dfmcwhir/Multi_Architecture_DIY_Computer/Add-On_Cards/ISA_ESP32_VGA/Firmware/esp32s3-vga-adapter/docs/demo-frame.png

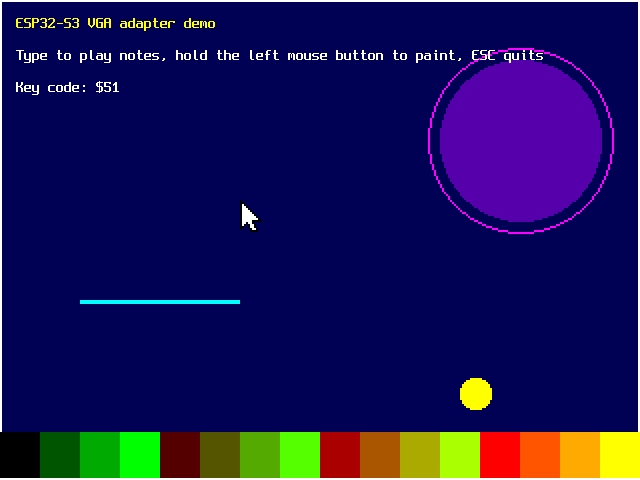
Add-On_Cards/ISA_ESP32_VGA/Firmware/esp32s3-vga-adapter/docs/demo-frame.png
