dfmcwhir/Multi_Architecture_DIY_Computer/ISA_6502/6502_Software/breaker/screenshots/three_balls.png

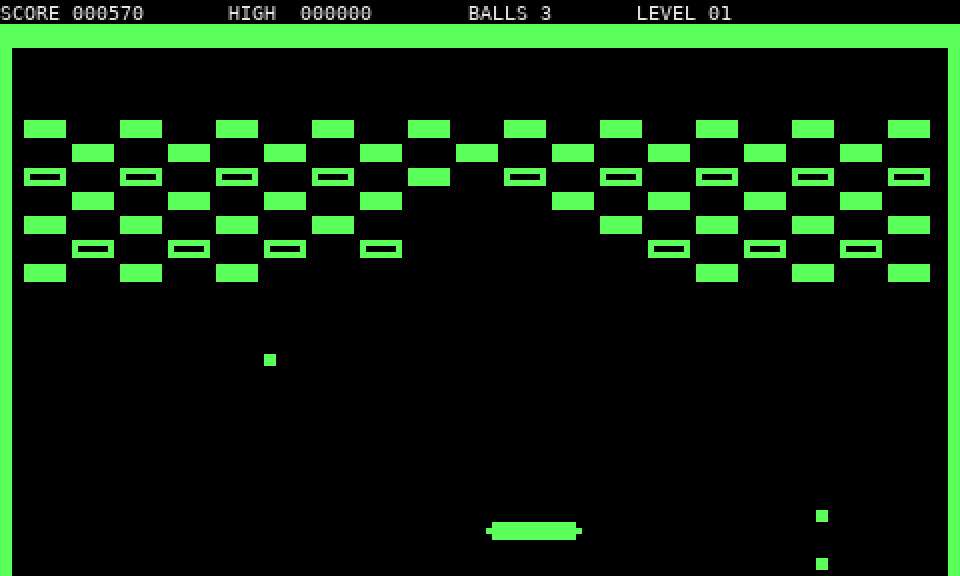
ISA_6502/6502_Software/breaker/screenshots/three_balls.png
