dfmcwhir/Multi_Architecture_DIY_Computer/ISA_6502/6502_Software/doom/screenshots/brute.png

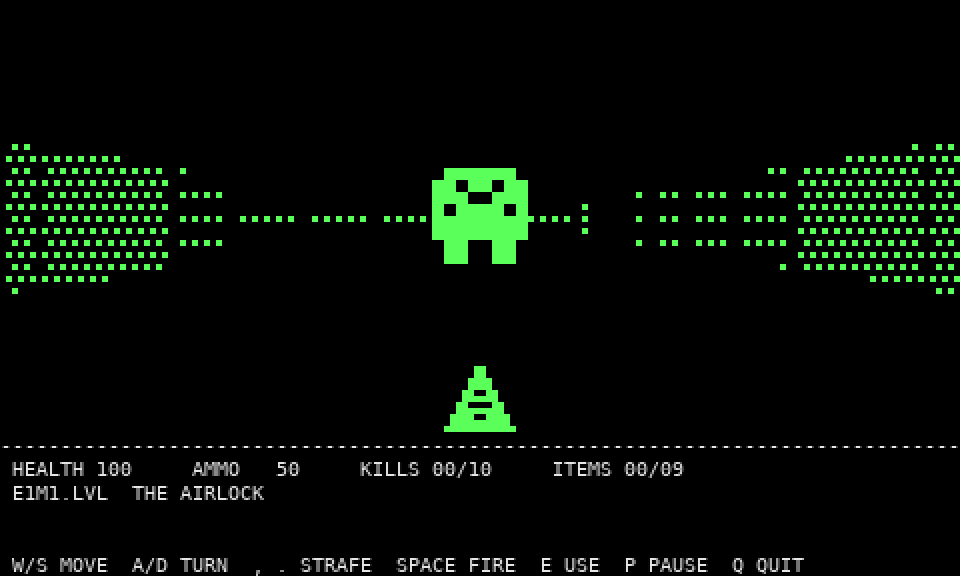
ISA_6502/6502_Software/doom/screenshots/brute.png
