dfmcwhir/Multi_Architecture_DIY_Computer/ISA_6502/6502_Software/doom/screenshots/e1m2.png

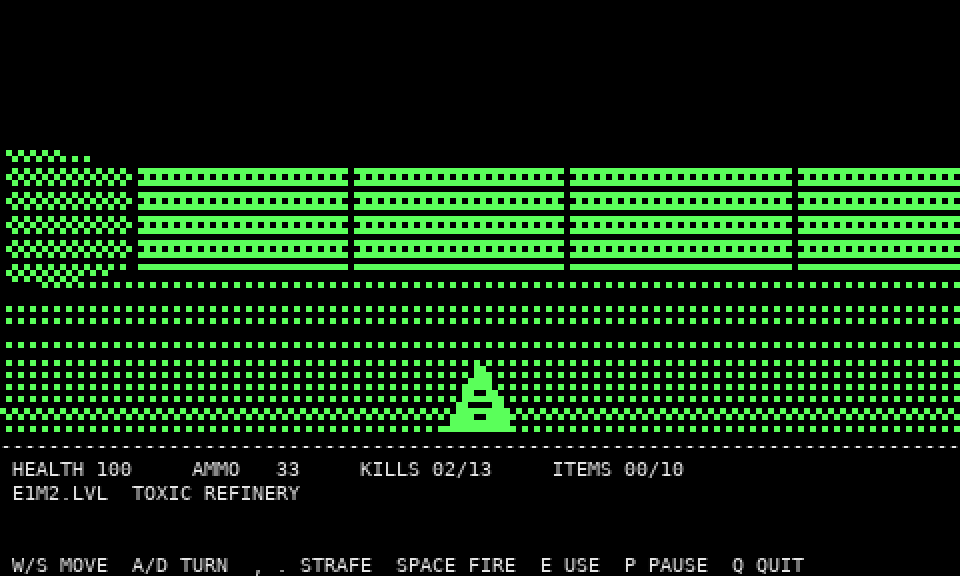
ISA_6502/6502_Software/doom/screenshots/e1m2.png
