dfmcwhir/Multi_Architecture_DIY_Computer/ISA_6502/6502_Software/doom/screenshots/no_sbc_load.png

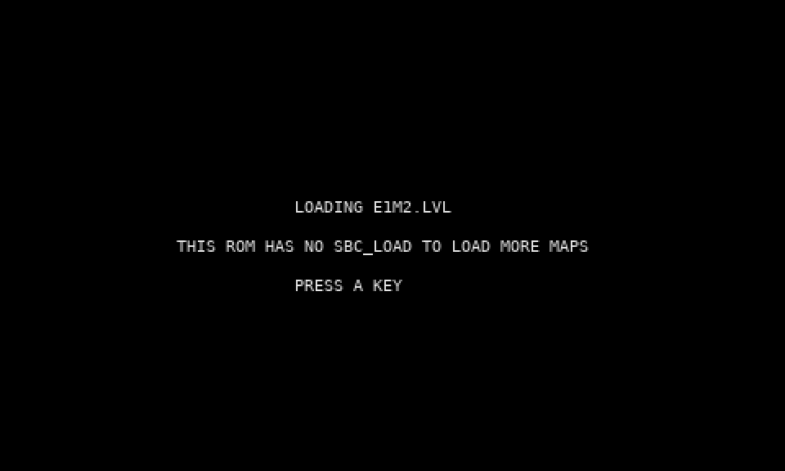
ISA_6502/6502_Software/doom/screenshots/no_sbc_load.png
