dfmcwhir/Multi_Architecture_DIY_Computer/ISA_6502/6502_Software/grabber/screenshots/title.png

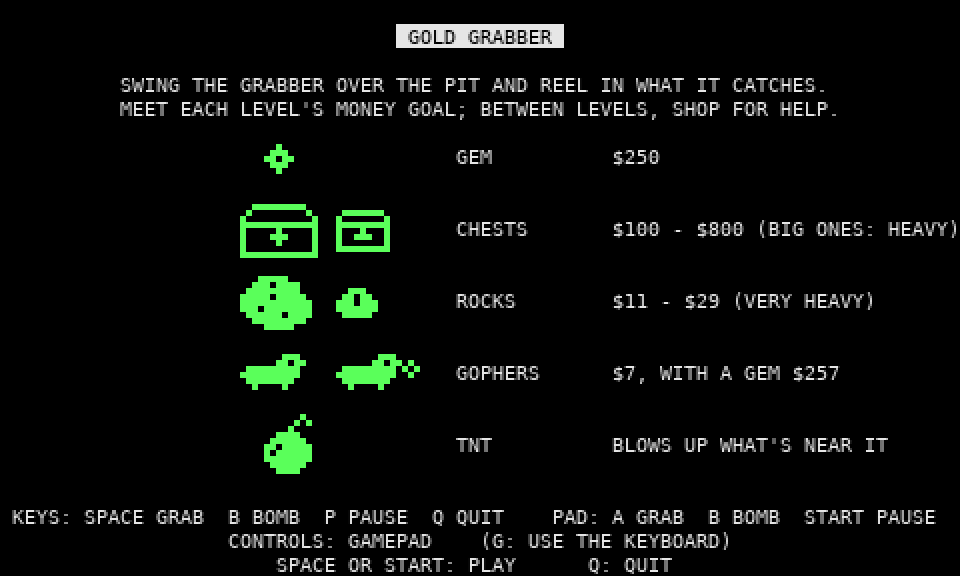
ISA_6502/6502_Software/grabber/screenshots/title.png
