dfmcwhir/Multi_Architecture_DIY_Computer/ISA_6502/6502_Software/invaders/screenshots/later_wave.png

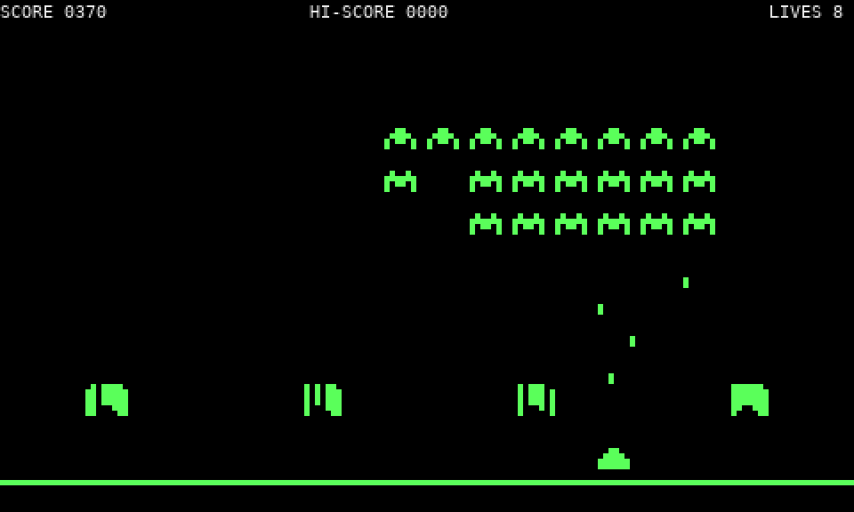
ISA_6502/6502_Software/invaders/screenshots/later_wave.png
