dfmcwhir/Multi_Architecture_DIY_Computer/ISA_6502/6502_Software/miner/screenshots/boot_sector.png

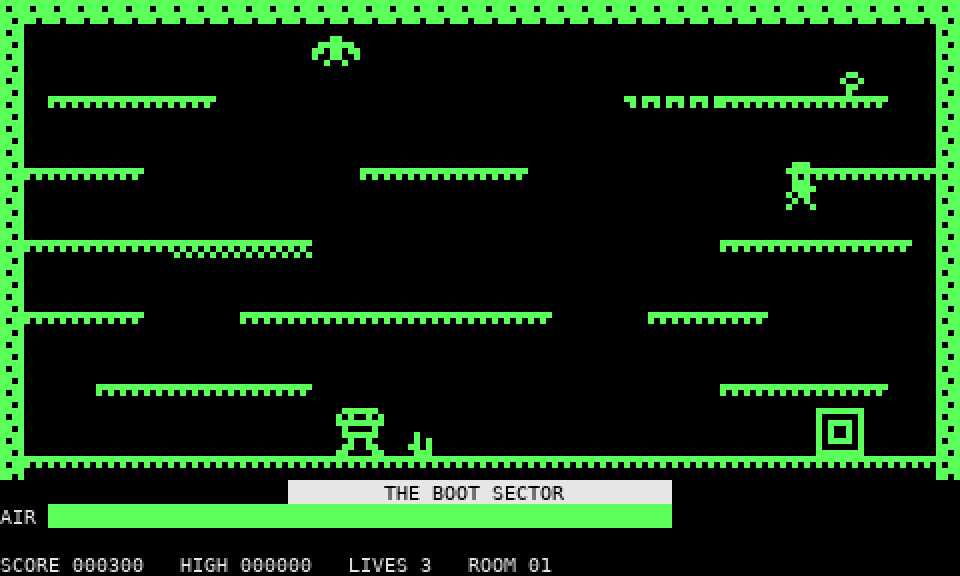
ISA_6502/6502_Software/miner/screenshots/boot_sector.png
