dfmcwhir/Multi_Architecture_DIY_Computer/ISA_6502/6502_Software/miner/screenshots/reset_vector.png

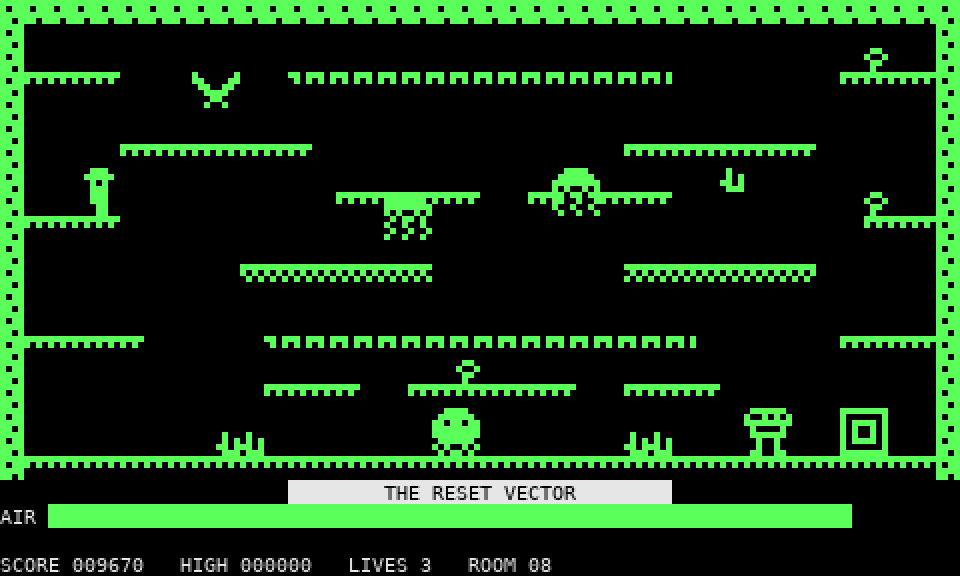
ISA_6502/6502_Software/miner/screenshots/reset_vector.png
