dfmcwhir/Multi_Architecture_DIY_Computer/ISA_6502/6502_Software/miner/screenshots/zero_page.png

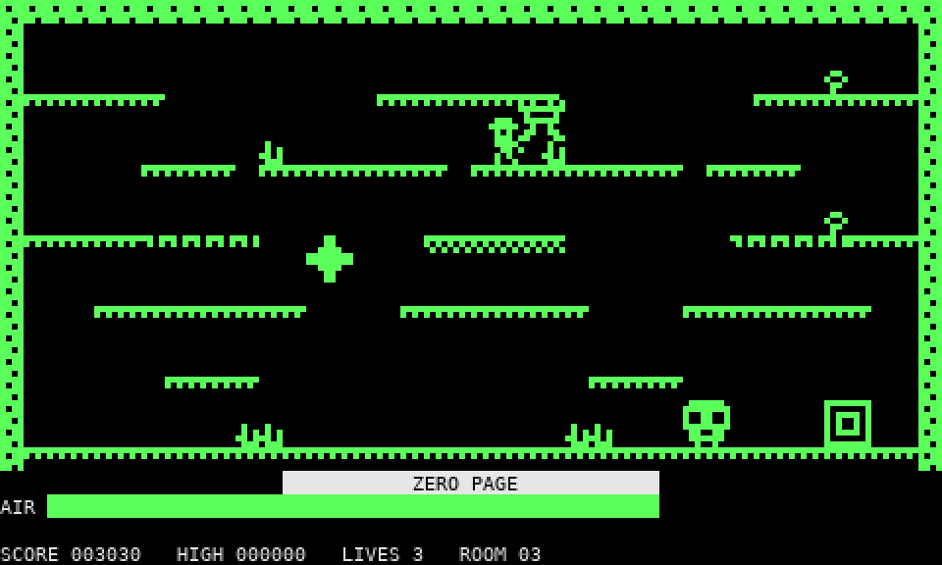
ISA_6502/6502_Software/miner/screenshots/zero_page.png
