dfmcwhir/Multi_Architecture_DIY_Computer/ISA_6502/6502_Software/muncher/screenshots/playing_gamepad.png

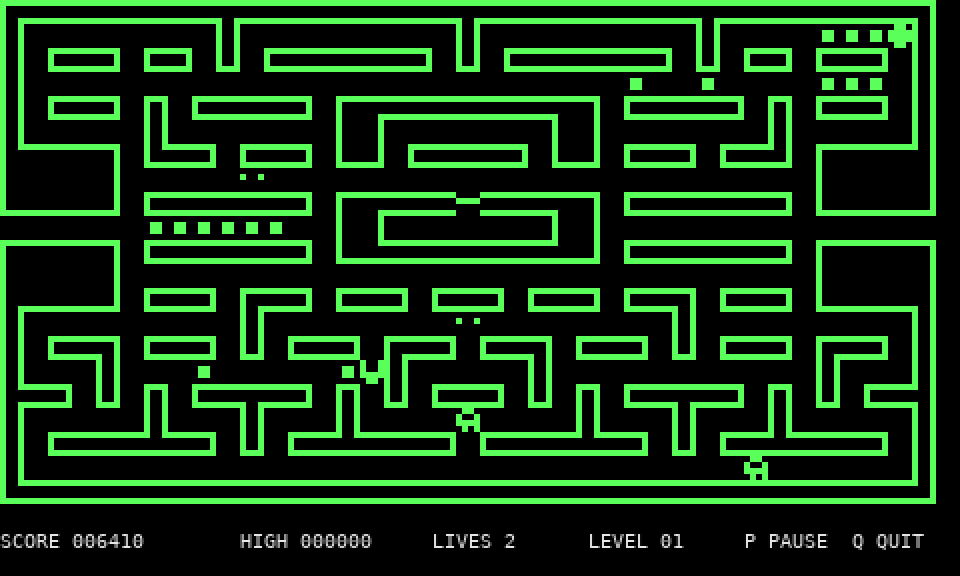
ISA_6502/6502_Software/muncher/screenshots/playing_gamepad.png
