dfmcwhir/Multi_Architecture_DIY_Computer/ISA_6502/6502_Software/rocks/screenshots/saucer.png

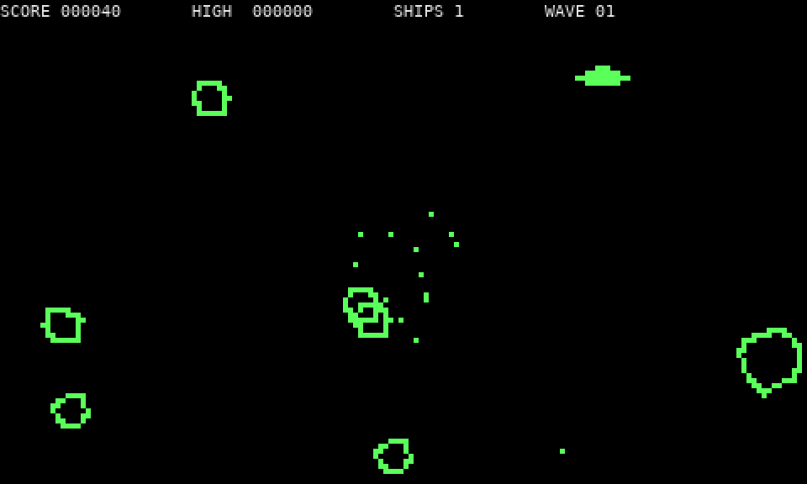
ISA_6502/6502_Software/rocks/screenshots/saucer.png
