dfmcwhir/Multi_Architecture_DIY_Computer/ISA_6502/6502_Software/smb/screenshots/bonus_exit_1-2.png

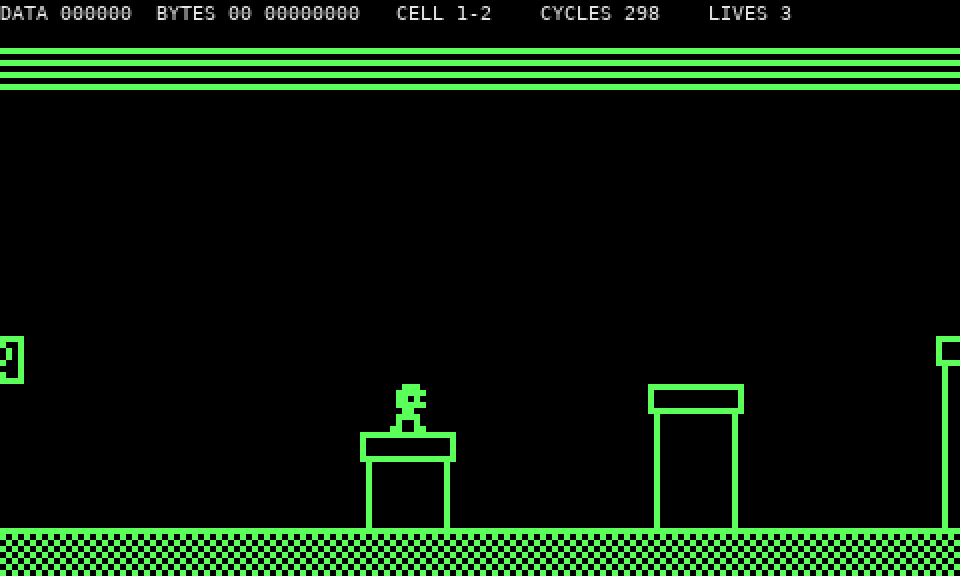
ISA_6502/6502_Software/smb/screenshots/bonus_exit_1-2.png
