dfmcwhir/Multi_Architecture_DIY_Computer/ISA_6502/6502_Software/smb/screenshots/bonus_room.png

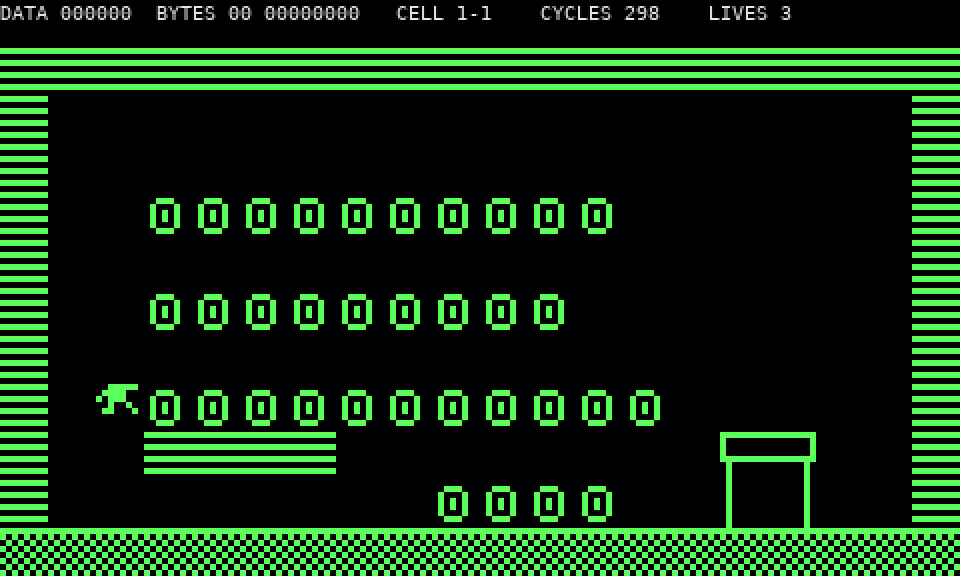
ISA_6502/6502_Software/smb/screenshots/bonus_room.png
