dfmcwhir/Multi_Architecture_DIY_Computer/ISA_6502/6502_Software/smb/screenshots/fire_flower.png

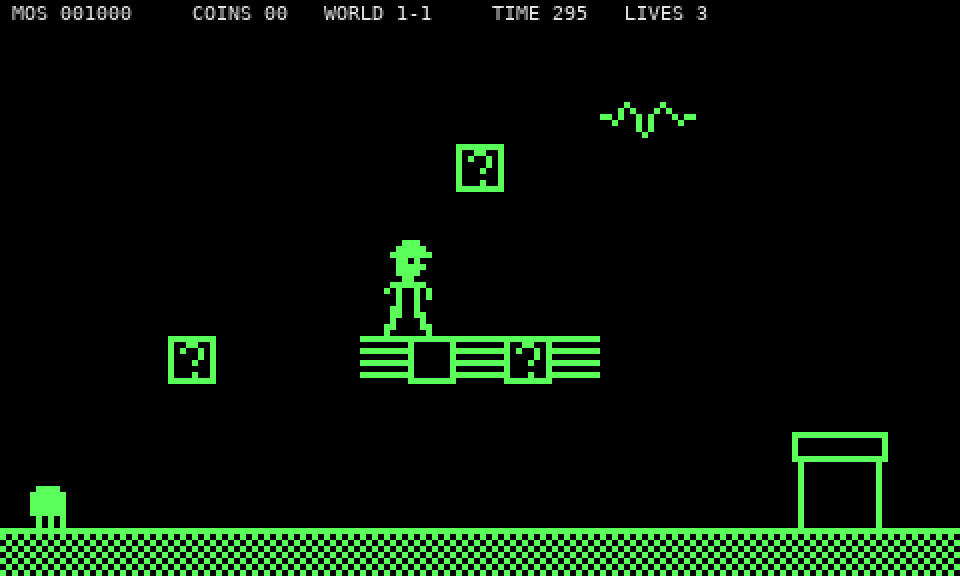
ISA_6502/6502_Software/smb/screenshots/fire_flower.png
