dfmcwhir/Multi_Architecture_DIY_Computer/ISA_6502/6502_Software/smb/screenshots/oc_device.png

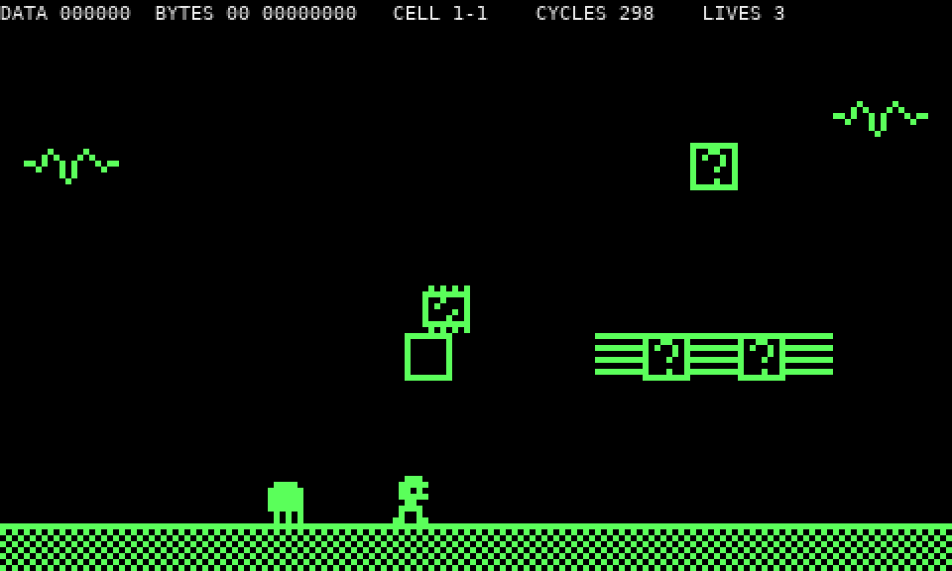
ISA_6502/6502_Software/smb/screenshots/oc_device.png
