dfmcwhir/Multi_Architecture_DIY_Computer/ISA_6502/6502_Software/smb/screenshots/terminal_sprites.png

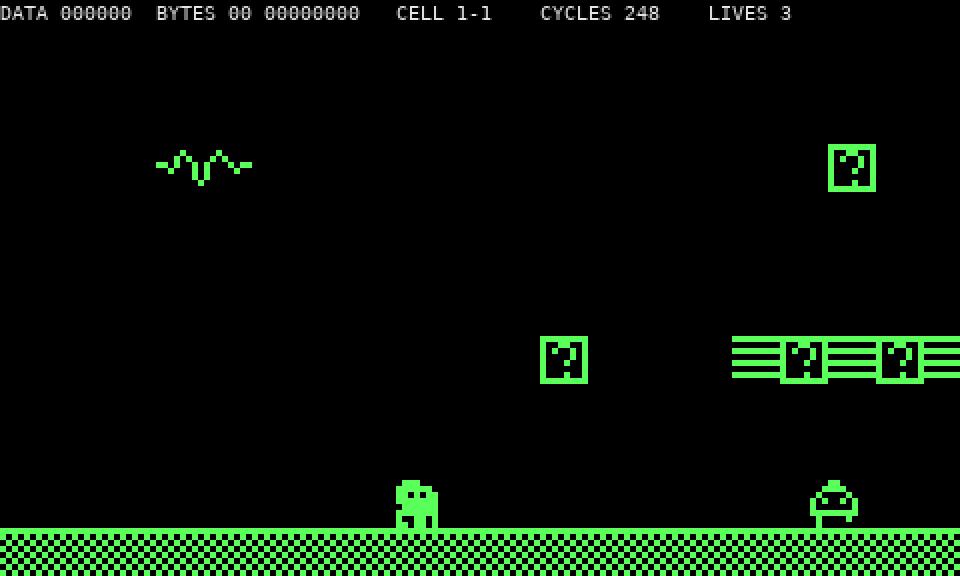
ISA_6502/6502_Software/smb/screenshots/terminal_sprites.png
