dfmcwhir/Multi_Architecture_DIY_Computer/ISA_6502/6502_Software/stacker/screenshots/playing.png

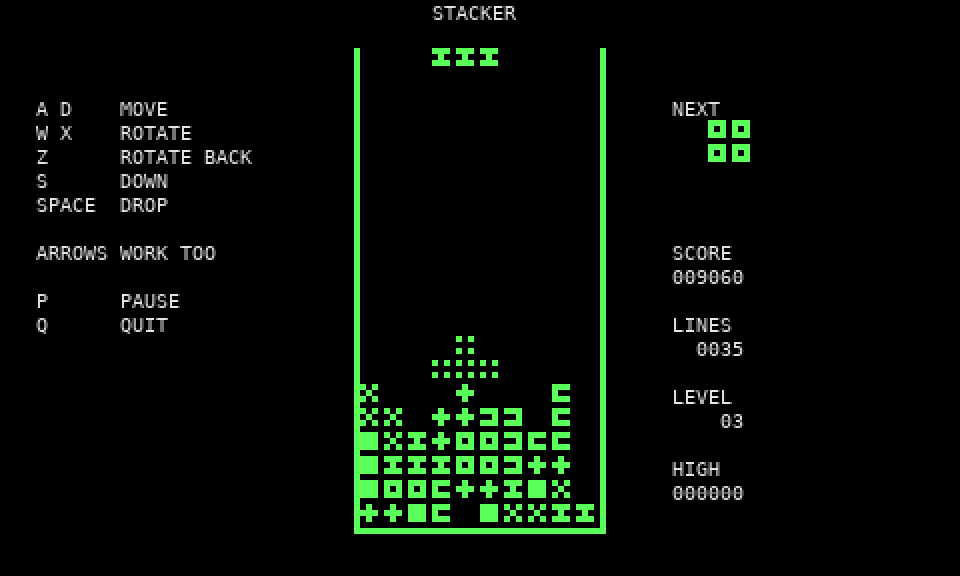
ISA_6502/6502_Software/stacker/screenshots/playing.png
