dfmcwhir/Multi_Architecture_DIY_Computer/ISA_6502/6502_Software/critters/screenshots/level4_building.png

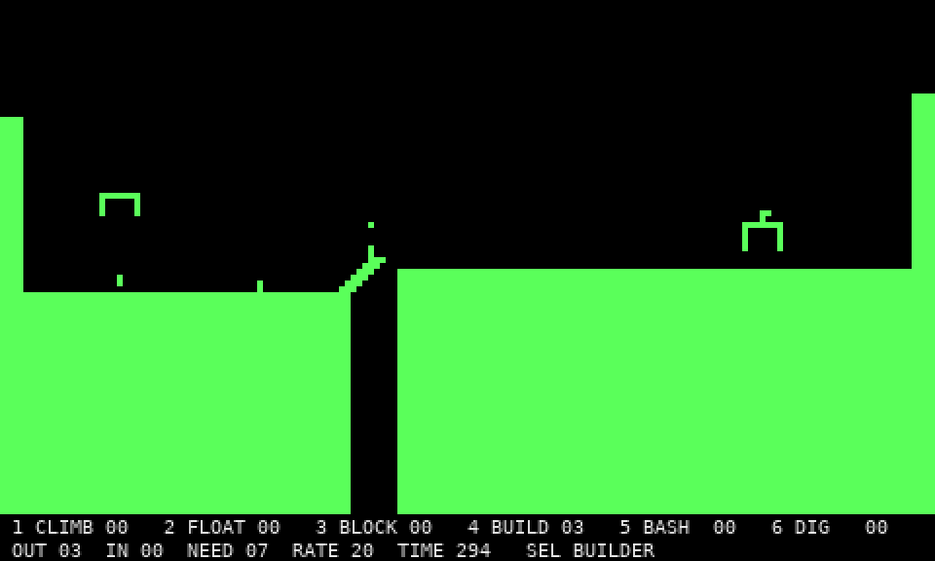
ISA_6502/6502_Software/critters/screenshots/level4_building.png
