dfmcwhir/Multi_Architecture_DIY_Computer/ISA_Z80/ISA_Z80_Schematics.pdf

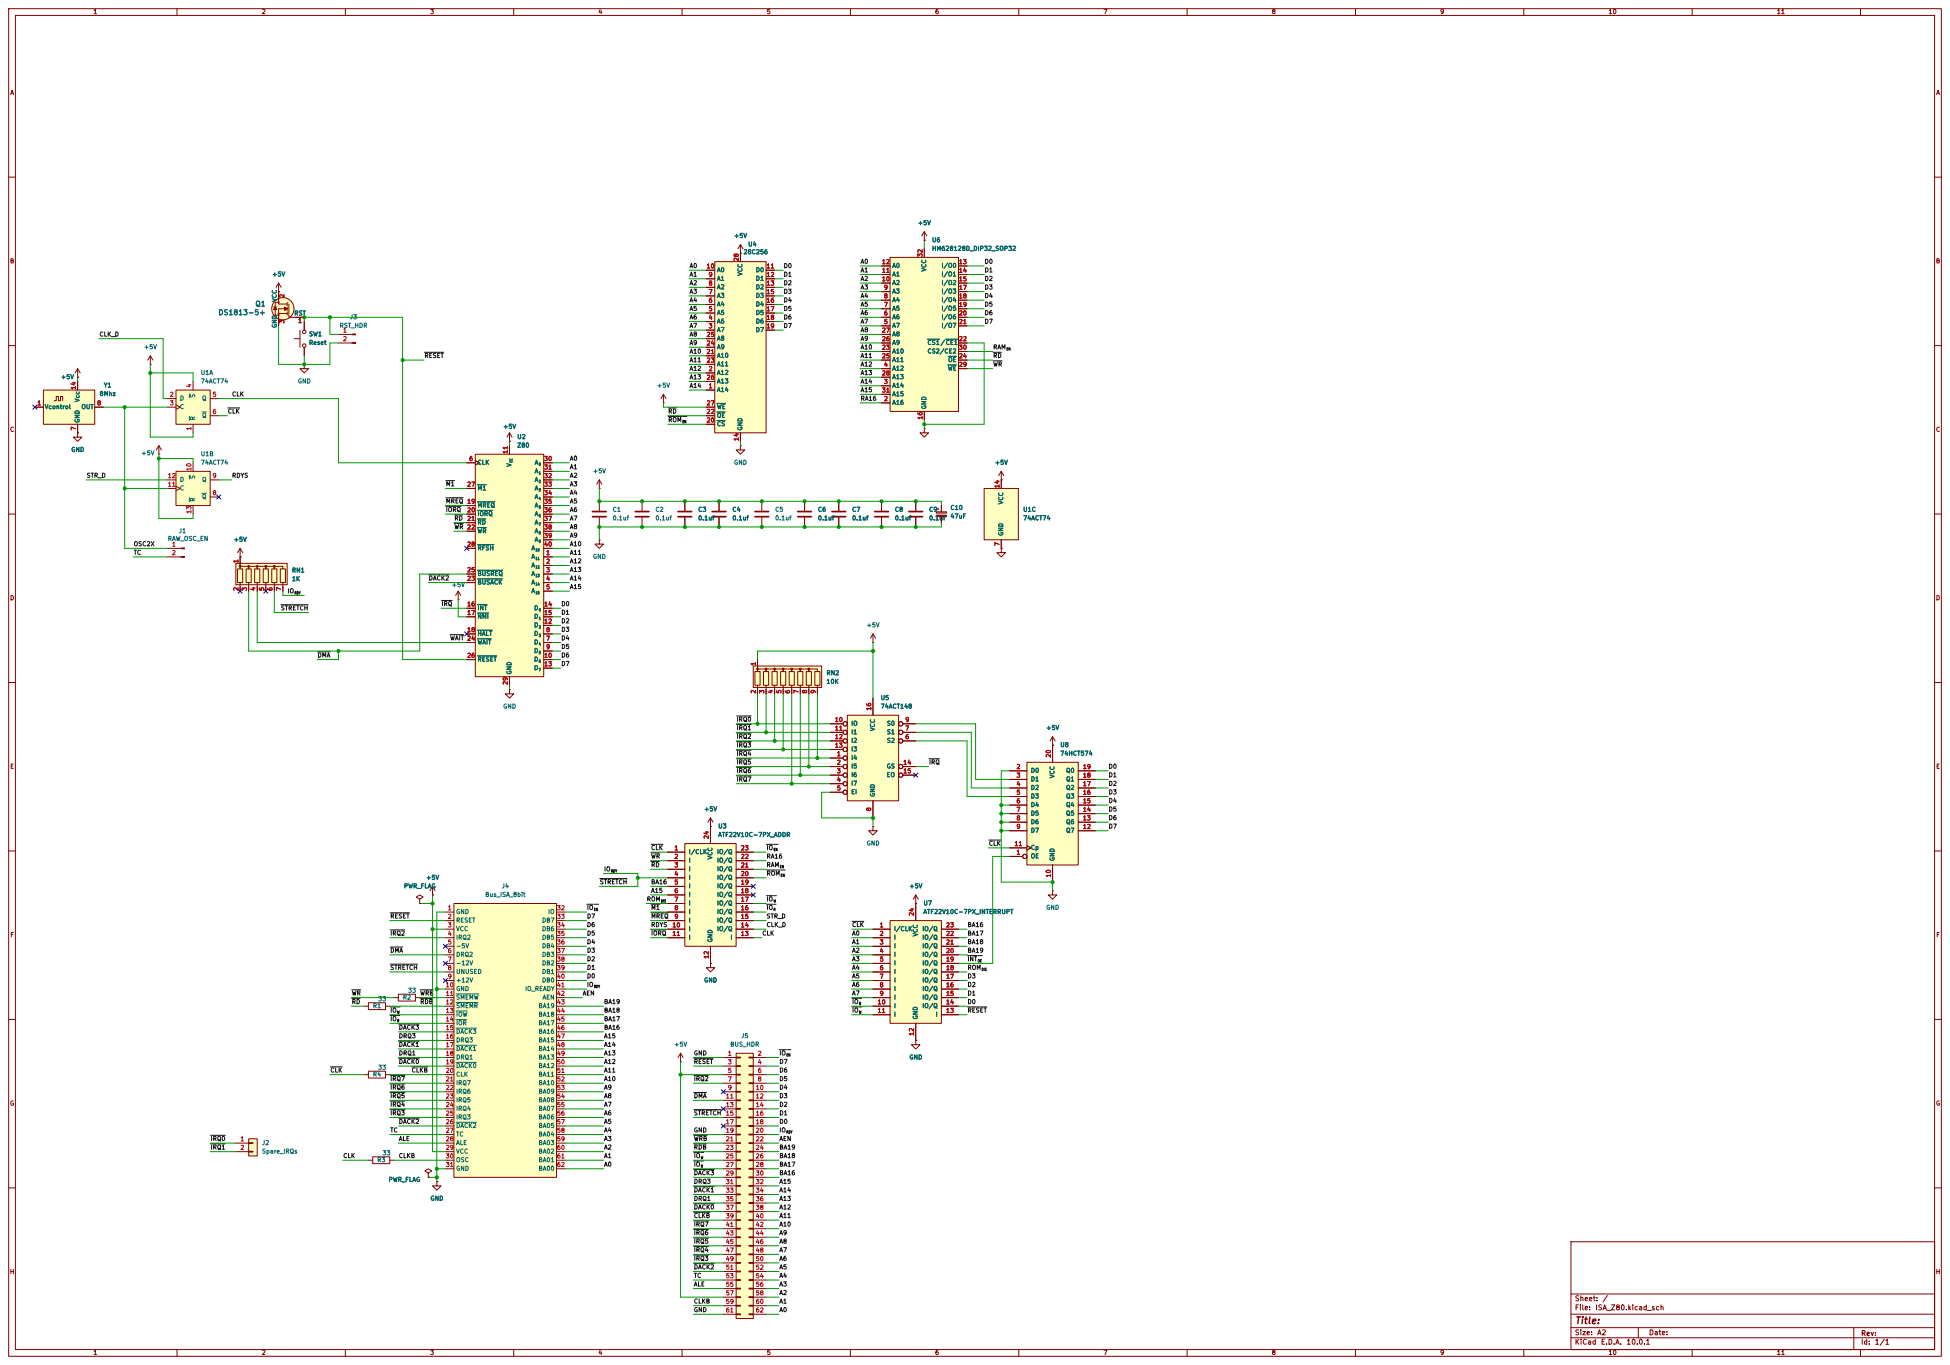
[picture p75: page 1]

Size: A2 | Rev:
KiCad E.D.A. 10.0.1 | Id: 1/1
