dfmcwhir/Multi_Architecture_DIY_Computer/Add-On_Cards/ISA_PICO9918_VGA/ISA_PICO9918_VGA_Schematics.pdf

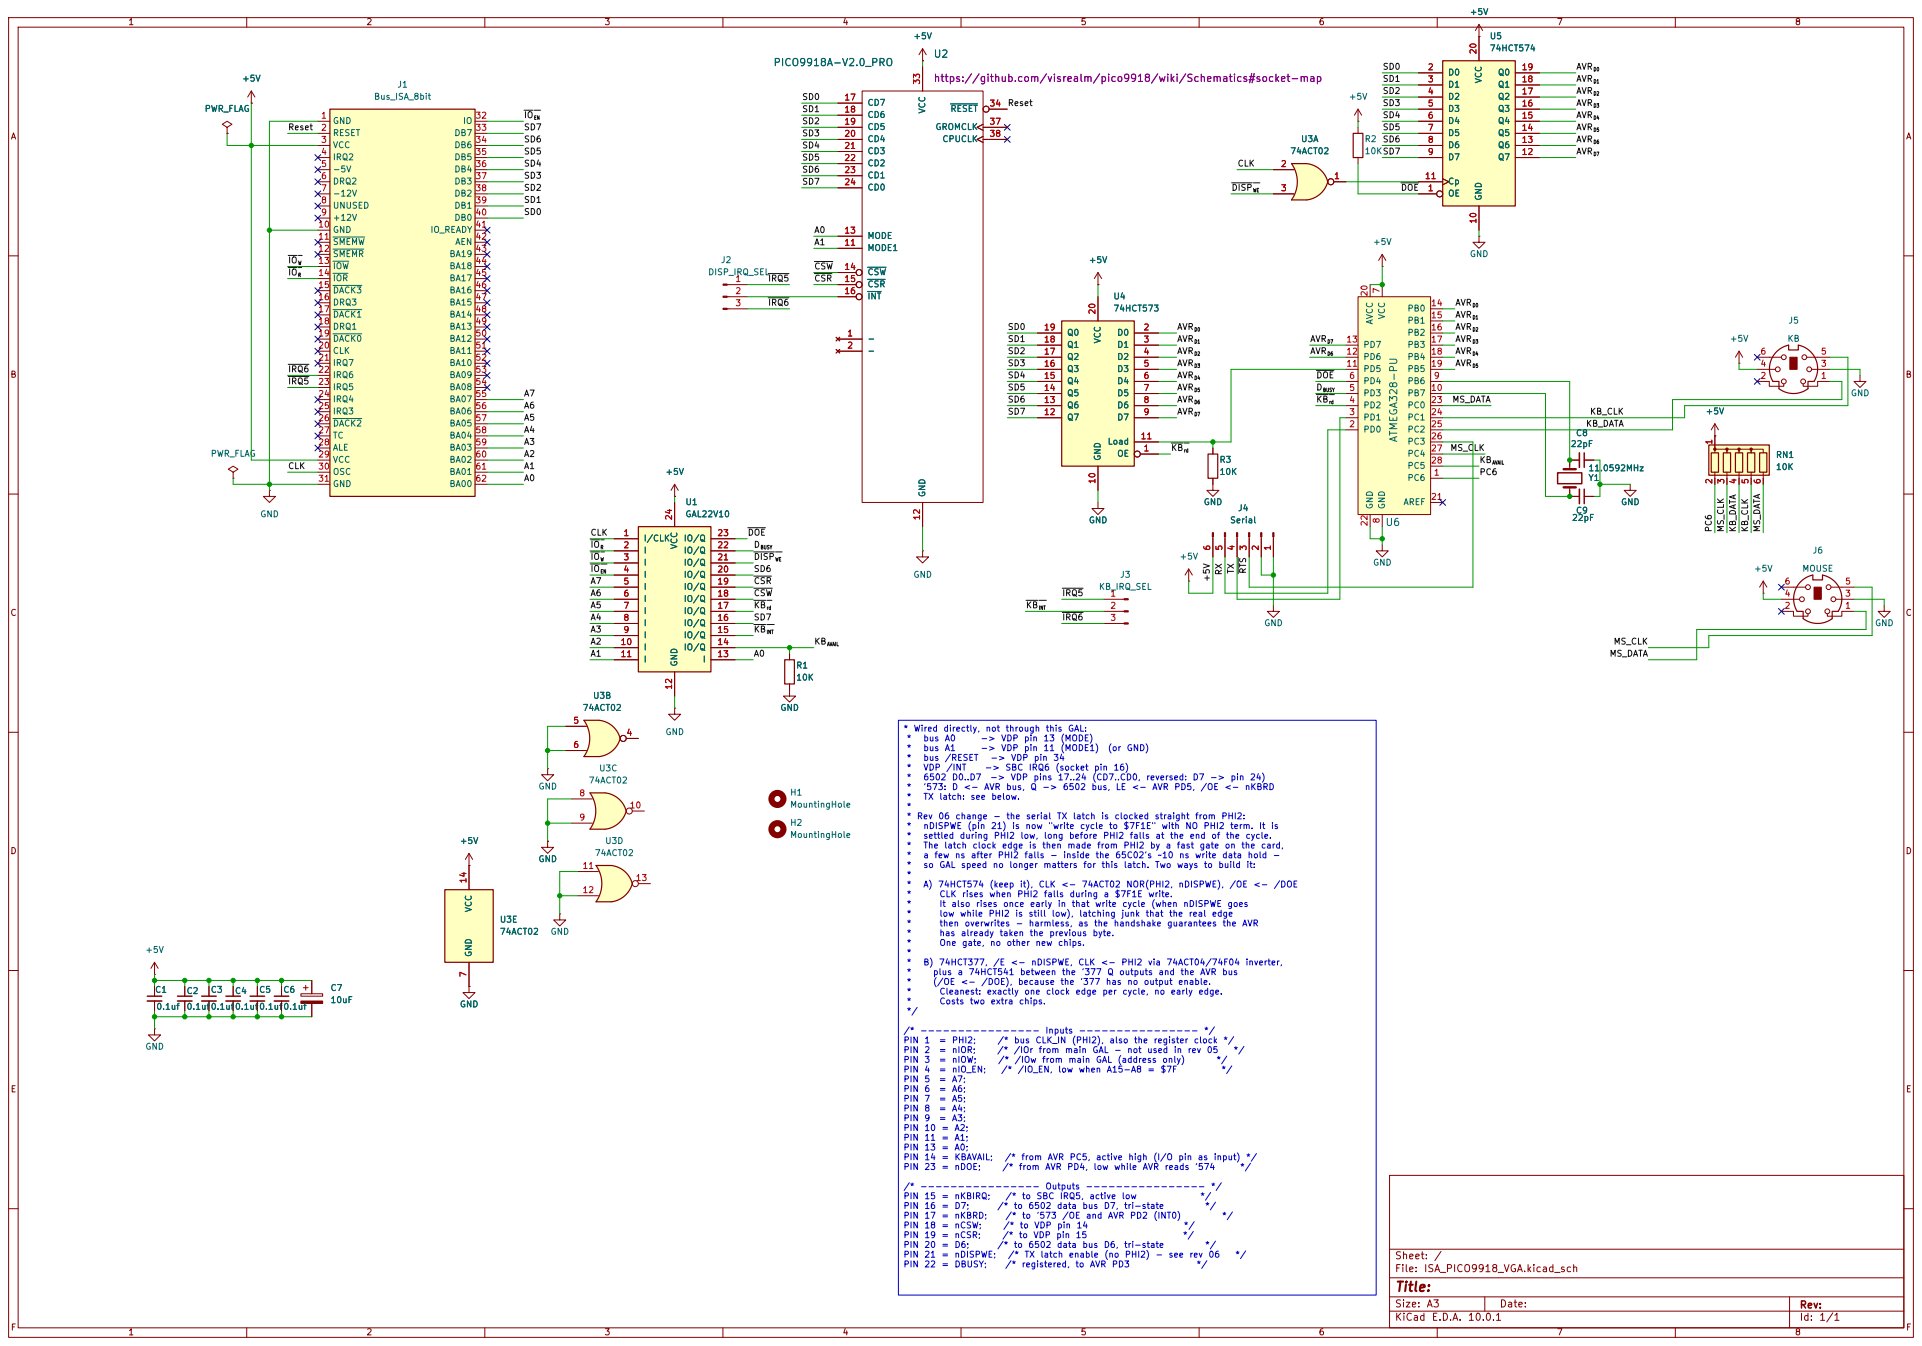
[picture p76: page 1]

https://github.com/visrealm/pico9918/wiki/Schematics#socket-map -

https://github.com/visrealm/pico9918/wiki/Schematics#socket-map
Reset SD5

Size: A3 | Rev: | F Date:
KiCad E.D.A. 10.0.1 | Id: 1/1
