dfmcwhir/Multi_Architecture_DIY_Computer/Add-On_Cards/ISA_AY-3-8910_Sound/ISA_AY-3-8910_Sound_schematics.pdf

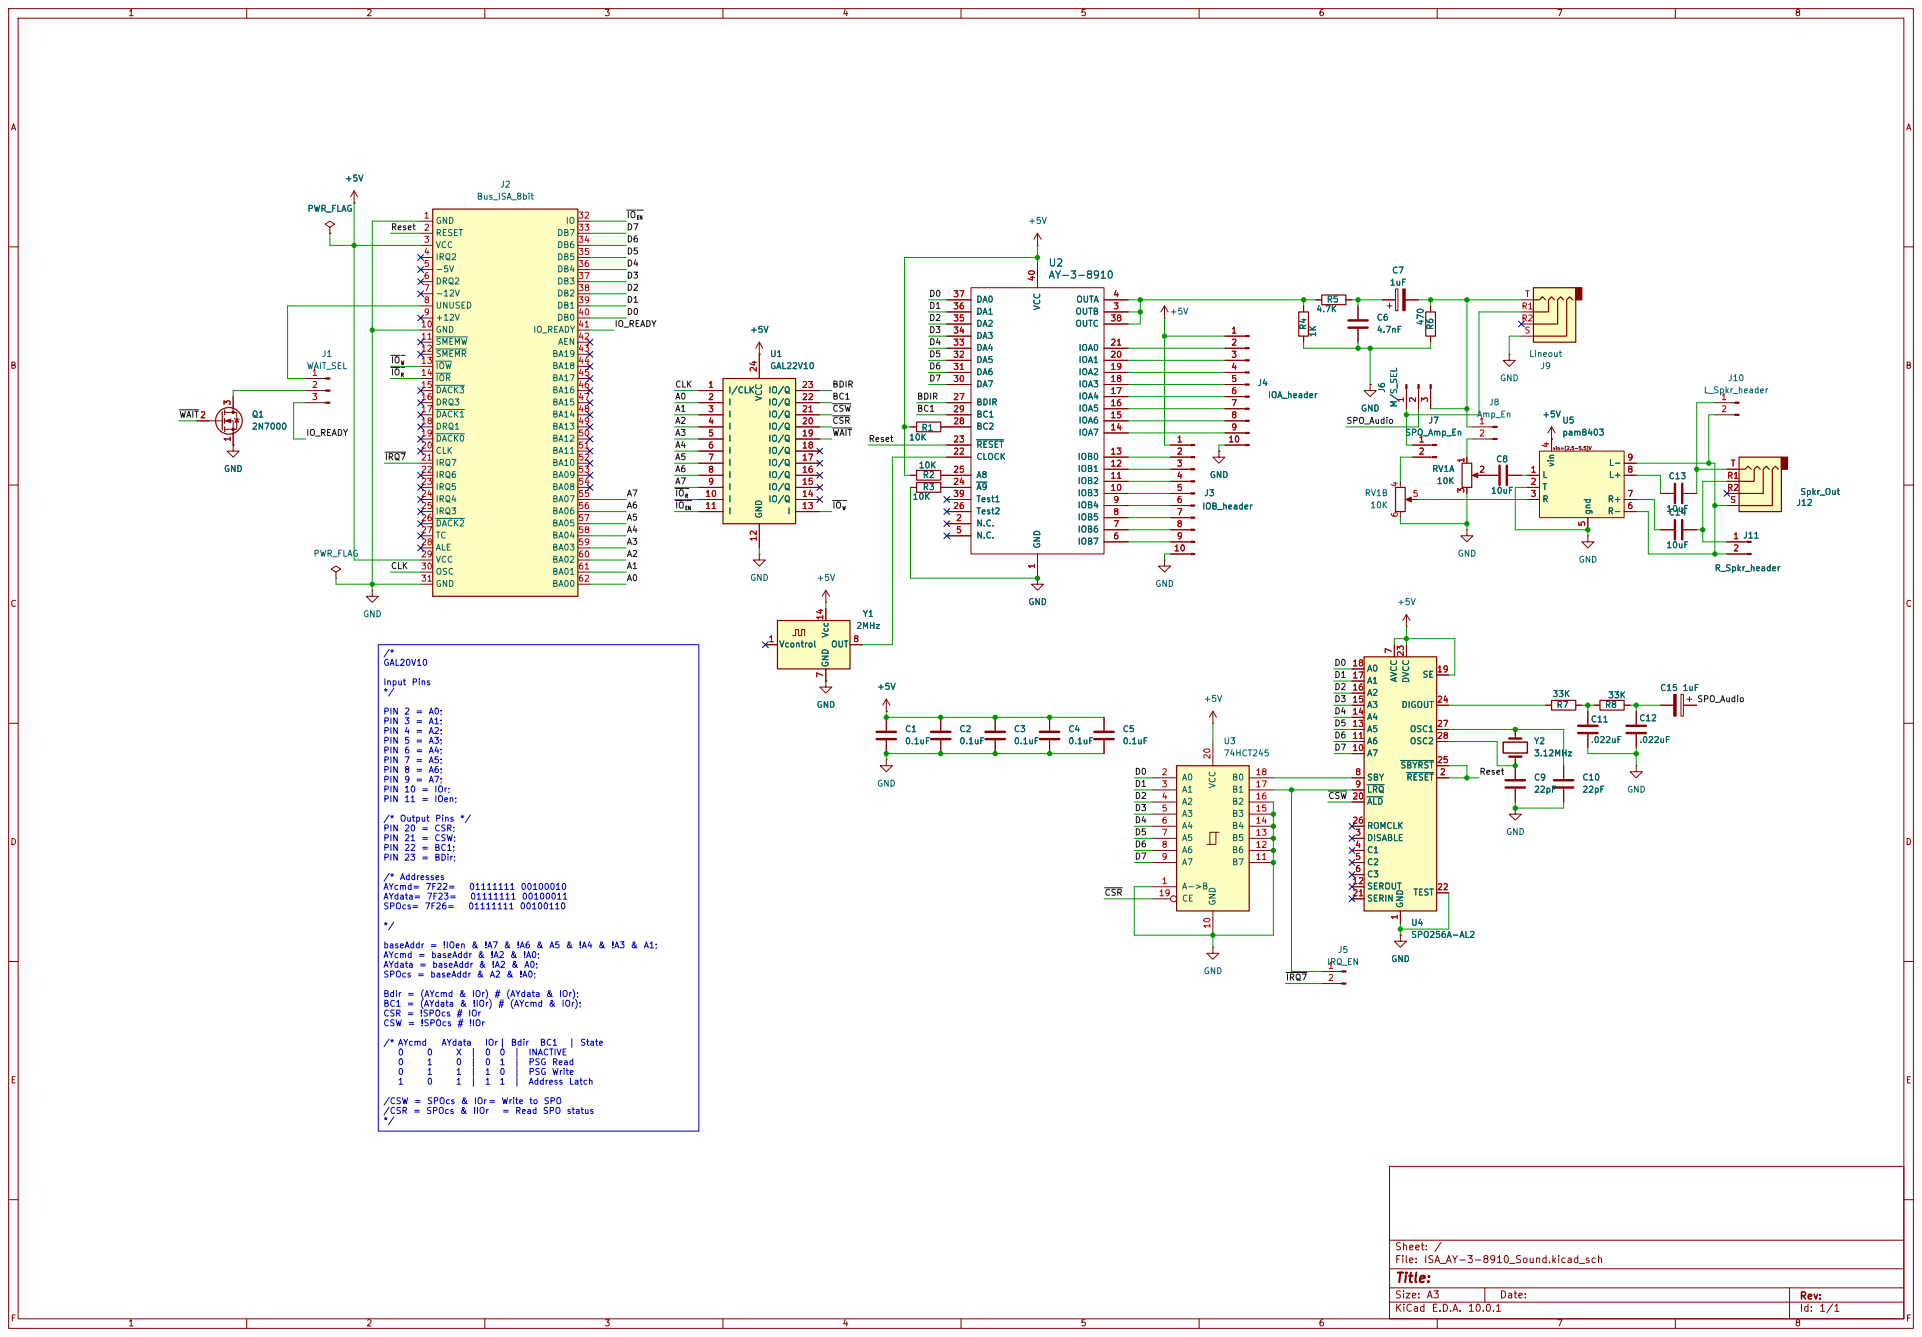
[picture p77: page 1]

PIN 2 = A0; PIN 3 = A1; PIN 4 = A2; PIN 5 = A3; PIN 6 = A4; PIN 7 = A5; PIN 8 = A6; PIN 9 = A7; PIN 10 = IOr; PIN 11 = IOen;

/* Output Pins */
PIN 20 = CSR; PIN 21 = CSW; PIN 22 = BC1; PIN 23 = BDir;

Size: A3 | Rev: | F Date:
KiCad E.D.A. 10.0.1 | Id: 1/1
