dfmcwhir/Multi_Architecture_DIY_Computer/Add-On_Cards/ISA_ESP32_VGA/ISA_ESP32_VGA_Schematics.pdf

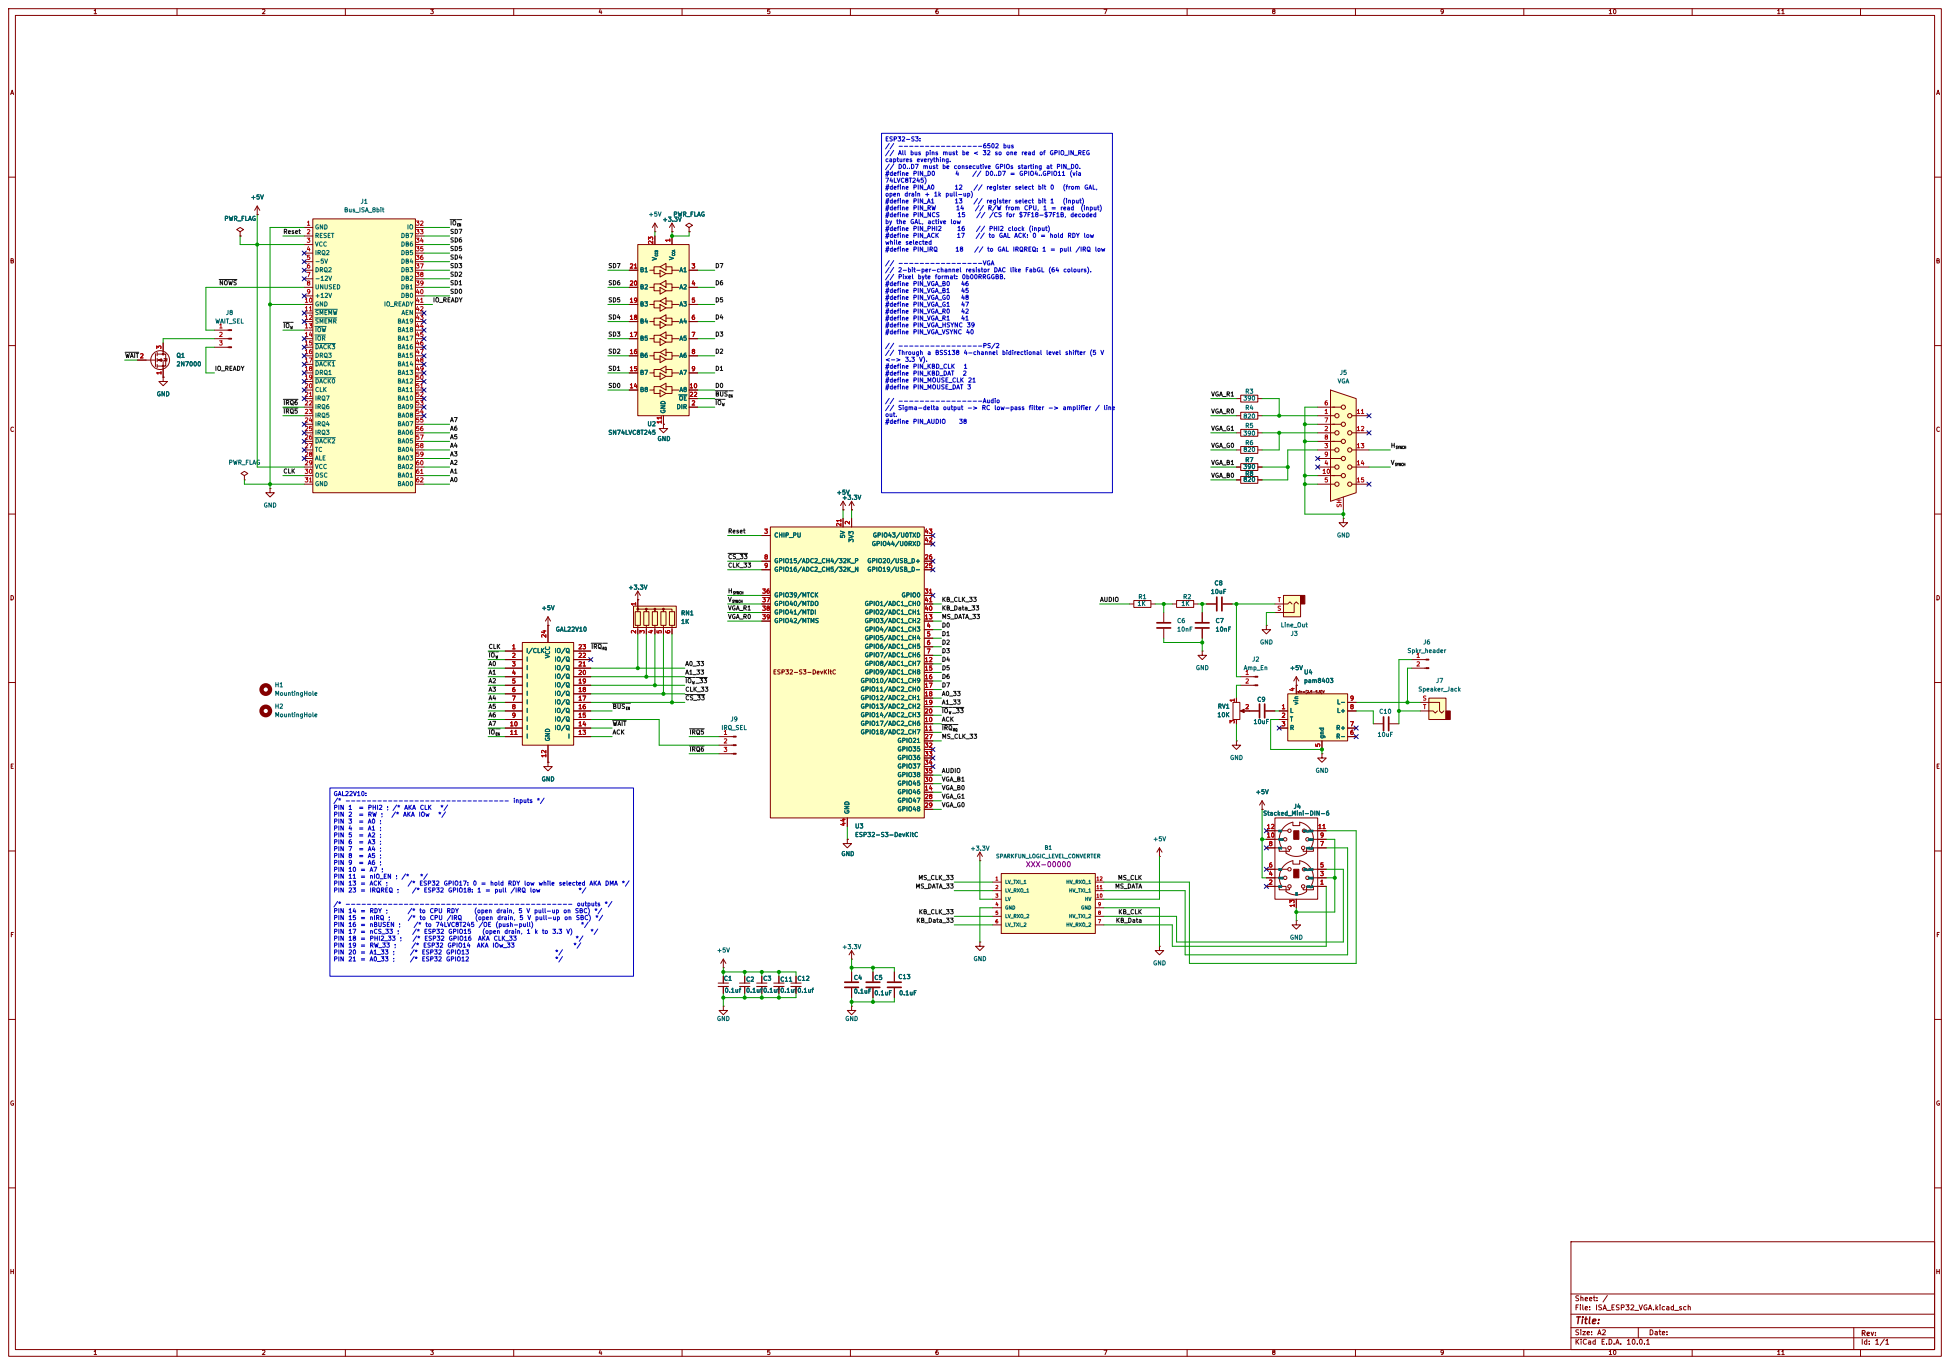
[picture p78: page 1]

ESP32-S3: // ----------------6502 bus // All bus pins must be < 32 so one read of GPIO_IN_REG

by the GAL, active low

// ----------------VGA // 2-bit-per-channel resistor DAC like FabGL (64 colours).

// Through a BSS138 4-channel bidirectional level shifter (5 V <-> 3.3 V).

Size: A2 | Rev:
KiCad E.D.A. 10.0.1 | Id: 1/1
