dfmcwhir/Multi_Architecture_DIY_Computer/Add-On_Cards/ISA_6502_Memory/ISA_6502_Memory_Schematics.pdf

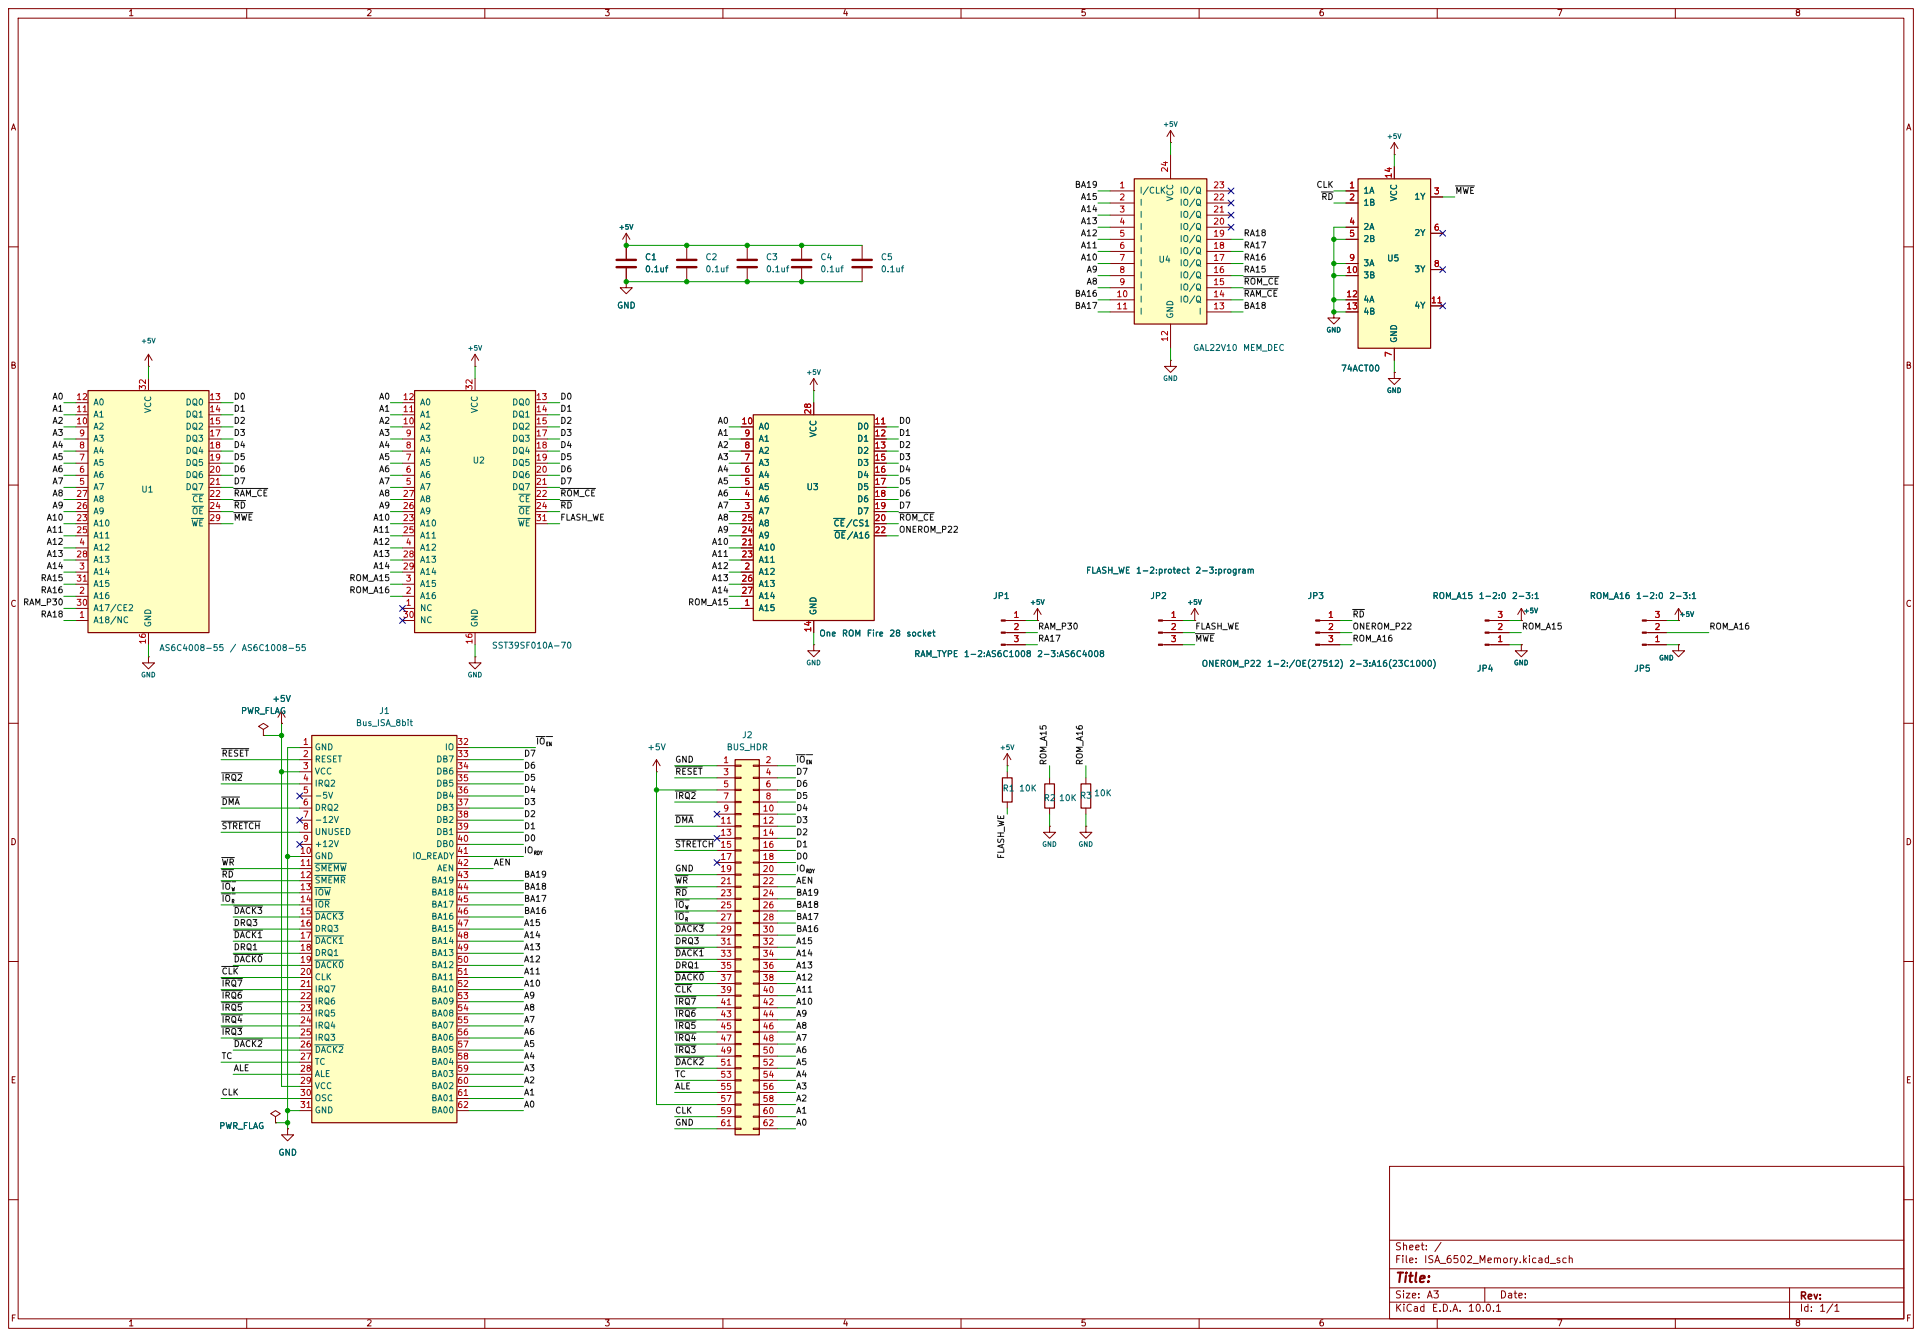
[picture p80: page 1]

Size: A3 | Rev: | F Date:
KiCad E.D.A. 10.0.1 | Id: 1/1
