dfmcwhir/Multi_Architecture_DIY_Computer/ISA_6502/ISA_6502_CPU_REV2/ISA_6502_CPU_REV2_Schematics.pdf

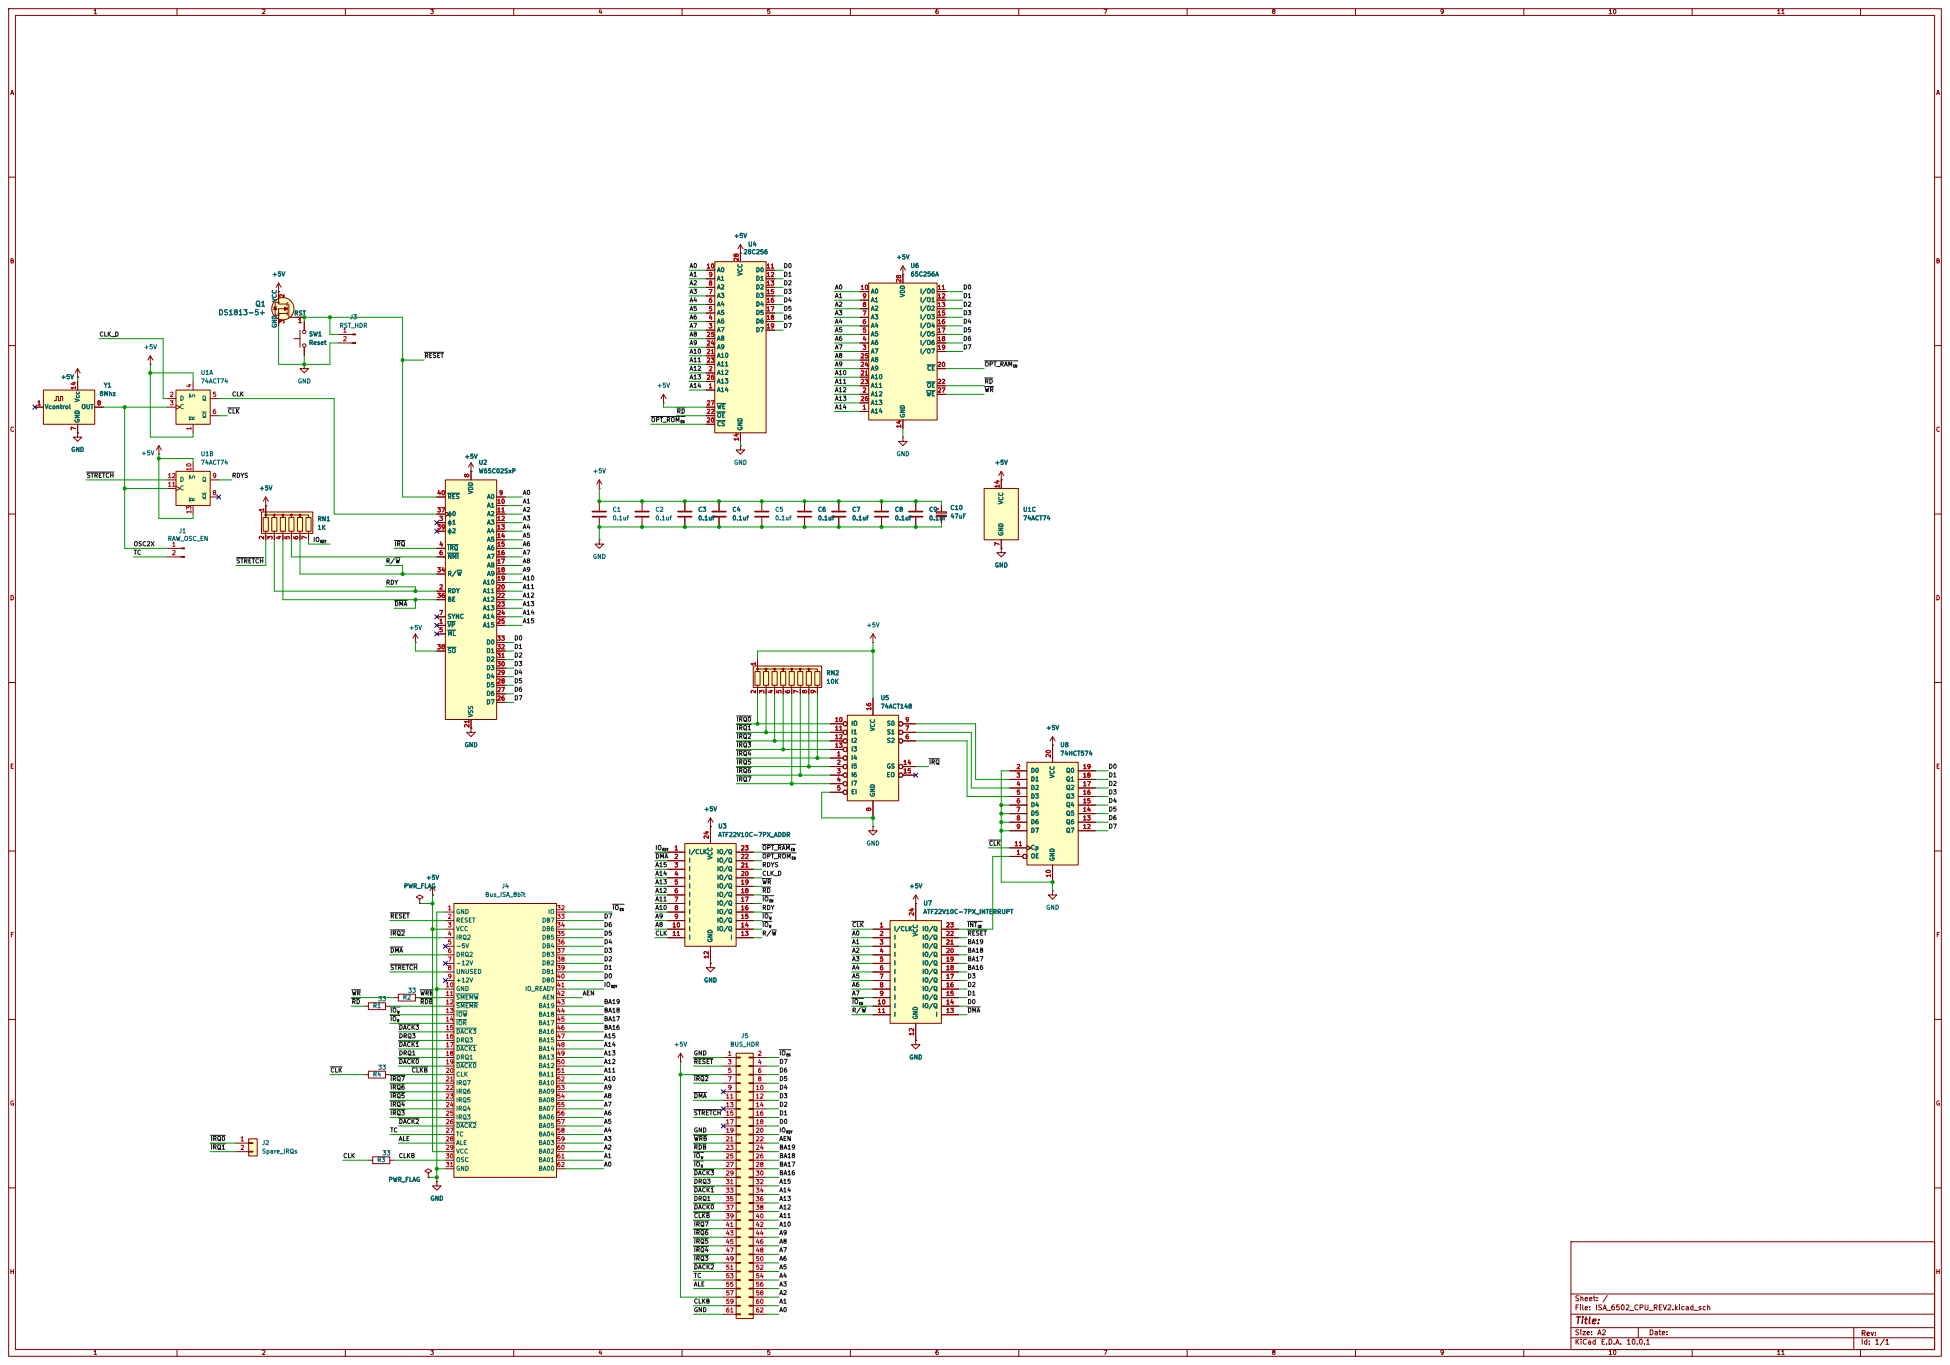
[picture p81: page 1]

Size: A2 | Rev:
KiCad E.D.A. 10.0.1 | Id: 1/1
