dfmcwhir/Multi_Architecture_DIY_Computer/Add-On_Cards/ISA_6502_Serial_Rev3/ISA_6502_Serial_Rev3.pdf

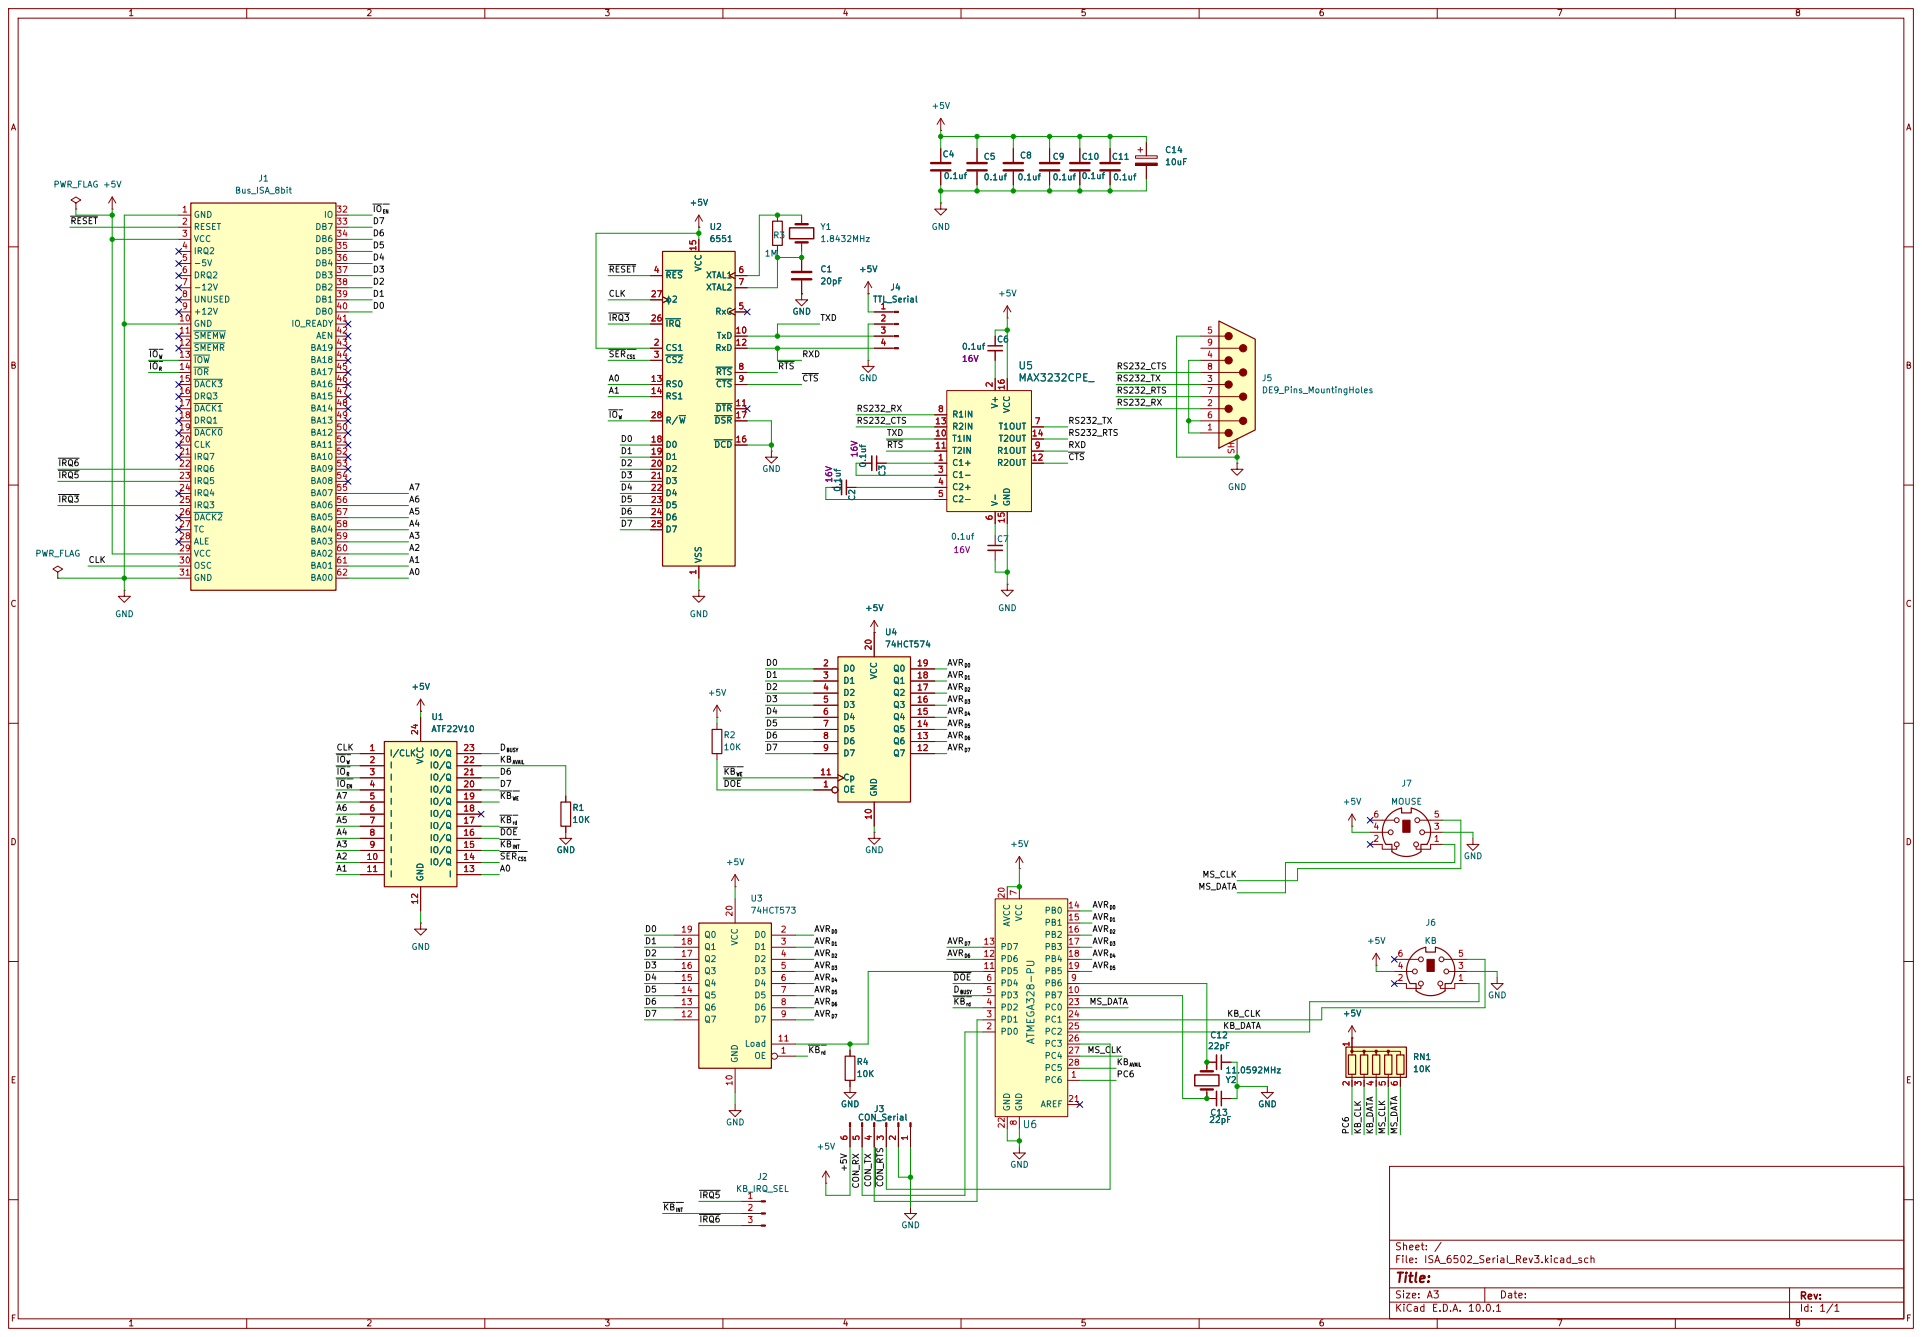
[picture p82: page 1]

Size: A3 | Rev:
KiCad E.D.A. 10.0.1 | Id: 1/1
