dfmcwhir/Multi_Architecture_DIY_Computer/Add-On_Cards/CH376_USB_CARD/CH375_USB_ISA_Card_W_DOC.pdf

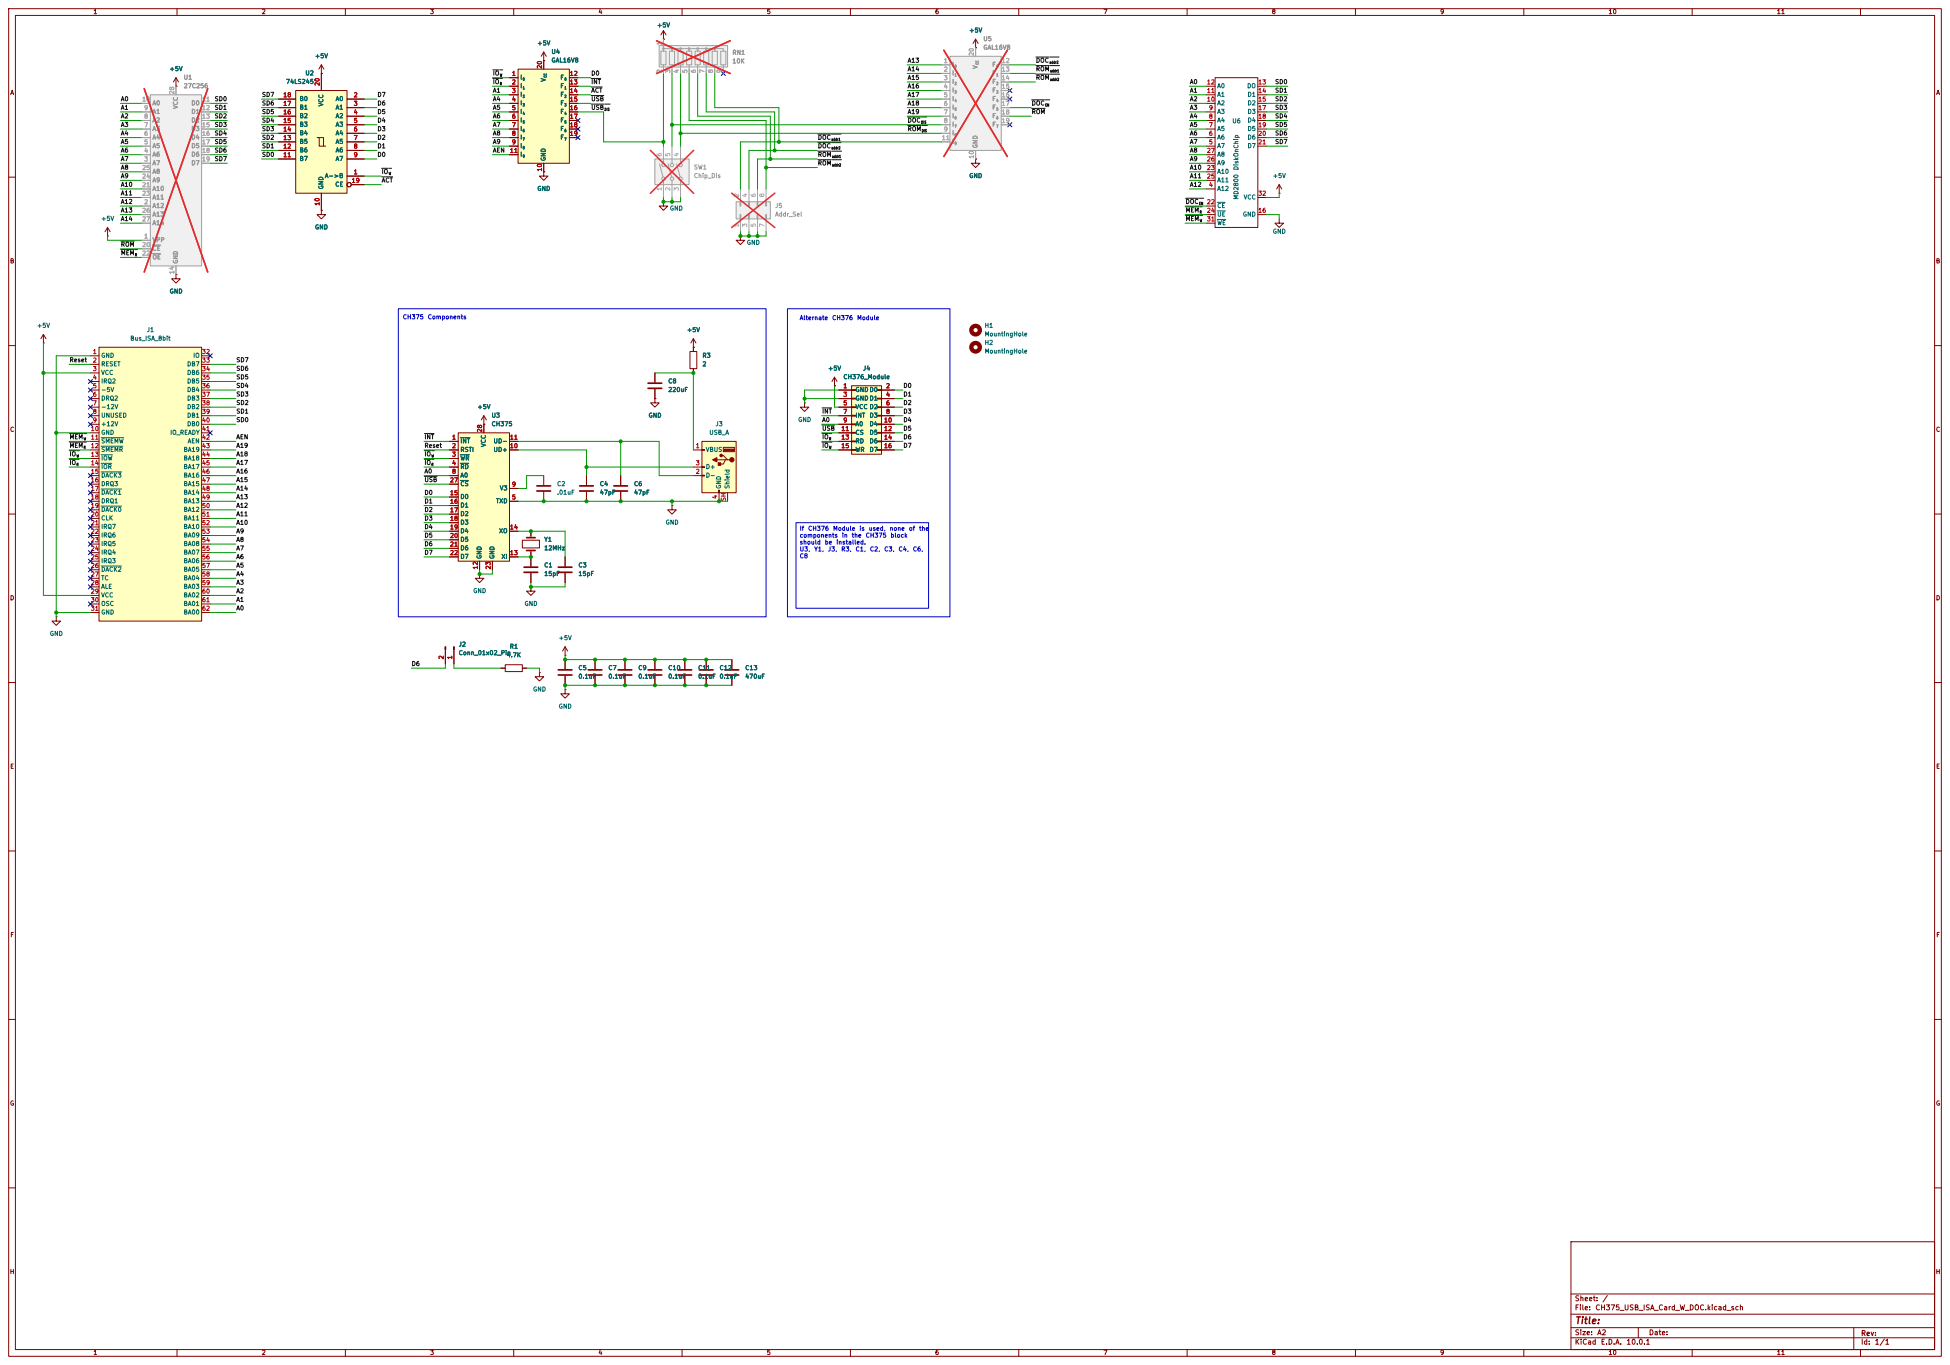
[picture p83: page 1]

IRQ2 4 -5V 5 DRQ2 6 -12V 7 UNUSED 8 +12V 9 GND 10

If CH376 Module is used, none of the
components in the CH375 block

Size: A2 | Rev:
KiCad E.D.A. 10.0.1 | Id: 1/1
