dfmcwhir/Multi_Architecture_DIY_Computer/Add-On_Cards/ISA_6502_Serial/ISA_6502_SERIAL_Schematics.pdf

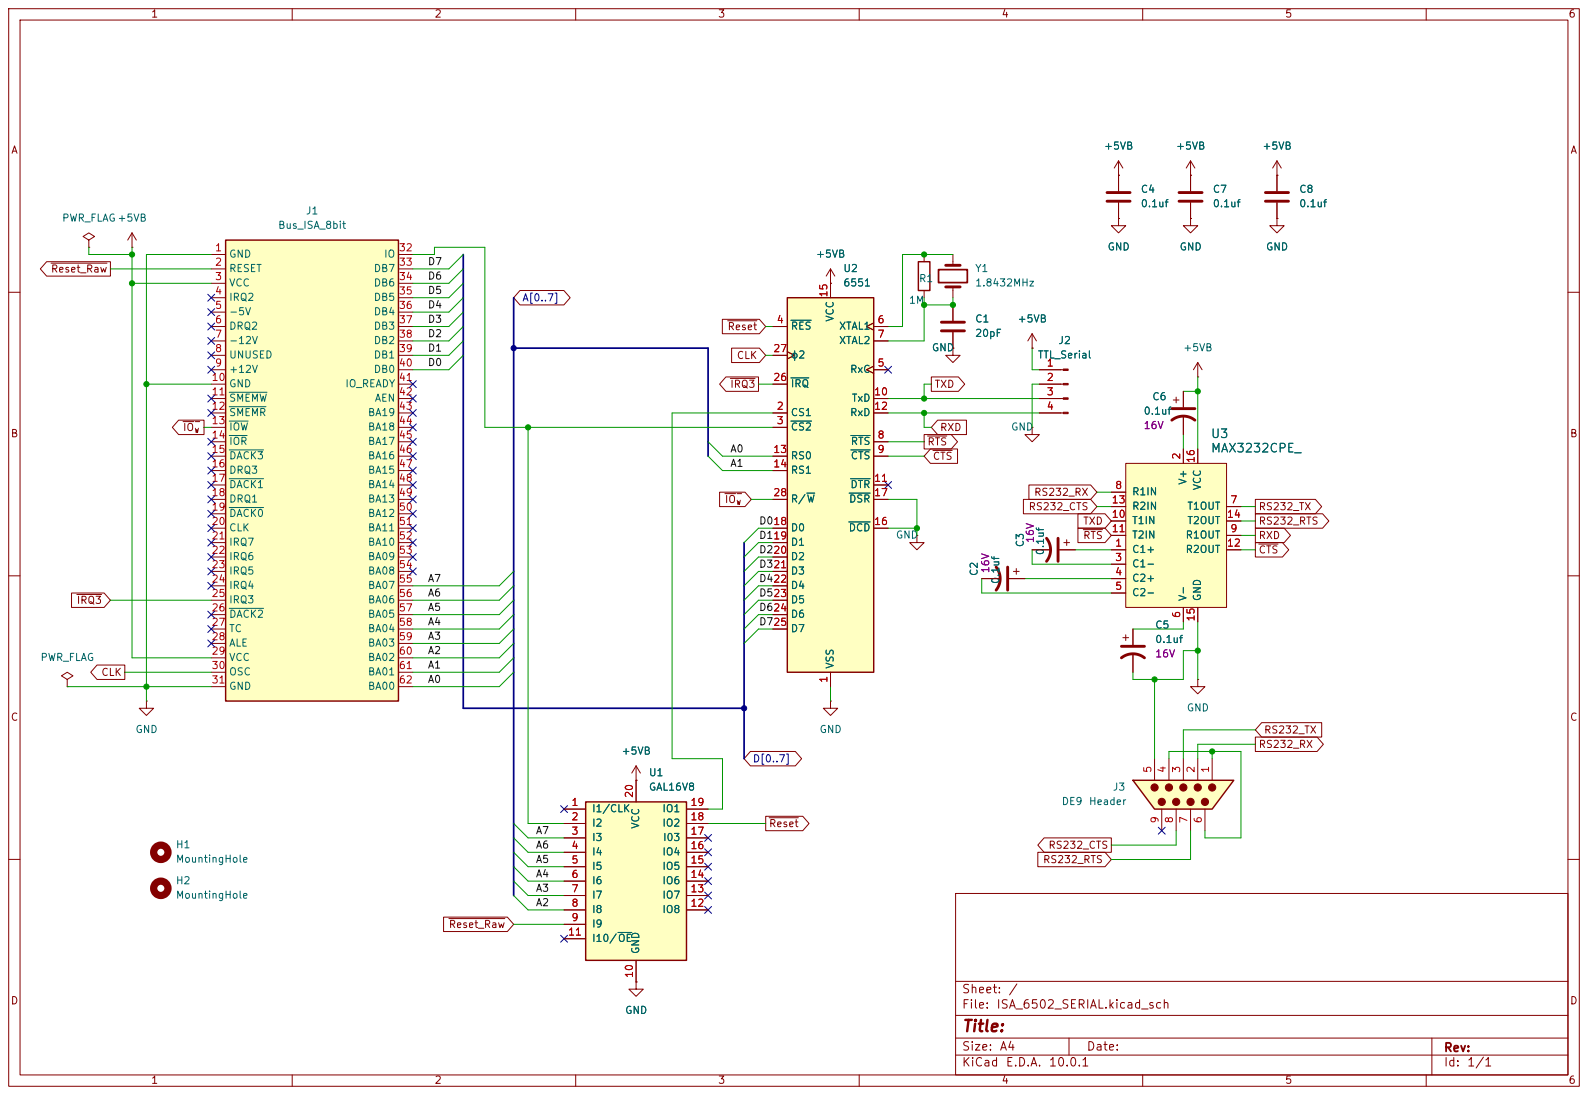
[picture p84: page 1]

Size: A4 | Rev:
KiCad E.D.A. 10.0.1 | Id: 1/1
