dfmcwhir/Multi_Architecture_DIY_Computer/ISA_6502/ISA_6502_CPU/ISA_6502_CPU_Schematics.pdf

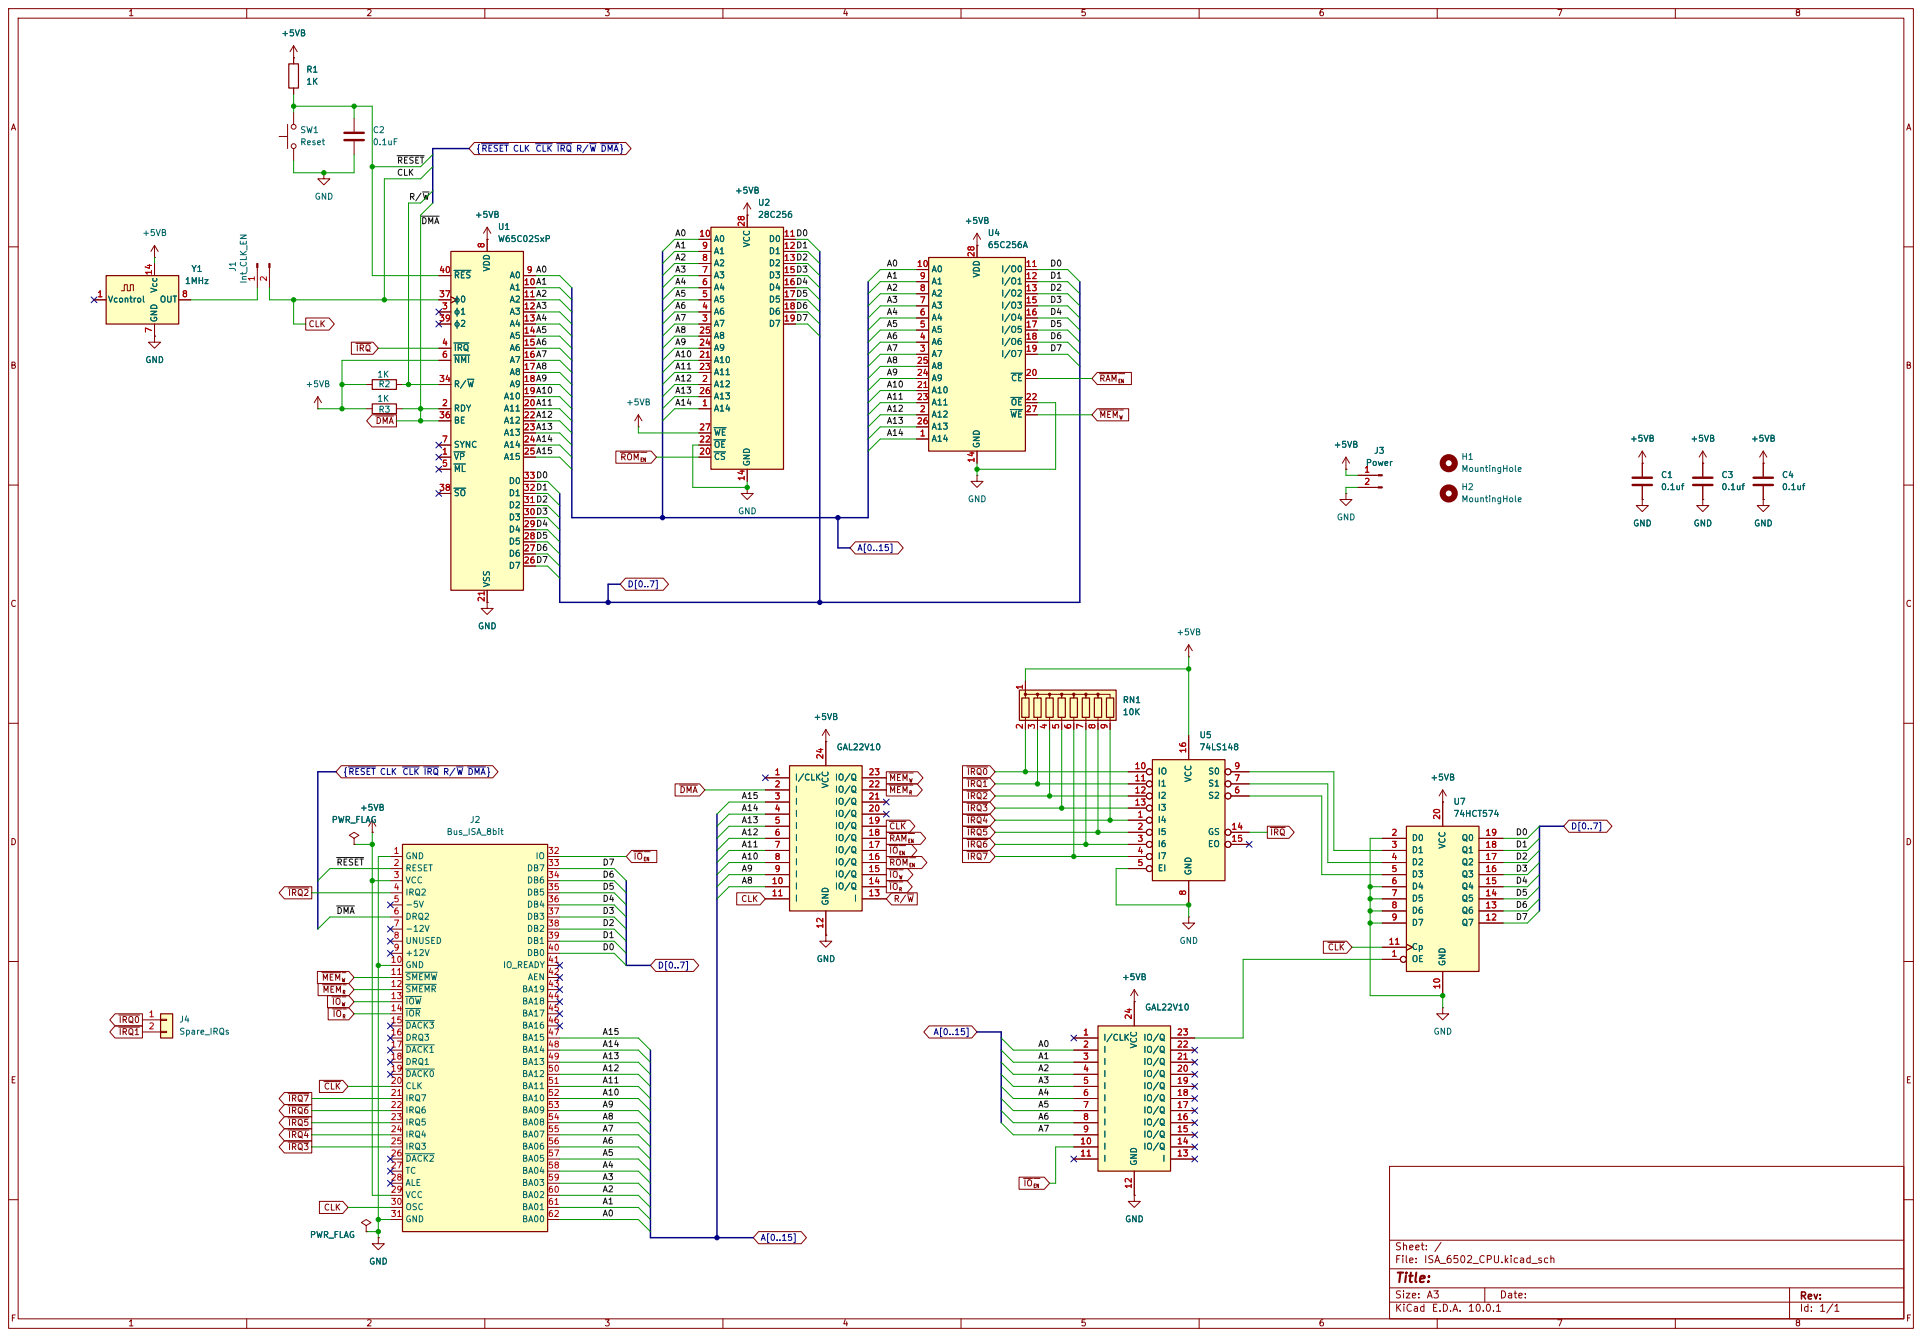
[picture p85: page 1]

VP 1 RDY 2 ϕ1 3 VP 1 RDY 2 ϕ1 3 A7 16 A7 16

1K | | IRQ 4 ML 5 NMI 6 IRQ 4 ML 5 NMI 6 A8 17 A8 17 | A8

{RESET CLK CLK IRQ R/W DMA }

Size: A3 | Rev: | F Date:
KiCad E.D.A. 10.0.1 | Id: 1/1
