dfmcwhir/Multi_Architecture_DIY_Computer/ISA_Z80/ISA_Z80.kicad_pcb

## KiCad design ISA_Z80/ISA_Z80.kicad_pcb (2026-11-05)

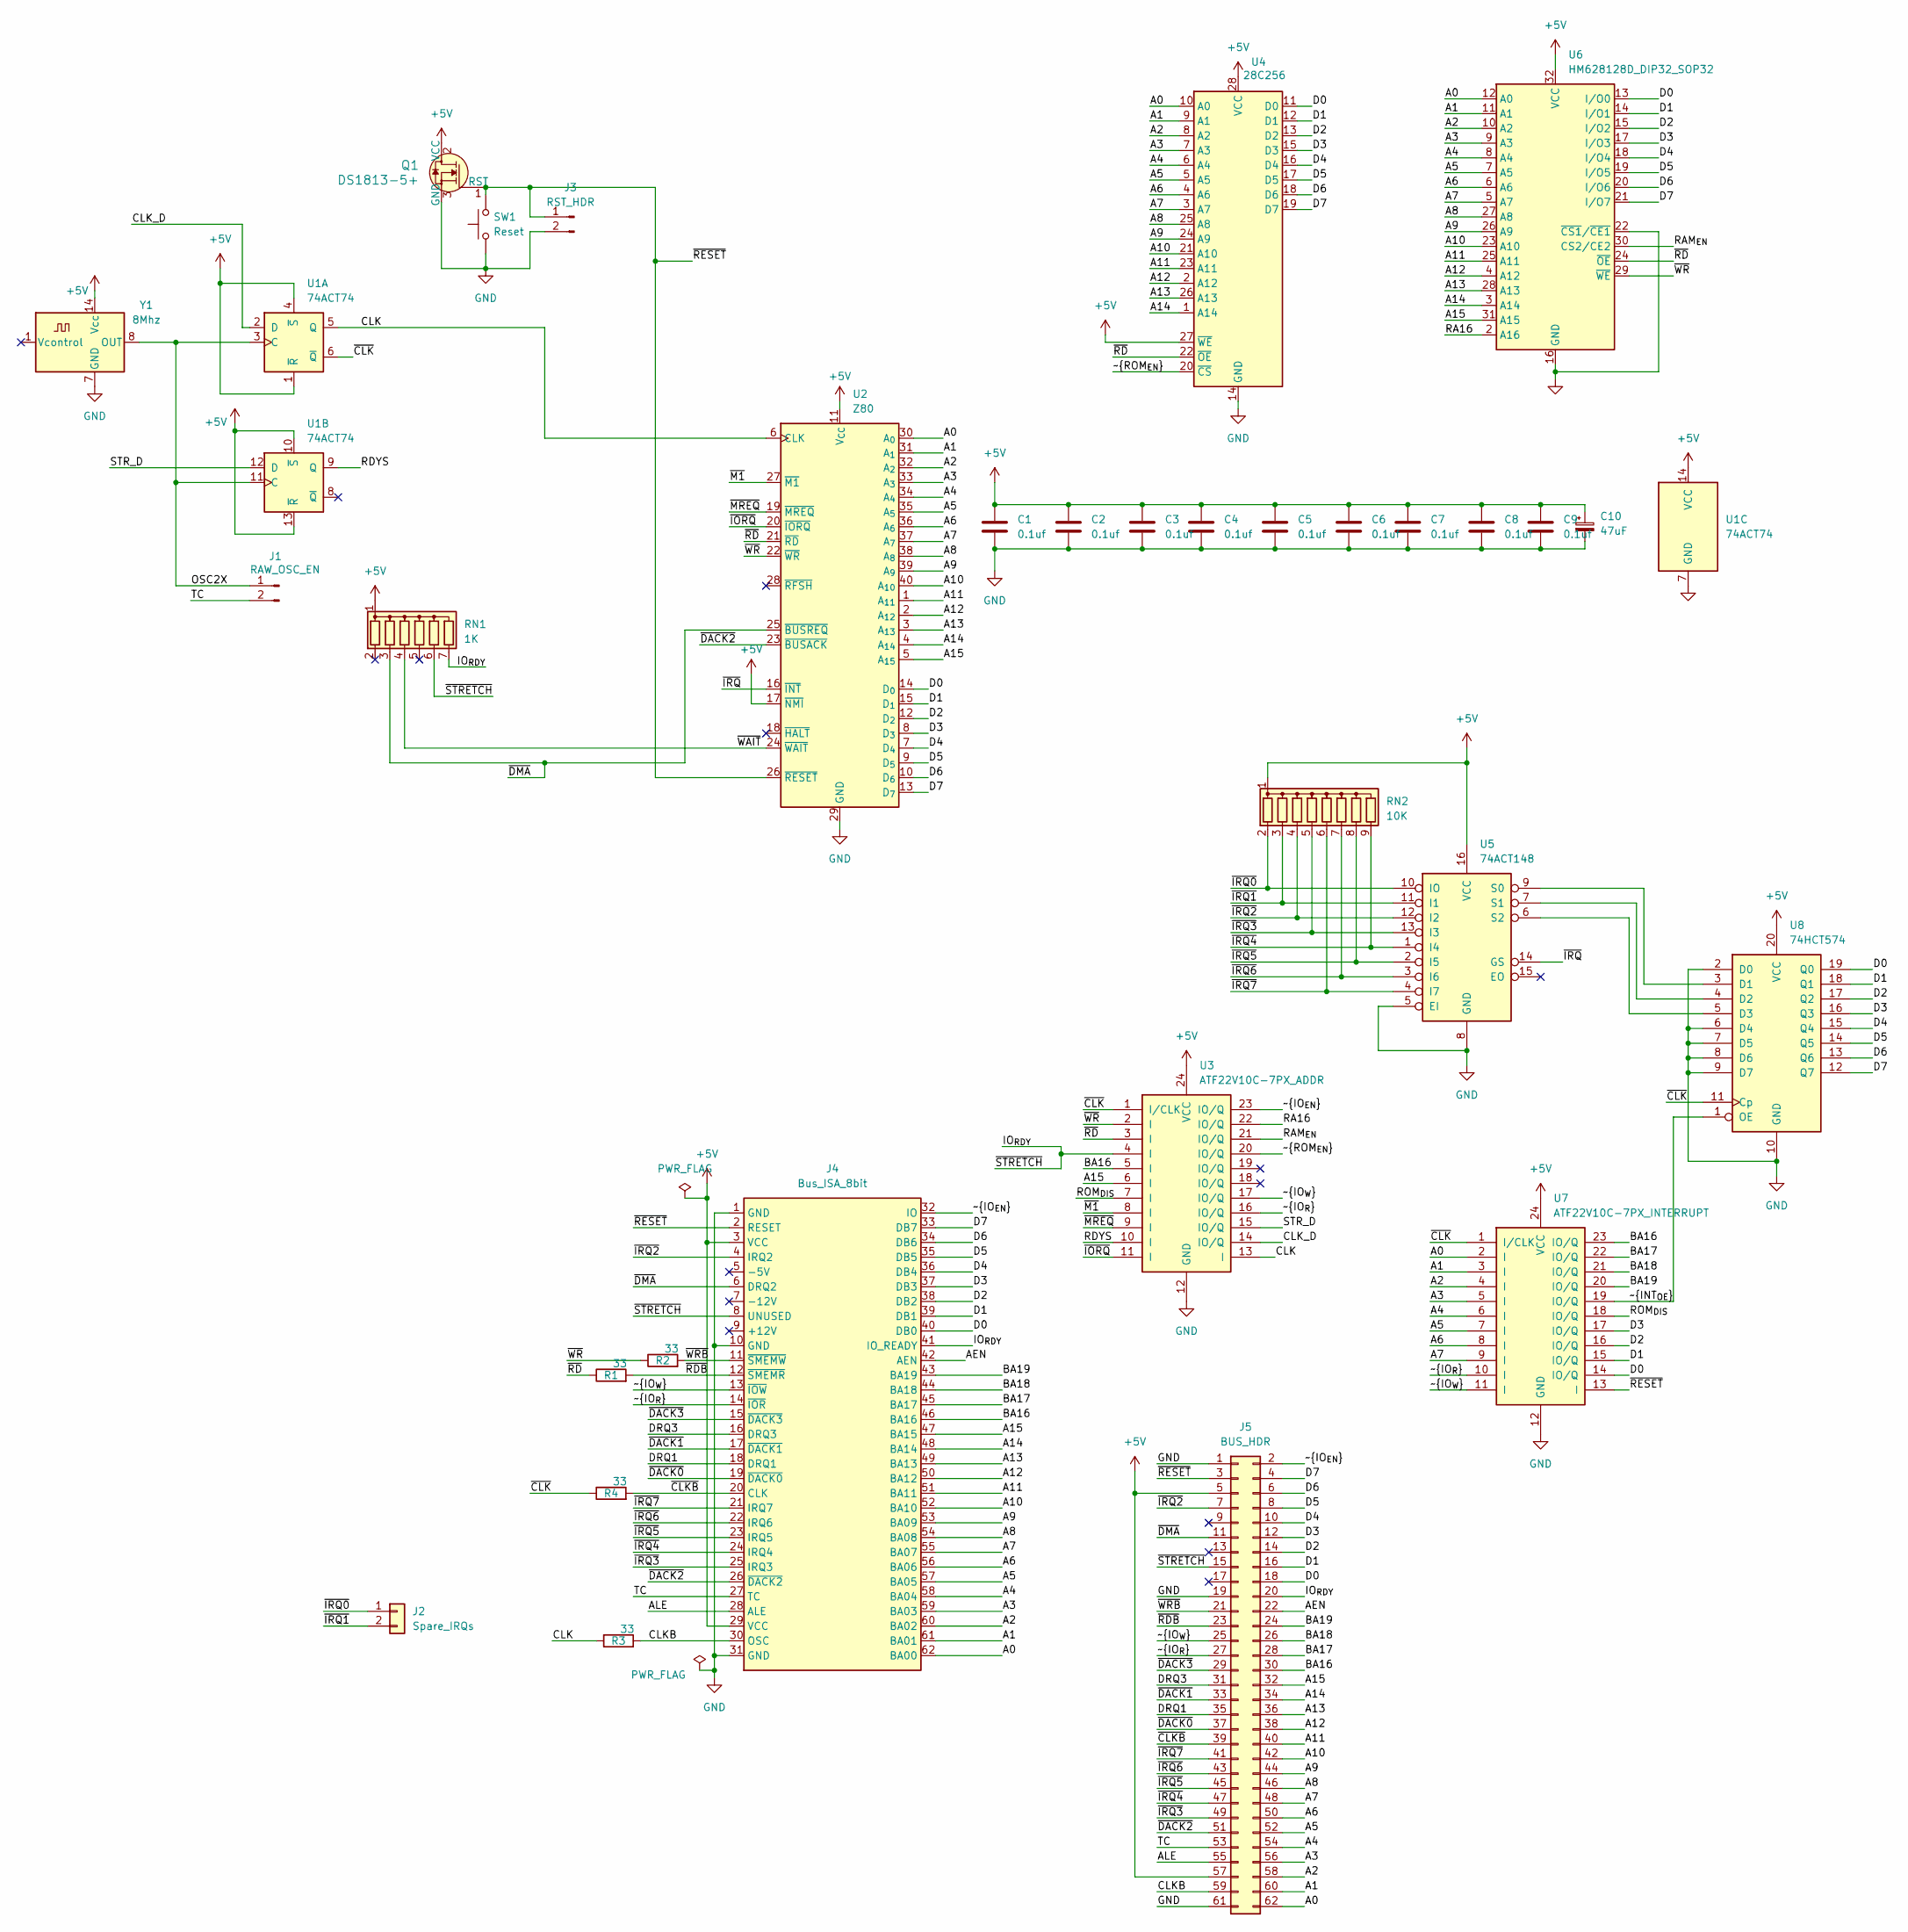
[picture p86: schematic ISA_Z80.kicad_sch]

Parts:
C1, C2, C3, C4, C5, C6, C7, C8, C9: 0.1uf; C_Disc_D4.7mm_W2.5mm_P5.00mm
C10: 47uF; CP_Radial_D5.0mm_P2.00mm
J1: RAW_OSC_EN; PinHeader_1x02_P2.54mm_Vertical
J2: Spare_IRQs; PinHeader_1x02_P2.54mm_Vertical
J3: RST_HDR; PinHeader_1x02_P2.54mm_Vertical
J4: Bus_ISA_8bit; BUS_8-bit_ISA
J5: BUS_HDR; PinHeader_2x31_P2.54mm_Vertical
Q1: DS1813-5+; TO-92L_Wide; MPN DS1813-5+-ND; Digi-Key_PN DS1813-5+-ND
R1, R2, R3, R4: 33; R_Axial_DIN0207_L6.3mm_D2.5mm_P10.16mm_Horizontal
RN1: 1K; R_Array_SIP7
RN2: 10K; R_Array_SIP9
SW1: Reset; SW_PUSH_6mm
U1: 74ACT74; DIP-14_W7.62mm
U2: Z80; DIP-40_W15.24mm
U3: ATF22V10C-7PX_ADDR; DIP-24_W7.62mm
U4: 28C256; DIP-28_W15.24mm
U5: 74ACT148; DIP-16_W7.62mm
U6: HM628128D_DIP32_SOP32; DIP-32_W15.24mm
U7: ATF22V10C-7PX_INTERRUPT; DIP-24_W7.62mm
U8: 74HCT574; DIP-20_W7.62mm
Y1: 8Mhz; Oscillator_DIP-14

Connections:
+5V: C1.1, C2.1, C3.1, C4.1, C5.1, C6.1, C7.1, C8.1, C9.1, C10.1, J4.3 (VCC), J4.29 (VCC), J5.5, J5.57, Q1.2 (VCC), RN1.1 (common), RN2.1 (common), U1.1 (~R), U1.4 (~S), U1.10 (~S), U1.13 (~R), U1.14 (VCC), U2.11 (V_{CC}), U2.17 (~NMI), U3.24 (VCC), U4.27 (~WE), U4.28 (VCC), U5.16 (VCC), U6.32 (VCC), U7.24 (VCC), U8.20 (VCC), Y1.14 (Vcc)
/A0: J4.62 (BA00), J5.62, U2.30 (A_{0}), U4.10 (A0), U6.12 (A0), U7.2 (I)
/A1: J4.61 (BA01), J5.60, U2.31 (A_{1}), U4.9 (A1), U6.11 (A1), U7.3 (I)
/A2: J4.60 (BA02), J5.58, U2.32 (A_{2}), U4.8 (A2), U6.10 (A2), U7.4 (I)
/A3: J4.59 (BA03), J5.56, U2.33 (A_{3}), U4.7 (A3), U6.9 (A3), U7.5 (I)
/A4: J4.58 (BA04), J5.54, U2.34 (A_{4}), U4.6 (A4), U6.8 (A4), U7.6 (I)
/A5: J4.57 (BA05), J5.52, U2.35 (A_{5}), U4.5 (A5), U6.7 (A5), U7.7 (I)
/A6: J4.56 (BA06), J5.50, U2.36 (A_{6}), U4.4 (A6), U6.6 (A6), U7.8 (I)
/A7: J4.55 (BA07), J5.48, U2.37 (A_{7}), U4.3 (A7), U6.5 (A7), U7.9 (I)
/A8: J4.54 (BA08), J5.46, U2.38 (A_{8}), U4.25 (A8), U6.27 (A8)
/A9: J4.53 (BA09), J5.44, U2.39 (A_{9}), U4.24 (A9), U6.26 (A9)
/A10: J4.52 (BA10), J5.42, U2.40 (A_{10}), U4.21 (A10), U6.23 (A10)
/A11: J4.51 (BA11), J5.40, U2.1 (A_{11}), U4.23 (A11), U6.25 (A11)
/A12: J4.50 (BA12), J5.38, U2.2 (A_{12}), U4.2 (A12), U6.4 (A12)
/A13: J4.49 (BA13), J5.36, U2.3 (A_{13}), U4.26 (A13), U6.28 (A13)
/A14: J4.48 (BA14), J5.34, U2.4 (A_{14}), U4.1 (A14), U6.3 (A14)
/A15: J4.47 (BA15), J5.32, U2.5 (A_{15}), U3.6 (I), U6.31 (A15)
/AEN: J4.42 (AEN), J5.22
/ALE: J4.28 (ALE), J5.55
/BA16: J4.46 (BA16), J5.30, U3.5 (I), U7.23 (IO/Q)
/BA17: J4.45 (BA17), J5.28, U7.22 (IO/Q)
/BA18: J4.44 (BA18), J5.26, U7.21 (IO/Q)
/BA19: J4.43 (BA19), J5.24, U7.20 (IO/Q)
/CLK: R3.1, U1.5 (Q), U2.6 (CLK), U3.13 (I)
/CLKB: J4.30 (OSC), J5.59, R3.2
/CLK_D: U1.2 (D), U3.14 (IO/Q)
/D0: J4.40 (DB0), J5.18, U2.14 (D_{0}), U4.11 (D0), U6.13 (I/O0), U7.14 (IO/Q), U8.19 (Q0)
/D1: J4.39 (DB1), J5.16, U2.15 (D_{1}), U4.12 (D1), U6.14 (I/O1), U7.15 (IO/Q), U8.18 (Q1)
/D2: J4.38 (DB2), J5.14, U2.12 (D_{2}), U4.13 (D2), U6.15 (I/O2), U7.16 (IO/Q), U8.17 (Q2)
/D3: J4.37 (DB3), J5.12, U2.8 (D_{3}), U4.15 (D3), U6.17 (I/O3), U7.17 (IO/Q), U8.16 (Q3)
/D4: J4.36 (DB4), J5.10, U2.7 (D_{4}), U4.16 (D4), U6.18 (I/O4), U8.15 (Q4)
/D5: J4.35 (DB5), J5.8, U2.9 (D_{5}), U4.17 (D5), U6.19 (I/O5), U8.14 (Q5)
/D6: J4.34 (DB6), J5.6, U2.10 (D_{6}), U4.18 (D6), U6.20 (I/O6), U8.13 (Q6)
/D7: J4.33 (DB7), J5.4, U2.13 (D_{7}), U4.19 (D7), U6.21 (I/O7), U8.12 (Q7)
/DRQ1: J4.18 (DRQ1), J5.35
/DRQ3: J4.16 (DRQ3), J5.31
/IO_{RDY}: J4.8 (UNUSED), J4.41 (IO_READY), J5.15, J5.20, RN1.6 (R5), RN1.7 (R6), U3.4 (I)
/OSC2X: J1.1, U1.3 (C), U1.11 (C), Y1.8 (OUT)
/RA16: U3.22 (IO/Q), U6.2 (A16)
/RAM_{EN}: U3.21 (IO/Q), U6.30 (CS2/CE2)
/RDYS: U1.9 (Q), U3.10 (I)
/ROM_{DIS}: U3.7 (I), U7.18 (IO/Q)
/STR_D: U1.12 (D), U3.15 (IO/Q)
/TC: J1.2, J4.27 (TC), J5.53
/~CLKB: J4.20 (CLK), J5.39, R4.2
/~CLK: R4.1, U1.6 (~Q), U3.1 (I/CLK), U7.1 (I/CLK), U8.11 (Cp)
/~DACK0: J4.19 (~DACK0), J5.37
/~DACK1: J4.17 (~DACK1), J5.33
/~DACK2: J4.26 (~DACK2), J5.51, U2.23 (~BUSACK)
/~DACK3: J4.15 (~DACK3), J5.29
/~DMA: J4.6 (DRQ2), J5.11, RN1.3 (R2), U2.25 (~BUSREQ)
/~INT_{OE}: U7.19 (IO/Q), U8.1 (OE)
/~IORQ: U2.20 (~IORQ), U3.11 (I)
/~IO_{EN}: J4.32 (IO), J5.2, U3.23 (IO/Q)
/~IO_{R}: J4.14 (~IOR), J5.27, U3.16 (IO/Q), U7.10 (I)
/~IO_{W}: J4.13 (~IOW), J5.25, U3.17 (IO/Q), U7.11 (I)
/~IRQ0: J2.1, RN2.2 (R1), U5.10 (IO)
/~IRQ1: J2.2, RN2.3 (R2), U5.11 (I1)
/~IRQ2: J4.4 (IRQ2), J5.7, RN2.4 (R3), U5.12 (I2)
/~IRQ3: J4.25 (IRQ3), J5.49, RN2.5 (R4), U5.13 (I3)
/~IRQ4: J4.24 (IRQ4), J5.47, RN2.9 (R8), U5.1 (I4)
/~IRQ5: J4.23 (IRQ5), J5.45, RN2.8 (R7), U5.2 (I5)
/~IRQ6: J4.22 (IRQ6), J5.43, RN2.7 (R6), U5.3 (I6)
/~IRQ7: J4.21 (IRQ7), J5.41, RN2.6 (R5), U5.4 (I7)
/~IRQ: U2.16 (~INT), U5.14 (GS)
/~M1: U2.27 (~M1), U3.8 (I)
/~MREQ: U2.19 (~MREQ), U3.9 (I)
/~RDB: J4.12 (~SMEMR), J5.23, R1.2
/~RD: R1.1, U2.21 (~RD), U3.3 (I), U4.22 (~OE), U6.24 (~OE)
/~RESET: J3.1, J4.2 (RESET), J5.3, Q1.1 (RST), SW1.2, U2.26 (~RESET), U7.13 (I)
/~ROM_{EN}: U3.20 (IO/Q), U4.20 (~CS)
/~WAIT: RN1.4 (R3), U2.24 (~WAIT)
/~WRB: J4.11 (~SMEMW), J5.21, R2.2
/~WR: R2.1, U2.22 (~WR), U3.2 (I), U6.29 (~WE)
GND: C1.2, C2.2, C3.2, C4.2, C5.2, C6.2, C7.2, C8.2, C9.2, C10.2, J3.2, J4.1 (GND), J4.10 (GND), J4.31 (GND), J5.1, J5.19, J5.61, Q1.3 (GND), SW1.1, U1.7 (GND), U2.29 (GND), U3.12 (GND), U4.14 (GND), U5.5 (EI), U5.8 (GND), U6.16 (GND), U6.22 (~CS1/~CE1), U7.12 (GND), U8.2 (D0), U8.6 (D4), U8.7 (D5), U8.8 (D6), U8.9 (D7), U8.10 (GND), Y1.7 (GND)
unnamed: U5.9 (S0), U8.3 (D1)
unnamed: U5.7 (S1), U8.4 (D2)
unnamed: U5.6 (S2), U8.5 (D3)

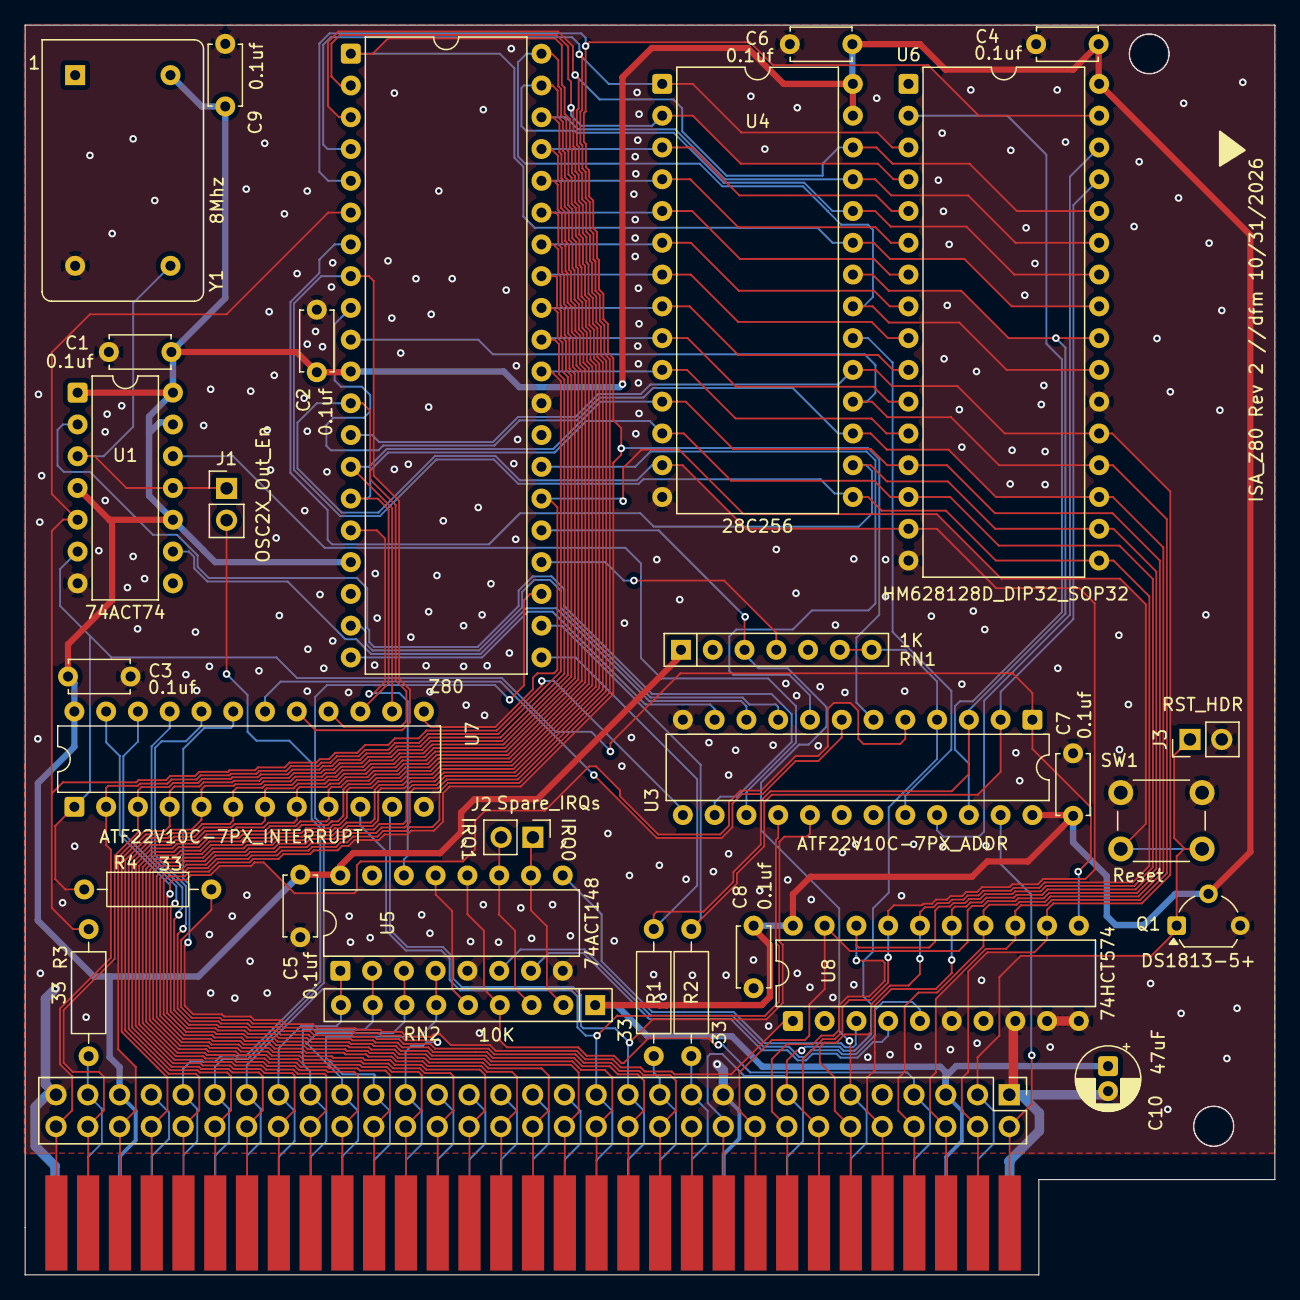
[picture p87: board ISA_Z80.kicad_pcb from above]

Board: 2 copper layers, 99.9 x 99.9 mm, 32 parts (0 on the bottom side), 78 nets.
