dfmcwhir/Multi_Architecture_DIY_Computer/Add-On_Cards/ISA_PICO9918_VGA/ISA_PICO9918_VGA.kicad_pcb

## KiCad design Add-On_Cards/ISA_PICO9918_VGA/ISA_PICO9918_VGA.kicad_pcb (2026-11-05)

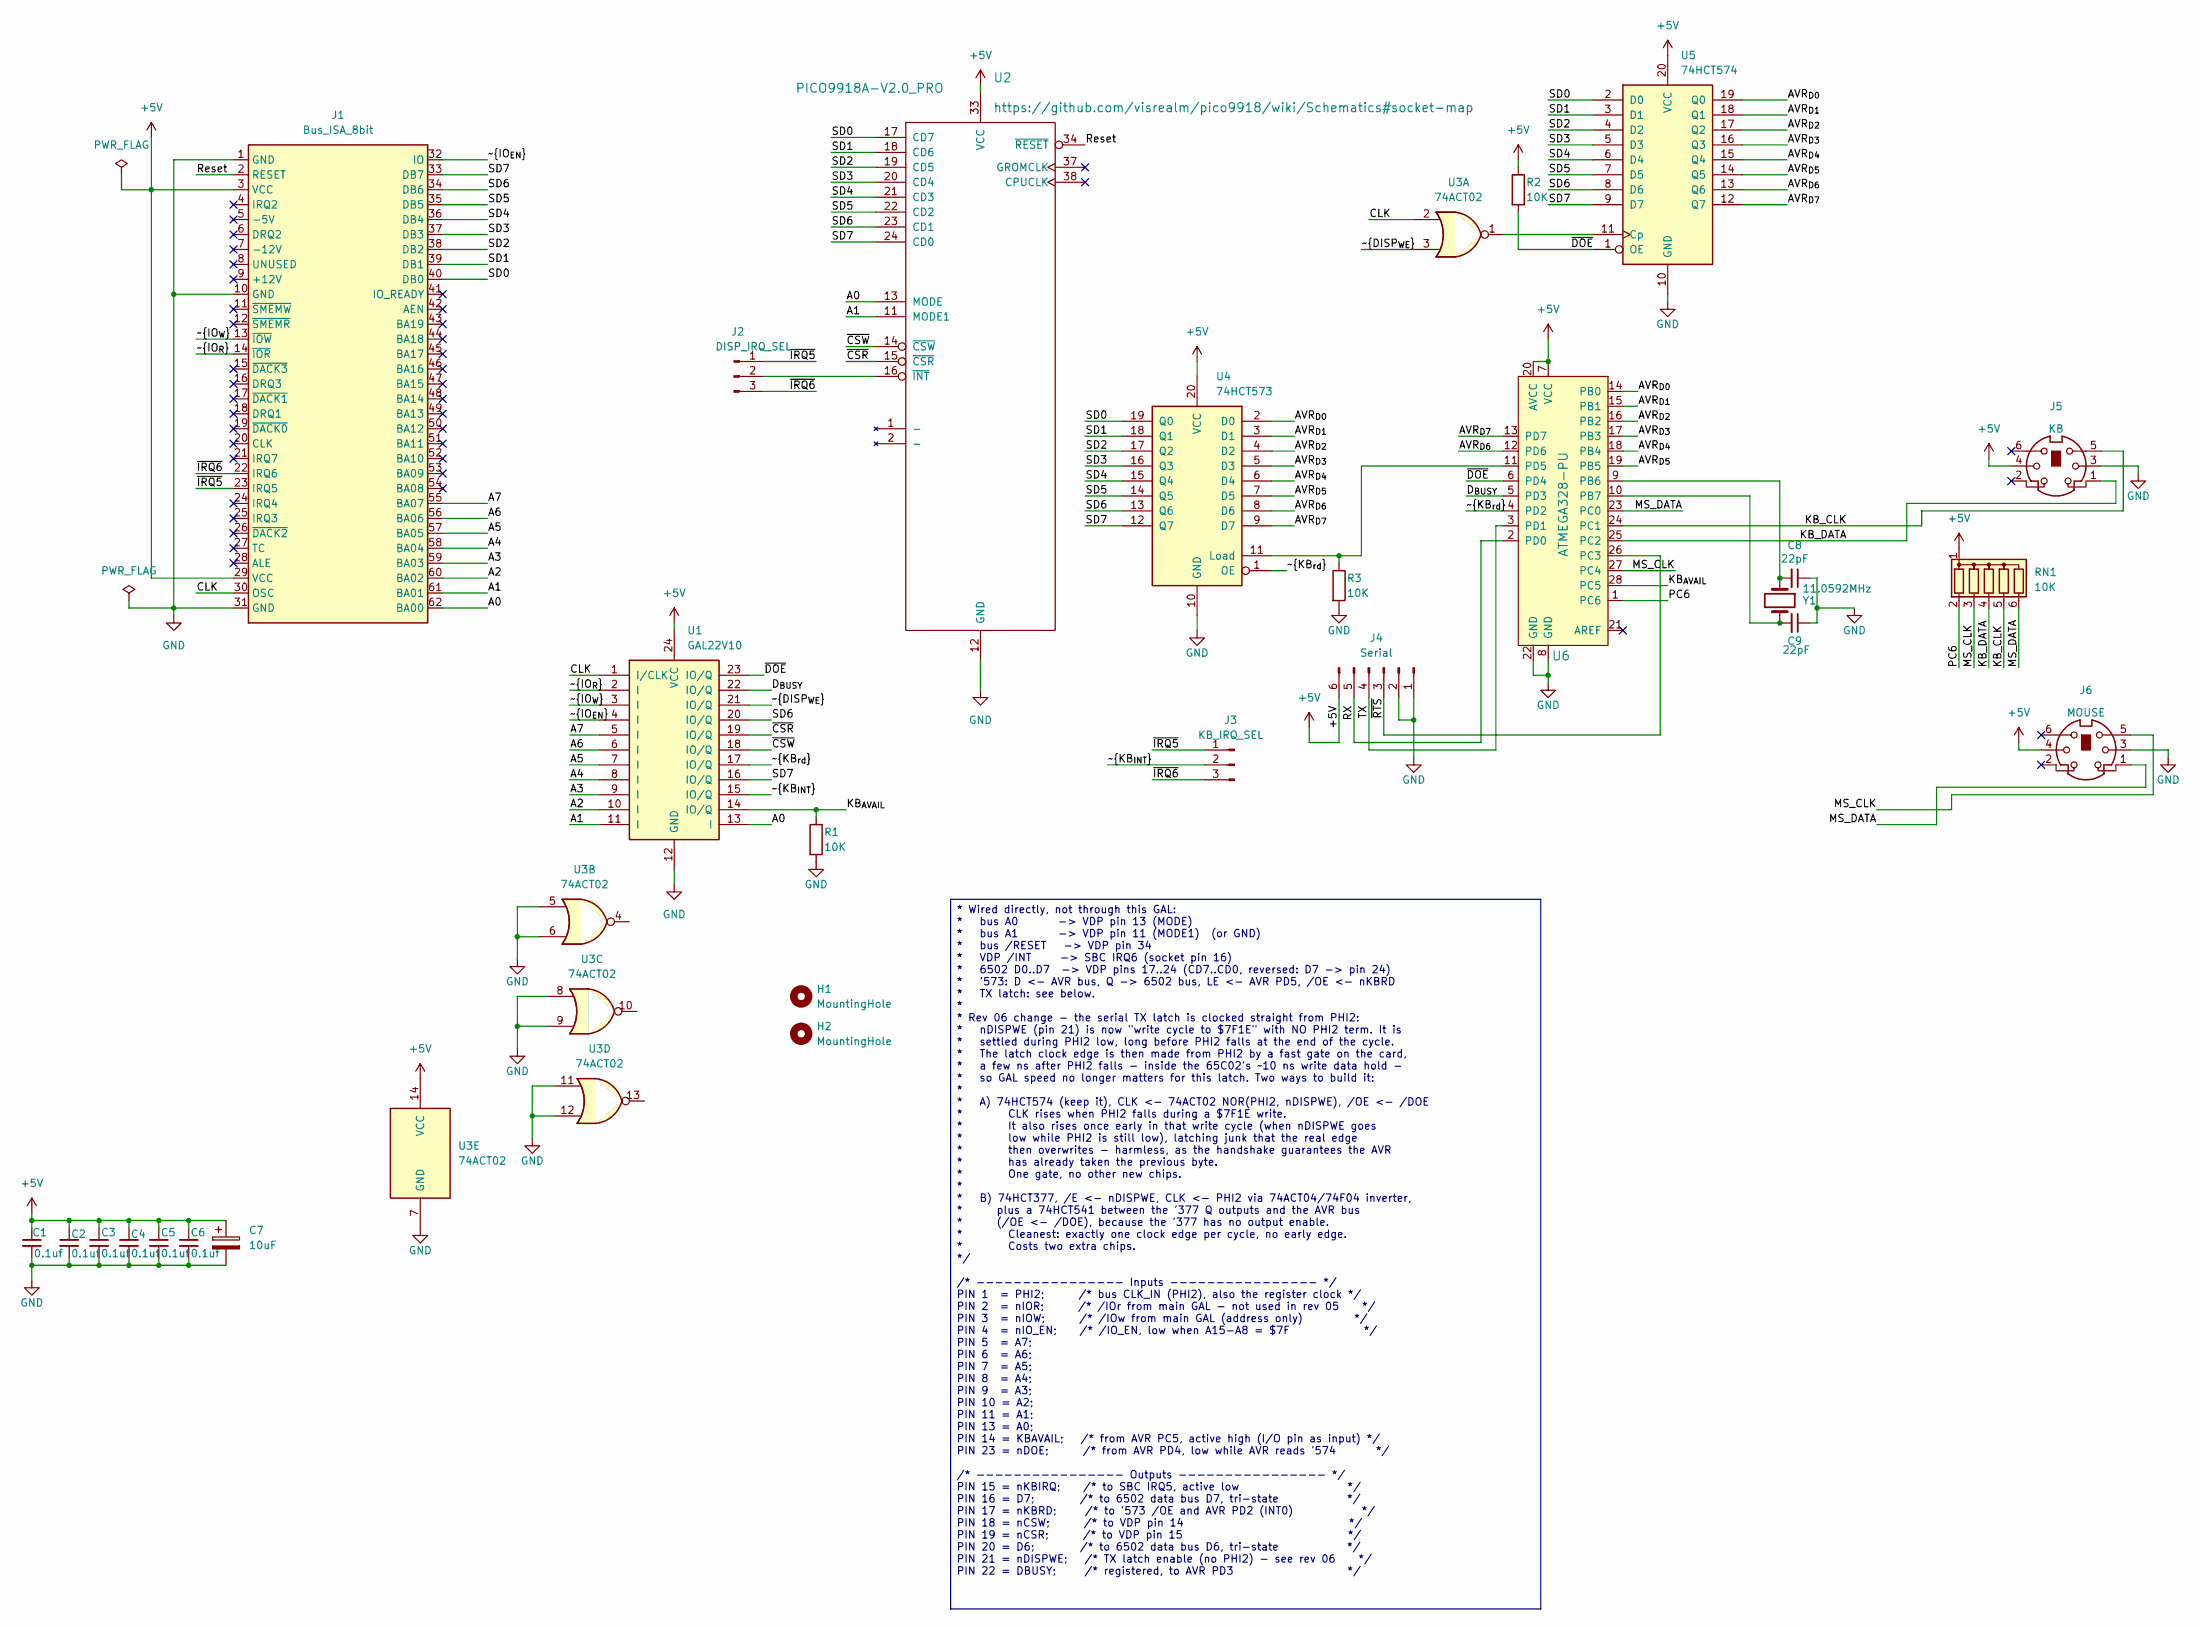
[picture p88: schematic ISA_PICO9918_VGA.kicad_sch]

Parts:
C1, C2, C3, C4, C5, C6: 0.1uf; C_Disc_D4.7mm_W2.5mm_P5.00mm; Voltage 50V; Tolerance 5%
C7: 10uF; CP_Radial_D5.0mm_P2.00mm
C8, C9: 22pF; C_Disc_D4.7mm_W2.5mm_P5.00mm; Voltage 50V; Tolerance 5%
H1, H2: MountingHole; MountingHole_3.2mm_M3
J1: Bus_ISA_8bit; BUS_8-bit_ISA_CARD
J2: DISP_IRQ_SEL; PinHeader_1x03_P2.54mm_Vertical
J3: KB_IRQ_SEL; PinHeader_1x03_P2.54mm_Vertical
J4: Serial; PinHeader_1x06_P2.54mm_Vertical
J5: KB; Connector_Mini-DIN_Female_6Pin_2rows
J6: MOUSE; Connector_Mini-DIN_Female_6Pin_2rows
R1, R2, R3: 10K; R_Axial_DIN0207_L6.3mm_D2.5mm_P10.16mm_Horizontal
RN1: 10K; R_Array_SIP6
U1: GAL22V10; DIP-24_W7.62mm
U2: PICO9918A-V2.0_PRO; DIP-40_W15.24mm
U3: 74ACT02; DIP-14_W7.62mm
U4: 74HCT573; DIP-20_W7.62mm
U5: 74HCT574; DIP-20_W7.62mm
U6: ATMEGA328-PU; DIP-28_W7.62mm_Socket; MPN ATMEGA328-PU; Digi-Key_PN ATMEGA328-PU-ND
Y1: 11.0592MHz; Crystal_HC18-U_Vertical

Connections:
+5V: C1.1, C2.1, C3.1, C4.1, C5.1, C6.1, C7.1, J1.3 (VCC), J1.29 (VCC), J4.6, J5.4, J6.4, R2.1, RN1.1 (common), U1.24 (VCC), U2.33 (VCC), U3.14 (VCC), U4.20 (VCC), U5.20 (VCC), U6.7 (VCC), U6.20 (AVCC)
/A0: J1.62 (BA00), U1.13 (I), U2.13 (MODE)
/A1: J1.61 (BA01), U1.11 (I), U2.11 (MODE1)
/A2: J1.60 (BA02), U1.10 (I)
/A3: J1.59 (BA03), U1.9 (I)
/A4: J1.58 (BA04), U1.8 (I)
/A5: J1.57 (BA05), U1.7 (I)
/A6: J1.56 (BA06), U1.6 (I)
/A7: J1.55 (BA07), U1.5 (I)
/AVR_{D0}: U4.2 (D0), U5.19 (Q0), U6.14 (PB0)
/AVR_{D1}: U4.3 (D1), U5.18 (Q1), U6.15 (PB1)
/AVR_{D2}: U4.4 (D2), U5.17 (Q2), U6.16 (PB2)
/AVR_{D3}: U4.5 (D3), U5.16 (Q3), U6.17 (PB3)
/AVR_{D4}: U4.6 (D4), U5.15 (Q4), U6.18 (PB4)
/AVR_{D5}: U4.7 (D5), U5.14 (Q5), U6.19 (PB5)
/AVR_{D6}: U4.8 (D6), U5.13 (Q6), U6.12 (PD6)
/AVR_{D7}: U4.9 (D7), U5.12 (Q7), U6.13 (PD7)
/CLK: J1.30 (OSC), U1.1 (I/CLK), U3.2
/D_{BUSY}: U1.22 (IO/Q), U6.5 (PD3)
/KB_CLK: J5.5, RN1.5 (R4), U6.24 (PC1)
/KB_DATA: J5.1, RN1.4 (R3), U6.25 (PC2)
/KB_{AVAIL}: R1.1, U1.14 (IO/Q), U6.28 (PC5)
/MS_CLK: J6.5, RN1.3 (R2), U6.27 (PC4)
/MS_DATA: J6.1, RN1.6 (R5), U6.23 (PC0)
/PC6: RN1.2 (R1), U6.1 (PC6)
/RX: J4.5, U6.2 (PD0)
/Reset: J1.2 (RESET), U2.34 (~RESET)
/SD0: J1.40 (DB0), U2.17 (CD7), U4.19 (Q0), U5.2 (D0)
/SD1: J1.39 (DB1), U2.18 (CD6), U4.18 (Q1), U5.3 (D1)
/SD2: J1.38 (DB2), U2.19 (CD5), U4.17 (Q2), U5.4 (D2)
/SD3: J1.37 (DB3), U2.20 (CD4), U4.16 (Q3), U5.5 (D3)
/SD4: J1.36 (DB4), U2.21 (CD3), U4.15 (Q4), U5.6 (D4)
/SD5: J1.35 (DB5), U2.22 (CD2), U4.14 (Q5), U5.7 (D5)
/SD6: J1.34 (DB6), U1.20 (IO/Q), U2.23 (CD1), U4.13 (Q6), U5.8 (D6)
/SD7: J1.33 (DB7), U1.16 (IO/Q), U2.24 (CD0), U4.12 (Q7), U5.9 (D7)
/TX: J4.4, U6.3 (PD1)
/~CSR: U1.19 (IO/Q), U2.15 (~CSR)
/~CSW: U1.18 (IO/Q), U2.14 (~CSW)
/~DISP_{WE}: U1.21 (IO/Q), U3.3
/~DOE: R2.2, U1.23 (IO/Q), U5.1 (OE), U6.6 (PD4)
/~IO_{EN}: J1.32 (IO), U1.4 (I)
/~IO_{R}: J1.14 (~IOR), U1.2 (I)
/~IO_{W}: J1.13 (~IOW), U1.3 (I)
/~IRQ5: J1.23 (IRQ5), J2.1, J3.1
/~IRQ6: J1.22 (IRQ6), J2.3, J3.3
/~KB_{INT}: J3.2, U1.15 (IO/Q)
/~KB_{rd}: U1.17 (IO/Q), U4.1 (OE), U6.4 (PD2)
/~RTS: J4.3, U6.26 (PC3)
GND: C1.2, C2.2, C3.2, C4.2, C5.2, C6.2, C7.2, C8.1, C9.1, J1.1 (GND), J1.10 (GND), J1.31 (GND), J4.1, J4.2, J5.3, J6.3, R1.2, R3.2, U1.12 (GND), U2.12 (GND), U3.5, U3.6, U3.7 (GND), U3.8, U3.9, U3.11, U3.12, U4.10 (GND), U5.10 (GND), U6.8 (GND), U6.22 (GND)
unnamed: J2.2, U2.16 (~INT)
unnamed: R3.1, U4.11 (Load), U6.11 (PD5)
unnamed: U3.1, U5.11 (Cp)
unnamed: C8.2, U6.9 (PB6), Y1.1
unnamed: C9.2, U6.10 (PB7), Y1.2

Notes on the sheet:
* Wired directly, not through this GAL: * bus A0 -> VDP pin 13 (MODE) * bus A1 -> VDP pin 11 (MODE1) (or GND) * bus /RESET -> VDP pin 34 * VDP /INT -> SBC IRQ6 (socket pin 16) * 6502 D0..D7 -> VDP pins 17..24 (CD7..CD0, reversed: D7 -> pin 24) * '573: D <- AVR bus, Q -> 6502 bus, LE <- AVR PD5, /OE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

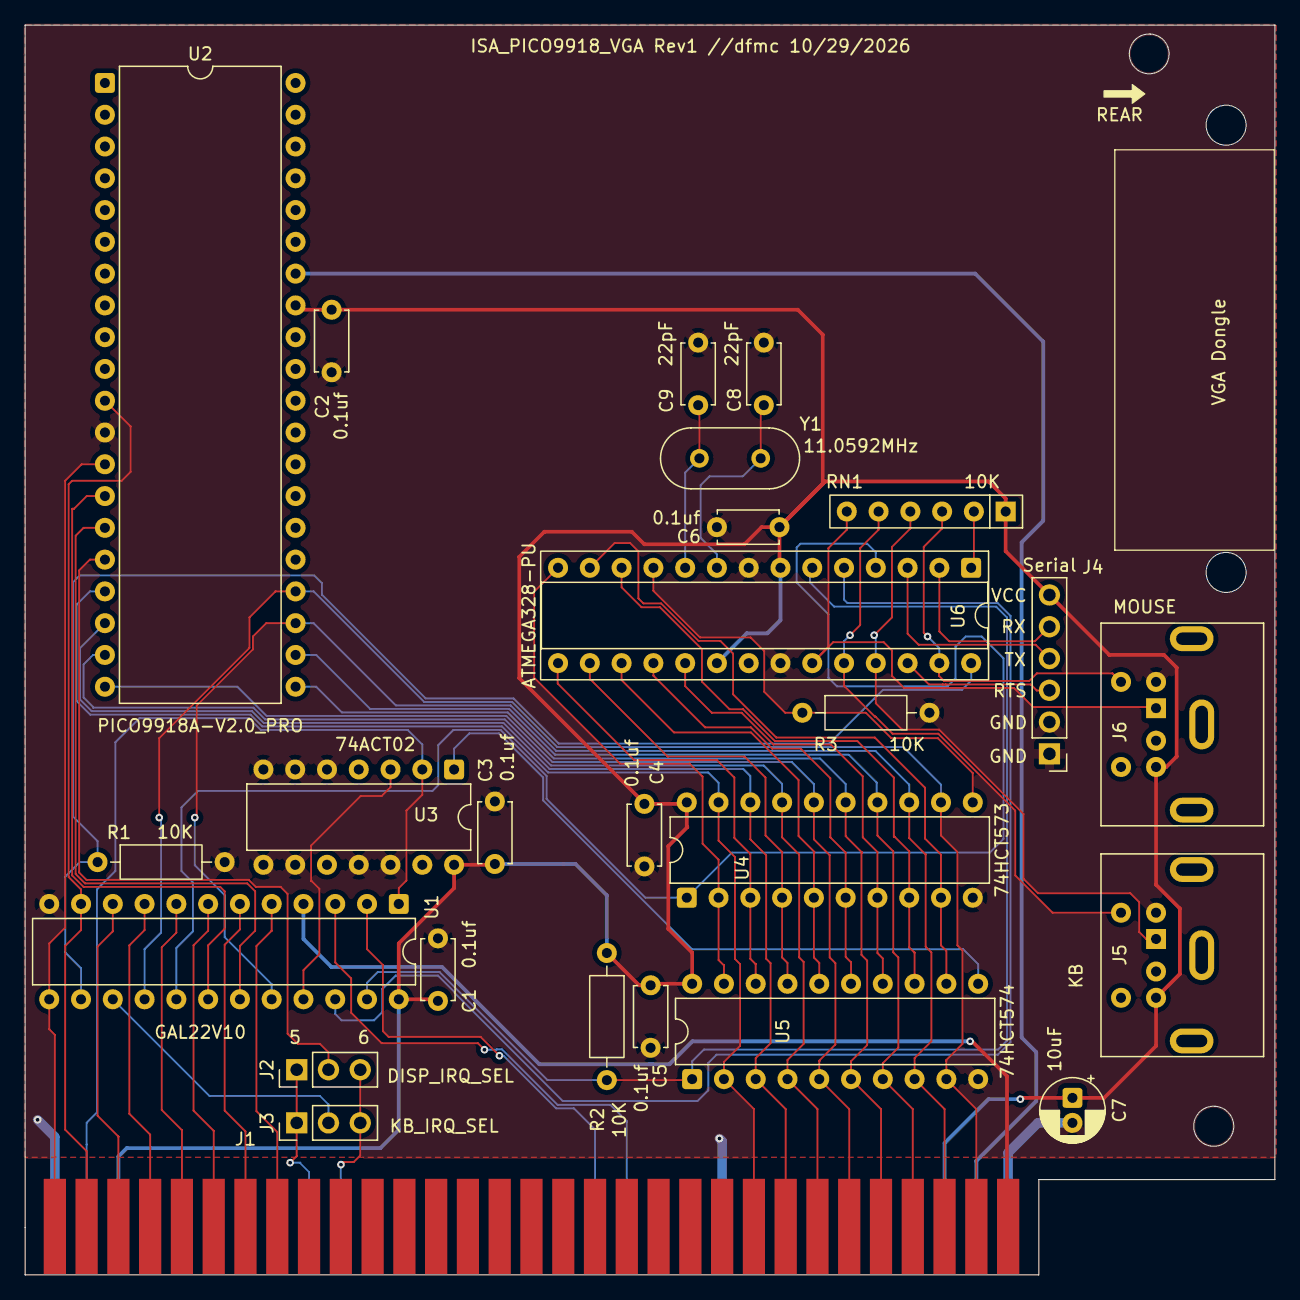
[picture p89: board ISA_PICO9918_VGA.kicad_pcb from above]

Board: 2 copper layers, 99.9 x 99.9 mm, 28 parts (0 on the bottom side), 54 nets.
