dfmcwhir/Multi_Architecture_DIY_Computer/Add-On_Cards/ISA_KB_MONITOR_TERM/ISA_MON_KEYBOARD_TERM.kicad_pcb

## KiCad design Add-On_Cards/ISA_KB_MONITOR_TERM/ISA_MON_KEYBOARD_TERM.kicad_pcb (2026-11-05)

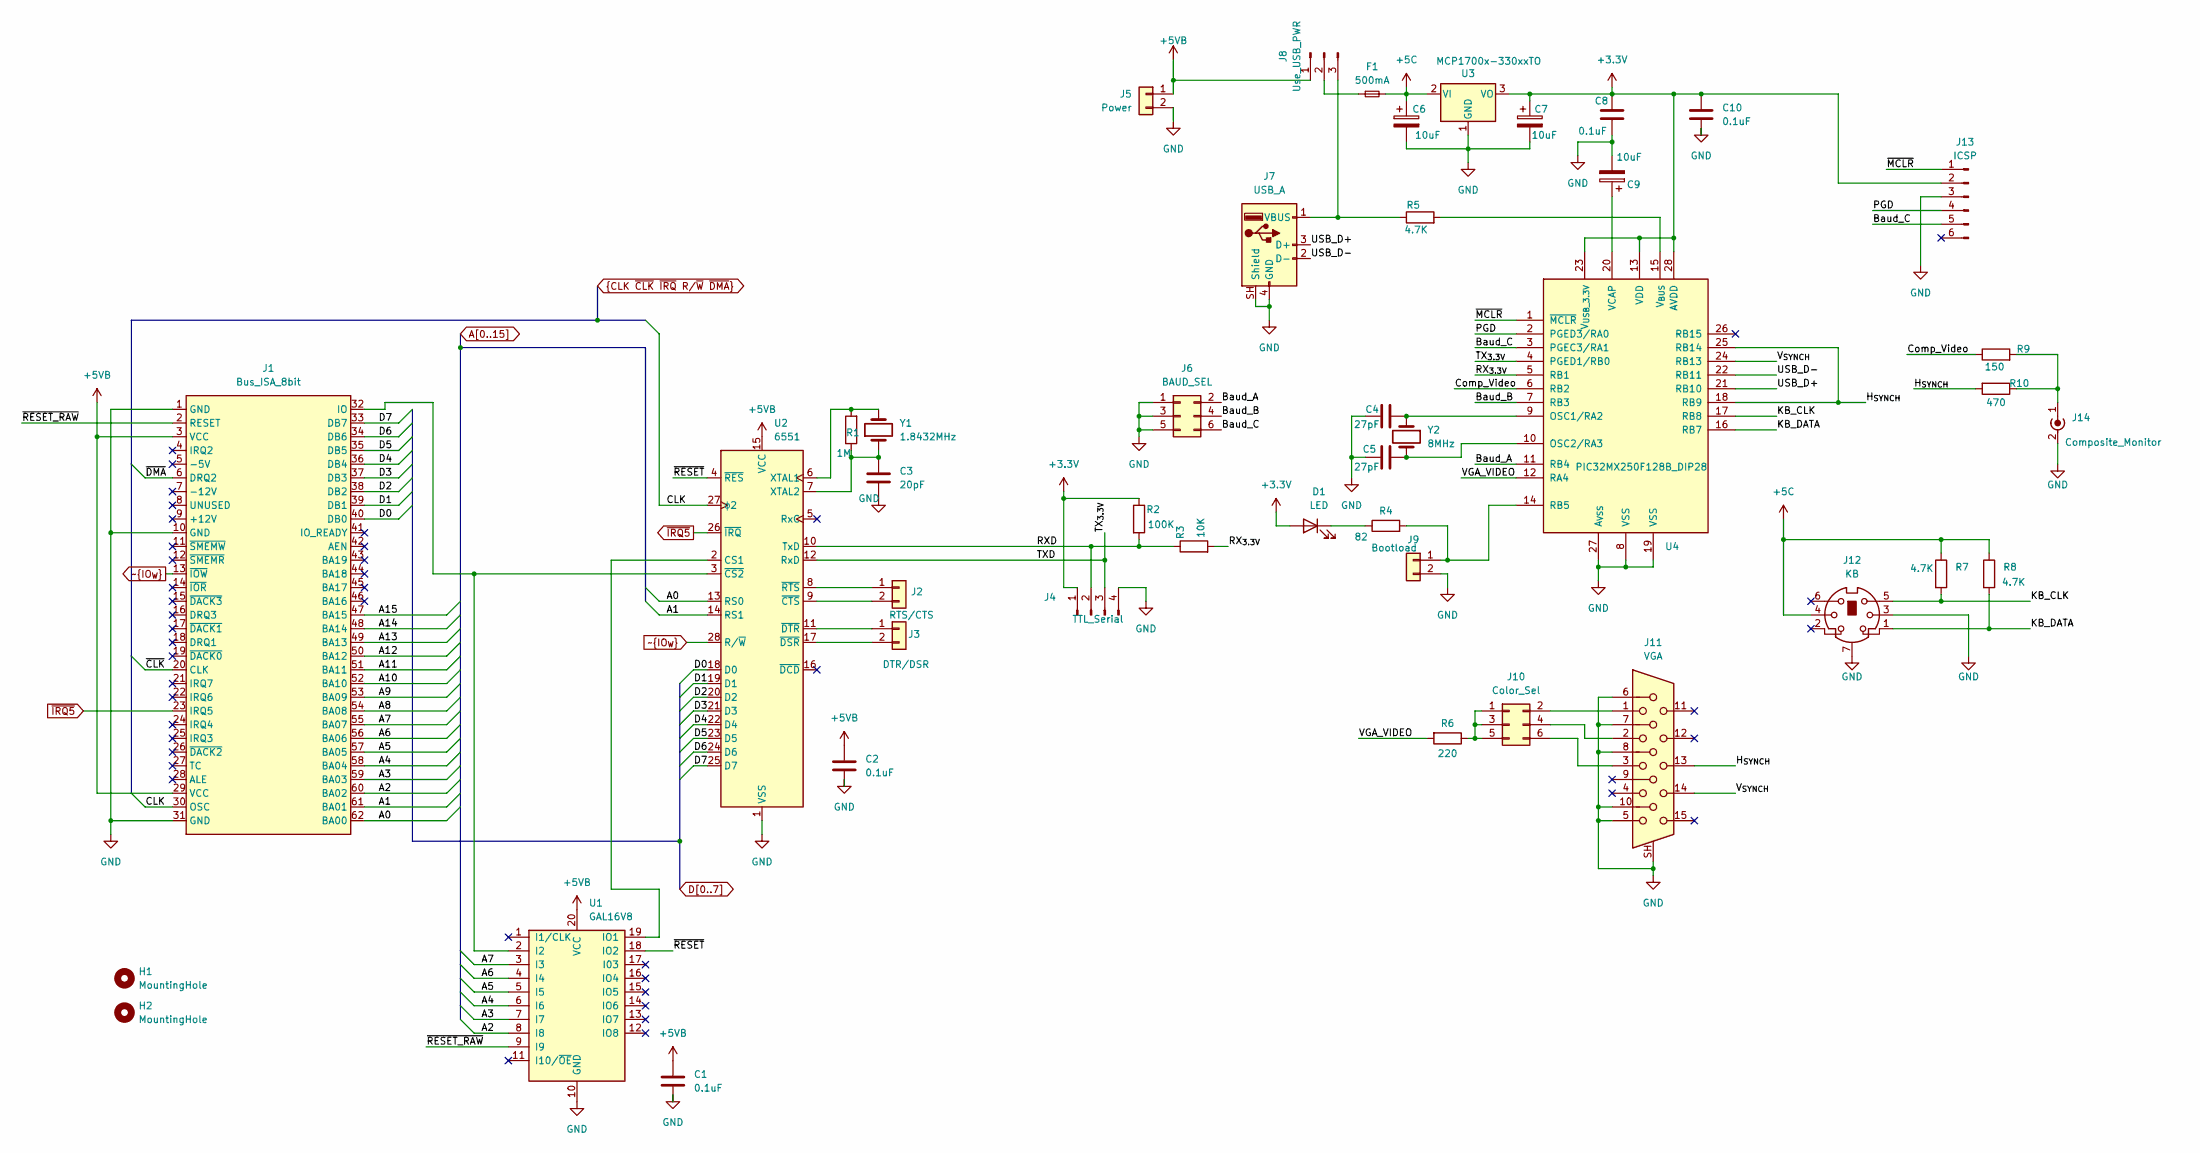
[picture p90: schematic ISA_MON_KEYBOARD_TERM.kicad_sch]

Parts:
C1, C2, C8, C10: 0.1uF; C_Disc_D4.7mm_W2.5mm_P5.00mm
C3: 20pF; C_Disc_D4.7mm_W2.5mm_P5.00mm
C4, C5: 27pF; C_Disc_D4.7mm_W2.5mm_P5.00mm
C6, C7, C9: 10uF; CP_Radial_D5.0mm_P2.50mm
D1: LED; LED_D5.0mm
F1: 500mA; R_Axial_DIN0207_L6.3mm_D2.5mm_P10.16mm_Horizontal
H1, H2: MountingHole; MountingHole_3.2mm_M3
J1: Bus_ISA_8bit; BUS_8-bit_ISA
J2: RTS/CTS; PinHeader_1x02_P2.54mm_Vertical
J3: DTR/DSR; PinHeader_1x02_P2.54mm_Vertical
J4: TTL_Serial; PinHeader_1x04_P2.54mm_Vertical
J5: Power; PinHeader_1x02_P2.54mm_Vertical
J6: BAUD_SEL; PinHeader_2x03_P2.54mm_Vertical
J7: USB_A; USB_A_Connfly_DS1095
J8: Use_USB_PWR; PinHeader_1x03_P2.54mm_Vertical
J9: Bootload; PinHeader_1x02_P2.54mm_Vertical
J10: Color_Sel; PinHeader_2x03_P2.54mm_Vertical
J11: VGA; DSUB-15-HD_Socket_Horizontal_P2.29x1.90mm_EdgePinOffset3.03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
J12: KB; Connector_Mini-DIN_Female_6Pin_2rows
J13: ICSP; PinHeader_1x06_P2.54mm_Vertical
J14: Composite_Monitor; RCA_JACK_Right_Angle_AliExpress
R1: 1M; R_Axial_DIN0207_L6.3mm_D2.5mm_P10.16mm_Horizontal
R2: 100K; R_Axial_DIN0207_L6.3mm_D2.5mm_P10.16mm_Horizontal
R3: 10K; R_Axial_DIN0207_L6.3mm_D2.5mm_P10.16mm_Horizontal
R4: 82; R_Axial_DIN0207_L6.3mm_D2.5mm_P10.16mm_Horizontal
R5, R7, R8: 4.7K; R_Axial_DIN0207_L6.3mm_D2.5mm_P10.16mm_Horizontal
R6: 220; R_Axial_DIN0207_L6.3mm_D2.5mm_P10.16mm_Horizontal
R9: 150; R_Axial_DIN0207_L6.3mm_D2.5mm_P10.16mm_Horizontal
R10: 470; R_Axial_DIN0207_L6.3mm_D2.5mm_P10.16mm_Horizontal
U1: GAL16V8; DIP-20_W7.62mm
U2: 6551; DIP-28_W15.24mm
U3: MCP1700x-330xxTO; TO-92_Wide
U4: PIC32MX250F128B_DIP28; DIP-28_W7.62mm
Y1: 1.8432MHz; Crystal_HC18-U_Vertical
Y2: 8MHz; Crystal_HC18-U_Vertical

Connections:
+3.3V: C7.1, C8.1, C10.1, D1.2 (A), J4.1, J13.2, R2.1, U3.3 (VO), U4.13 (VDD), U4.23 (V_{USB_3.3V}), U4.28 (AVDD)
+5C: C6.1, F1.2, J12.4, R7.1, R8.1, U3.2 (VI)
+5VB: C1.1, C2.1, J1.3 (VCC), J1.29 (VCC), J5.1, J8.1, U1.20 (VCC), U2.15 (VCC)
/Baud_A: J6.2, U4.11 (RB4)
/Baud_B: J6.4, U4.7 (RB3)
/Baud_C: J6.6, J13.5, U4.3 (PGEC3/RA1)
/Comp_Video: R9.1, U4.6 (RB2)
/H_{SYNCH}: J11.13, R10.2, U4.18 (RB9), U4.25 (RB14)
/KB_CLK: J12.5, R7.2, U4.17 (RB8)
/KB_DATA: J12.1, R8.2, U4.16 (RB7)
/PGD: J13.4, U4.2 (PGED3/RA0)
/RXD: J4.2, R2.2, R3.1, U2.10 (TxD)
/RX_{3.3V}: R3.2, U4.5 (RB1)
/TXD: J4.3, U2.12 (RxD), U4.4 (PGED1/RB0)
/USB_D+: J7.3 (D+), U4.21 (RB10)
/USB_D-: J7.2 (D-), U4.22 (RB11)
/VGA_VIDEO: R6.2, U4.12 (RA4)
/V_{SYNCH}: J11.14, U4.24 (RB13)
/~MCLR: J13.1, U4.1 (~MCLR)
/~RESET_RAW: J1.2 (RESET), U1.9 (I9)
/~RESET: U1.18 (IO2), U2.4 (~RES)
A0: J1.62 (BA00), U2.13 (RS0)
A1: J1.61 (BA01), U2.14 (RS1)
A2: J1.60 (BA02), U1.8 (I8)
A3: J1.59 (BA03), U1.7 (I7)
A4: J1.58 (BA04), U1.6 (I6)
A5: J1.57 (BA05), U1.5 (I5)
A6: J1.56 (BA06), U1.4 (I4)
A7: J1.55 (BA07), U1.3 (I3)
A8: J1.54 (BA08)
A9: J1.53 (BA09)
A10: J1.52 (BA10)
A11: J1.51 (BA11)
A12: J1.50 (BA12)
A13: J1.49 (BA13)
A14: J1.48 (BA14)
A15: J1.47 (BA15)
CLK: J1.30 (OSC), U2.27 (ϕ2)
D0: J1.40 (DB0), U2.18 (D0)
D1: J1.39 (DB1), U2.19 (D1)
D2: J1.38 (DB2), U2.20 (D2)
D3: J1.37 (DB3), U2.21 (D3)
D4: J1.36 (DB4), U2.22 (D4)
D5: J1.35 (DB5), U2.23 (D5)
D6: J1.34 (DB6), U2.24 (D6)
D7: J1.33 (DB7), U2.25 (D7)
GND: C1.2, C2.2, C3.2, C4.2, C5.2, C6.2, C7.2, C8.2, C9.2, C10.2, J1.1 (GND), J1.10 (GND), J1.31 (GND), J4.4, J5.2, J6.1, J6.3, J6.5, J7.4 (GND), J7.SH (Shield), J9.2, J11.5, J11.6, J11.7, J11.8, J11.10, J11.SH, J12.3, J12.7, J13.3, J14.2 (Ext), U1.10 (GND), U2.1 (VSS), U3.1 (GND), U4.8 (VSS), U4.19 (VSS), U4.27 (A_{VSS})
unnamed: D1.1 (K), R4.1
unnamed: J1.32 (IO), U1.2 (I2), U2.3 (~CS2)
unnamed: J2.1, U2.8 (~RTS)
unnamed: J2.2, U2.9 (~CTS)
unnamed: J3.1, U2.11 (~DTR)
unnamed: J3.2, U2.17 (~DSR)
unnamed: J7.1 (VBUS), J8.3, R5.1
unnamed: F1.1, J8.2
unnamed: J9.1, R4.2, U4.14 (RB5)
unnamed: J10.1, J10.3, J10.5, R6.1
unnamed: J10.2, J11.1
unnamed: J10.4, J11.2
unnamed: J10.6, J11.3
unnamed: J14.1 (In), R9.2, R10.1
unnamed: U1.19 (IO1), U2.2 (CS1)
unnamed: R1.2, U2.6 (XTAL1), Y1.2
unnamed: C3.1, R1.1, U2.7 (XTAL2), Y1.1
unnamed: C4.1, U4.9 (OSC1/RA2), Y2.1
unnamed: C5.1, U4.10 (OSC2/RA3), Y2.2
unnamed: C9.1, U4.20 (VCAP)
unnamed: R5.2, U4.15 (V_{BUS})
~CLK: J1.20 (CLK)
~DMA: J1.6 (DRQ2)
~IO_{W}: J1.13 (~IOW), U2.28 (R/~W)
~IRQ5: J1.23 (IRQ5), U2.26 (~IRQ)
