dfmcwhir/Multi_Architecture_DIY_Computer/Add-On_Cards/ISA_KB_MONITOR_TERM/ISA_MON_KEYBOARD_TERM.kicad_pcb

## KiCad design Add-On_Cards/ISA_KB_MONITOR_TERM/ISA_MON_KEYBOARD_TERM.kicad_pcb (continued)

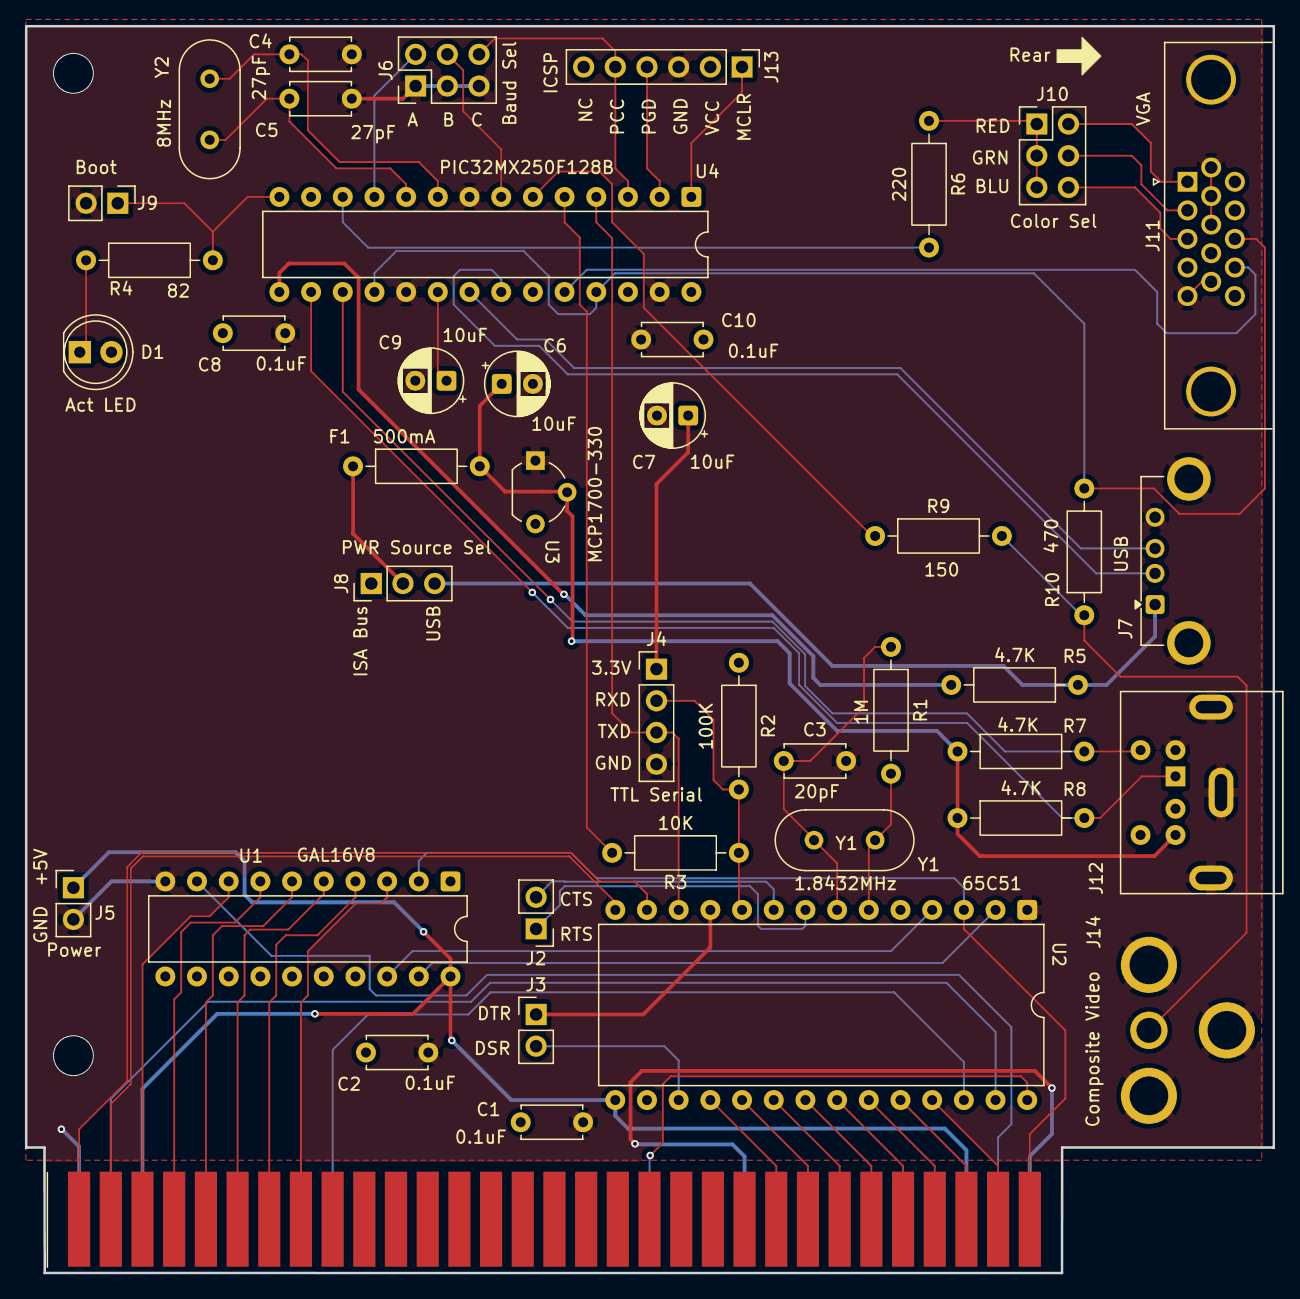
[picture p91: board ISA_MON_KEYBOARD_TERM.kicad_pcb from above]

Board: 2 copper layers, 100.0 x 99.9 mm, 44 parts (0 on the bottom side), 62 nets.
