dfmcwhir/Multi_Architecture_DIY_Computer/Add-On_Cards/ISA_AY-3-8910_Sound/ISA_AY-3-8910_Sound.kicad_pcb

## KiCad design Add-On_Cards/ISA_AY-3-8910_Sound/ISA_AY-3-8910_Sound.kicad_pcb (2026-11-05)

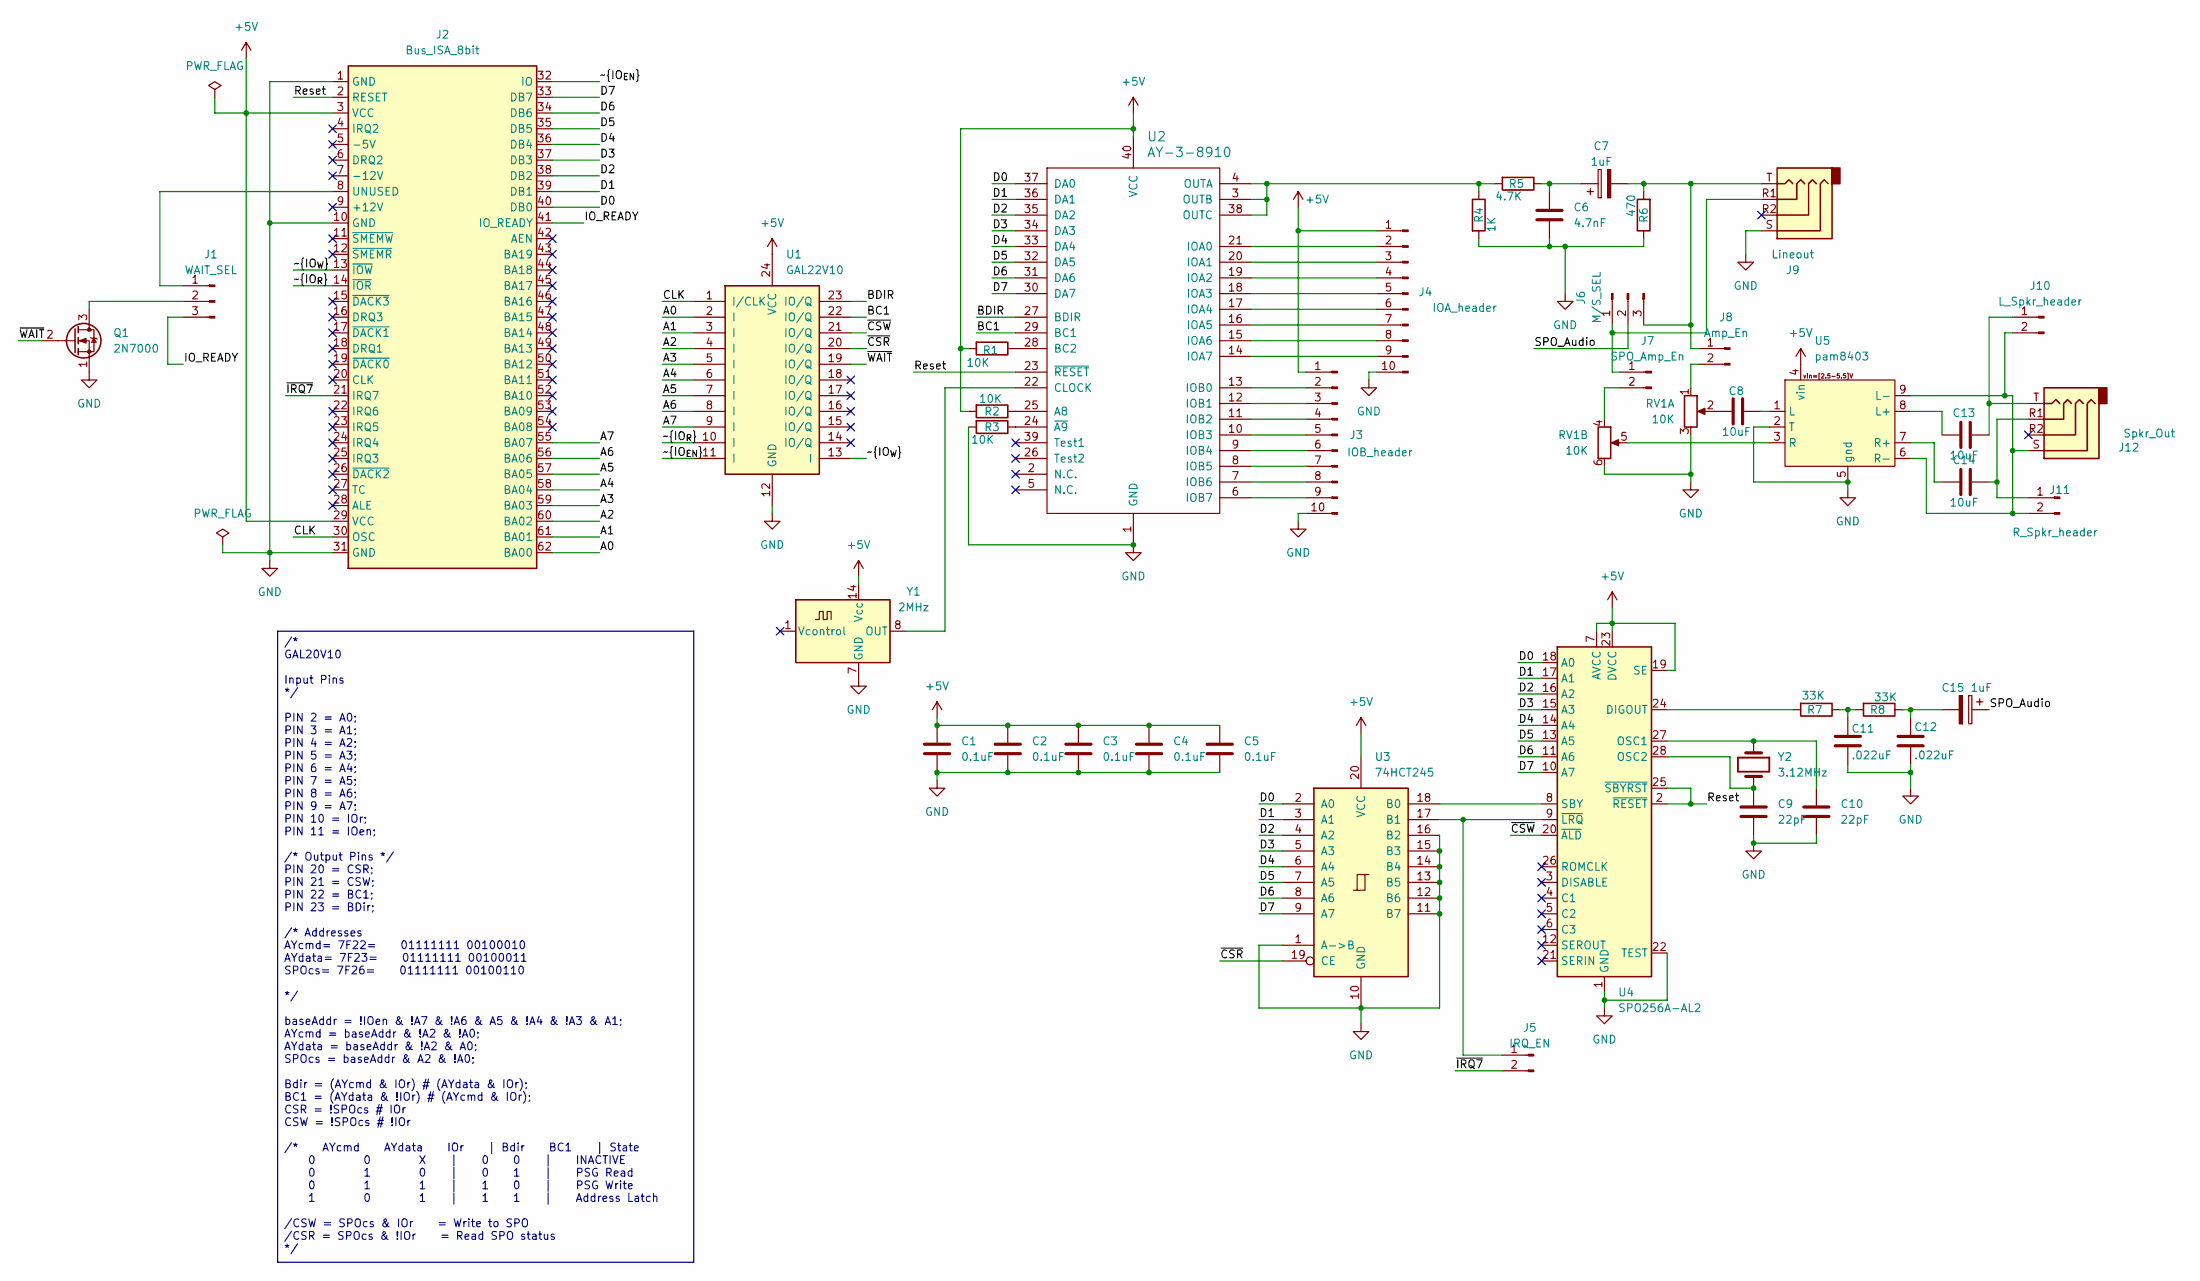
[picture p92: schematic ISA_AY-3-8910_Sound.kicad_sch]

Parts:
C1, C2, C3, C4, C5: 0.1uF; C_Disc_D4.7mm_W2.5mm_P5.00mm
C6: 4.7nF; C_Disc_D4.7mm_W2.5mm_P5.00mm
C7, C15: 1uF; CP_Radial_D6.3mm_P2.50mm
C8, C13, C14: 10uF; C_Disc_D4.7mm_W2.5mm_P5.00mm
C9, C10: 22pF; C_Disc_D4.7mm_W2.5mm_P5.00mm
C11, C12: .022uF; C_Disc_D4.7mm_W2.5mm_P5.00mm
J1: WAIT_SEL; PinHeader_1x03_P2.54mm_Vertical
J2: Bus_ISA_8bit; BUS_8-bit_ISA_CARD
J3: IOB_header; PinHeader_1x10_P2.54mm_Vertical
J4: IOA_header; PinHeader_1x10_P2.54mm_Vertical
J5: IRQ_EN; PinHeader_1x02_P2.54mm_Vertical
J6: M/S_SEL; PinHeader_1x03_P2.54mm_Vertical
J7: SPO_Amp_En; PinHeader_1x02_P2.54mm_Vertical
J8: Amp_En; PinHeader_1x02_P2.54mm_Vertical
J9: Lineout; Jack_3.5mm_PJ320E_Horizontal
J10: L_Spkr_header; PinHeader_1x02_P2.54mm_Vertical
J11: Spkr_Out; Jack_3.5mm_PJ320E_Horizontal
J12: R_Spkr_header; PinHeader_1x02_P2.54mm_Vertical
Q1: 2N7000; TO-92_Inline_Wide
R1, R2, R3: 10K; R_Axial_DIN0207_L6.3mm_D2.5mm_P10.16mm_Horizontal
R4: 1K; R_Axial_DIN0207_L6.3mm_D2.5mm_P10.16mm_Horizontal
R5: 4.7K; R_Axial_DIN0207_L6.3mm_D2.5mm_P10.16mm_Horizontal
R6: 470; R_Axial_DIN0207_L6.3mm_D2.5mm_P10.16mm_Horizontal
R7, R8: 33K; R_Axial_DIN0207_L6.3mm_D2.5mm_P10.16mm_Horizontal
RV1: 10K; Potentiometer_Alps_RK097_Dual_Horizontal
U1: GAL22V10; DIP-24_W7.62mm
U2: AY-3-8910; DIP-40_W15.24mm
U3: 74HCT245; DIP-20_W7.62mm
U4: SPO256A-AL2; DIP-28_W15.24mm
U5: pam8403
Y1: 2MHz; Oscillator_DIP-14
Y2: 3.12MHz; Crystal_HC18-U_Vertical

Connections:
+5V: C1.1, C2.1, C3.1, C4.1, C5.1, J2.3 (VCC), J2.29 (VCC), J3.1, J4.1, R1.2, R2.2, U1.24 (VCC), U2.40 (VCC), U3.20 (VCC), U4.7 (AVCC), U4.19 (SE), U4.23 (DVCC), U5.4 (vin), Y1.14 (Vcc)
/A0: J2.62 (BA00), U1.2 (I)
/A1: J2.61 (BA01), U1.3 (I)
/A2: J2.60 (BA02), U1.4 (I)
/A3: J2.59 (BA03), U1.5 (I)
/A4: J2.58 (BA04), U1.6 (I)
/A5: J2.57 (BA05), U1.7 (I)
/A6: J2.56 (BA06), U1.8 (I)
/A7: J2.55 (BA07), U1.9 (I)
/BC1: U1.22 (IO/Q), U2.29 (BC1)
/BDIR: U1.23 (IO/Q), U2.27 (BDIR)
/CLK: J2.30 (OSC), U1.1 (I/CLK)
/D0: J2.40 (DB0), U2.37 (DA0), U3.2 (A0), U4.18 (A0)
/D1: J2.39 (DB1), U2.36 (DA1), U3.3 (A1), U4.17 (A1)
/D2: J2.38 (DB2), U2.35 (DA2), U3.4 (A2), U4.16 (A2)
/D3: J2.37 (DB3), U2.34 (DA3), U3.5 (A3), U4.15 (A3)
/D4: J2.36 (DB4), U2.33 (DA4), U3.6 (A4), U4.14 (A4)
/D5: J2.35 (DB5), U2.32 (DA5), U3.7 (A5), U4.13 (A5)
/D6: J2.34 (DB6), U2.31 (DA6), U3.8 (A6), U4.11 (A6)
/D7: J2.33 (DB7), U2.30 (DA7), U3.9 (A7), U4.10 (A7)
/IO_READY: J1.3, J2.41 (IO_READY)
/Reset: J2.2 (RESET), U2.23 (~RESET), U4.2 (~RESET), U4.25 (~SBYRST)
/SPO_Audio: C15.1, J6.2
/~CSR: U1.20 (IO/Q), U3.19 (CE)
/~CSW: U1.21 (IO/Q), U4.20 (~ALD)
/~IO_{EN}: J2.32 (IO), U1.11 (I)
/~IO_{R}: J2.14 (~IOR), U1.10 (I)
/~IO_{W}: J2.13 (~IOW), U1.13 (I)
/~IRQ7: J2.21 (IRQ7), J5.2
/~WAIT: Q1.2 (G), U1.19 (IO/Q)
GND: C1.2, C2.2, C3.2, C4.2, C5.2, C6.2, C9.2, C10.2, C11.2, C12.2, J2.1 (GND), J2.10 (GND), J2.31 (GND), J3.10, J4.10, J9.S, Q1.1 (S), R3.2, R4.2, R6.1, RV1.3, RV1.6, U1.12 (GND), U2.1 (GND), U3.1 (A->B), U3.10 (GND), U3.11 (B7), U3.12 (B6), U3.13 (B5), U3.14 (B4), U3.15 (B3), U3.16 (B2), U4.1 (GND), U4.22 (TEST), U5.2 (T), U5.5 (gnd), Y1.7 (GND)
unnamed: C6.1, C7.1, R5.1
unnamed: C8.2, RV1.2
unnamed: C11.1, R7.1, R8.2
unnamed: C12.1, C15.2, R8.1
unnamed: J1.1, J2.8 (UNUSED)
unnamed: J1.2, Q1.3 (D)
unnamed: J3.2, U2.13 (IOB0)
unnamed: J3.3, U2.12 (IOB1)
unnamed: J3.4, U2.11 (IOB2)
unnamed: J3.5, U2.10 (IOB3)
unnamed: J3.6, U2.9 (IOB4)
unnamed: J3.7, U2.8 (IOB5)
unnamed: J3.8, U2.7 (IOB6)
unnamed: J3.9, U2.6 (IOB7)
unnamed: J4.2, U2.21 (IOA0)
unnamed: J4.3, U2.20 (IOA1)
unnamed: J4.4, U2.19 (IOA2)
unnamed: J4.5, U2.18 (IOA3)
unnamed: J4.6, U2.17 (IOA4)
unnamed: J4.7, U2.16 (IOA5)
unnamed: J4.8, U2.15 (IOA6)
unnamed: J4.9, U2.14 (IOA7)
unnamed: J5.1, U3.17 (B1), U4.9 (~LRQ)
unnamed: J6.1, J7.1, J9.R1
unnamed: C7.2, J6.3, J8.1, J9.T, R6.2
unnamed: J7.2, RV1.4
unnamed: J8.2, RV1.1
unnamed: C13.1, J10.1, J11.T
unnamed: J10.2, J11.S, J12.2, U5.6 (R-), U5.9 (L-)
unnamed: C14.1, J11.R1, J12.1
unnamed: R2.1, U2.25 (A8)
unnamed: R1.1, U2.28 (BC2)
unnamed: U2.22 (CLOCK), Y1.8 (OUT)
unnamed: R4.1, R5.2, U2.3 (OUTB), U2.4 (OUTA), U2.38 (OUTC)
unnamed: R3.1, U2.24 (~A9)
unnamed: U3.18 (B0), U4.8 (SBY)
unnamed: R7.2, U4.24 (DIGOUT)
unnamed: C10.1, U4.27 (OSC1), Y2.1
unnamed: C9.1, U4.28 (OSC2), Y2.2
unnamed: C8.1, U5.1 (L)
unnamed: C13.2, U5.8 (L+)
unnamed: RV1.5, U5.3 (R)
unnamed: C14.2, U5.7 (R+)

Notes on the sheet:
/* GAL20V10 Input Pins */ PIN 2 = A0; PIN 3 = A1; PIN 4 = A2; PIN 5 = A3; PIN 6 = A4; PIN 7 = A5; PIN 8 = A6; PIN 9 = A7; PIN 10 = IOr; PIN 11 = IOen; /* Output Pins */ PIN 20 = CSR; PIN 21 = CSW; PIN 22 = BC1; PIN 23 = BDir; /* Addresses AYcmd= 7F22= 01111111 00100010 AYdata= 7F23= 01111111 001000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

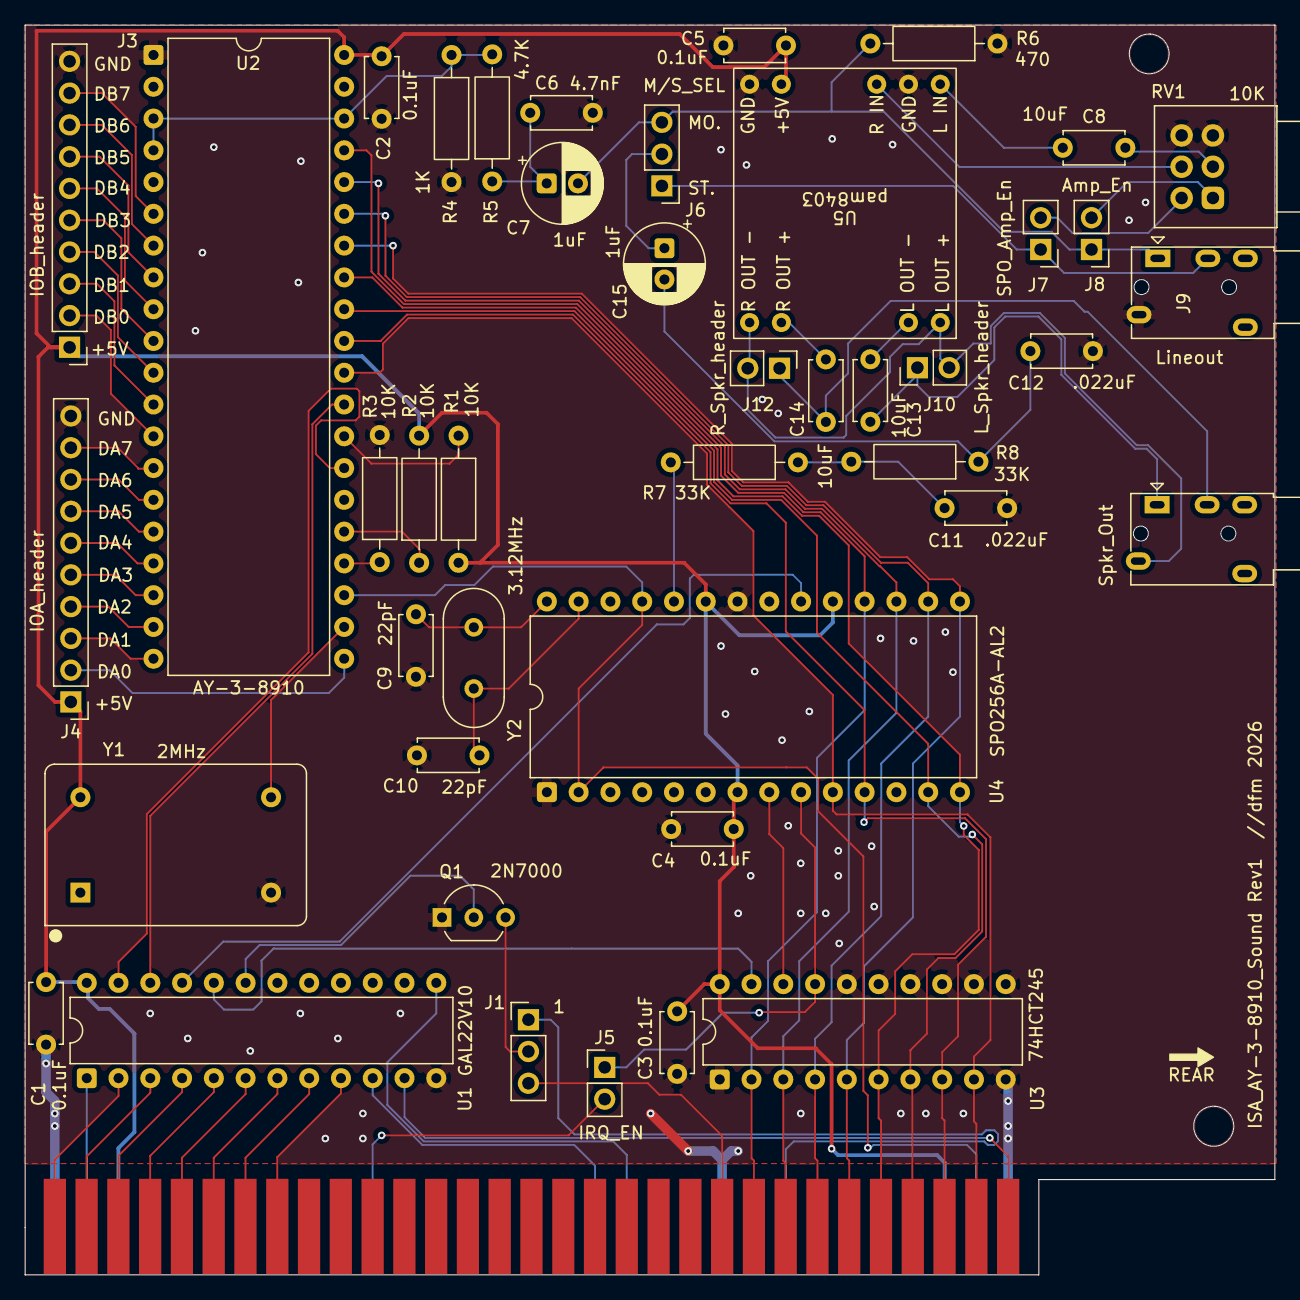
[picture p93: board ISA_AY-3-8910_Sound.kicad_pcb from above]

Board: 2 copper layers, 99.9 x 99.9 mm, 44 parts (0 on the bottom side), 74 nets.
