dfmcwhir/Multi_Architecture_DIY_Computer/Add-On_Cards/ISA_ESP32_VGA/ISA_ESP32_VGA.kicad_pcb

## KiCad design Add-On_Cards/ISA_ESP32_VGA/ISA_ESP32_VGA.kicad_pcb (2026-11-05)

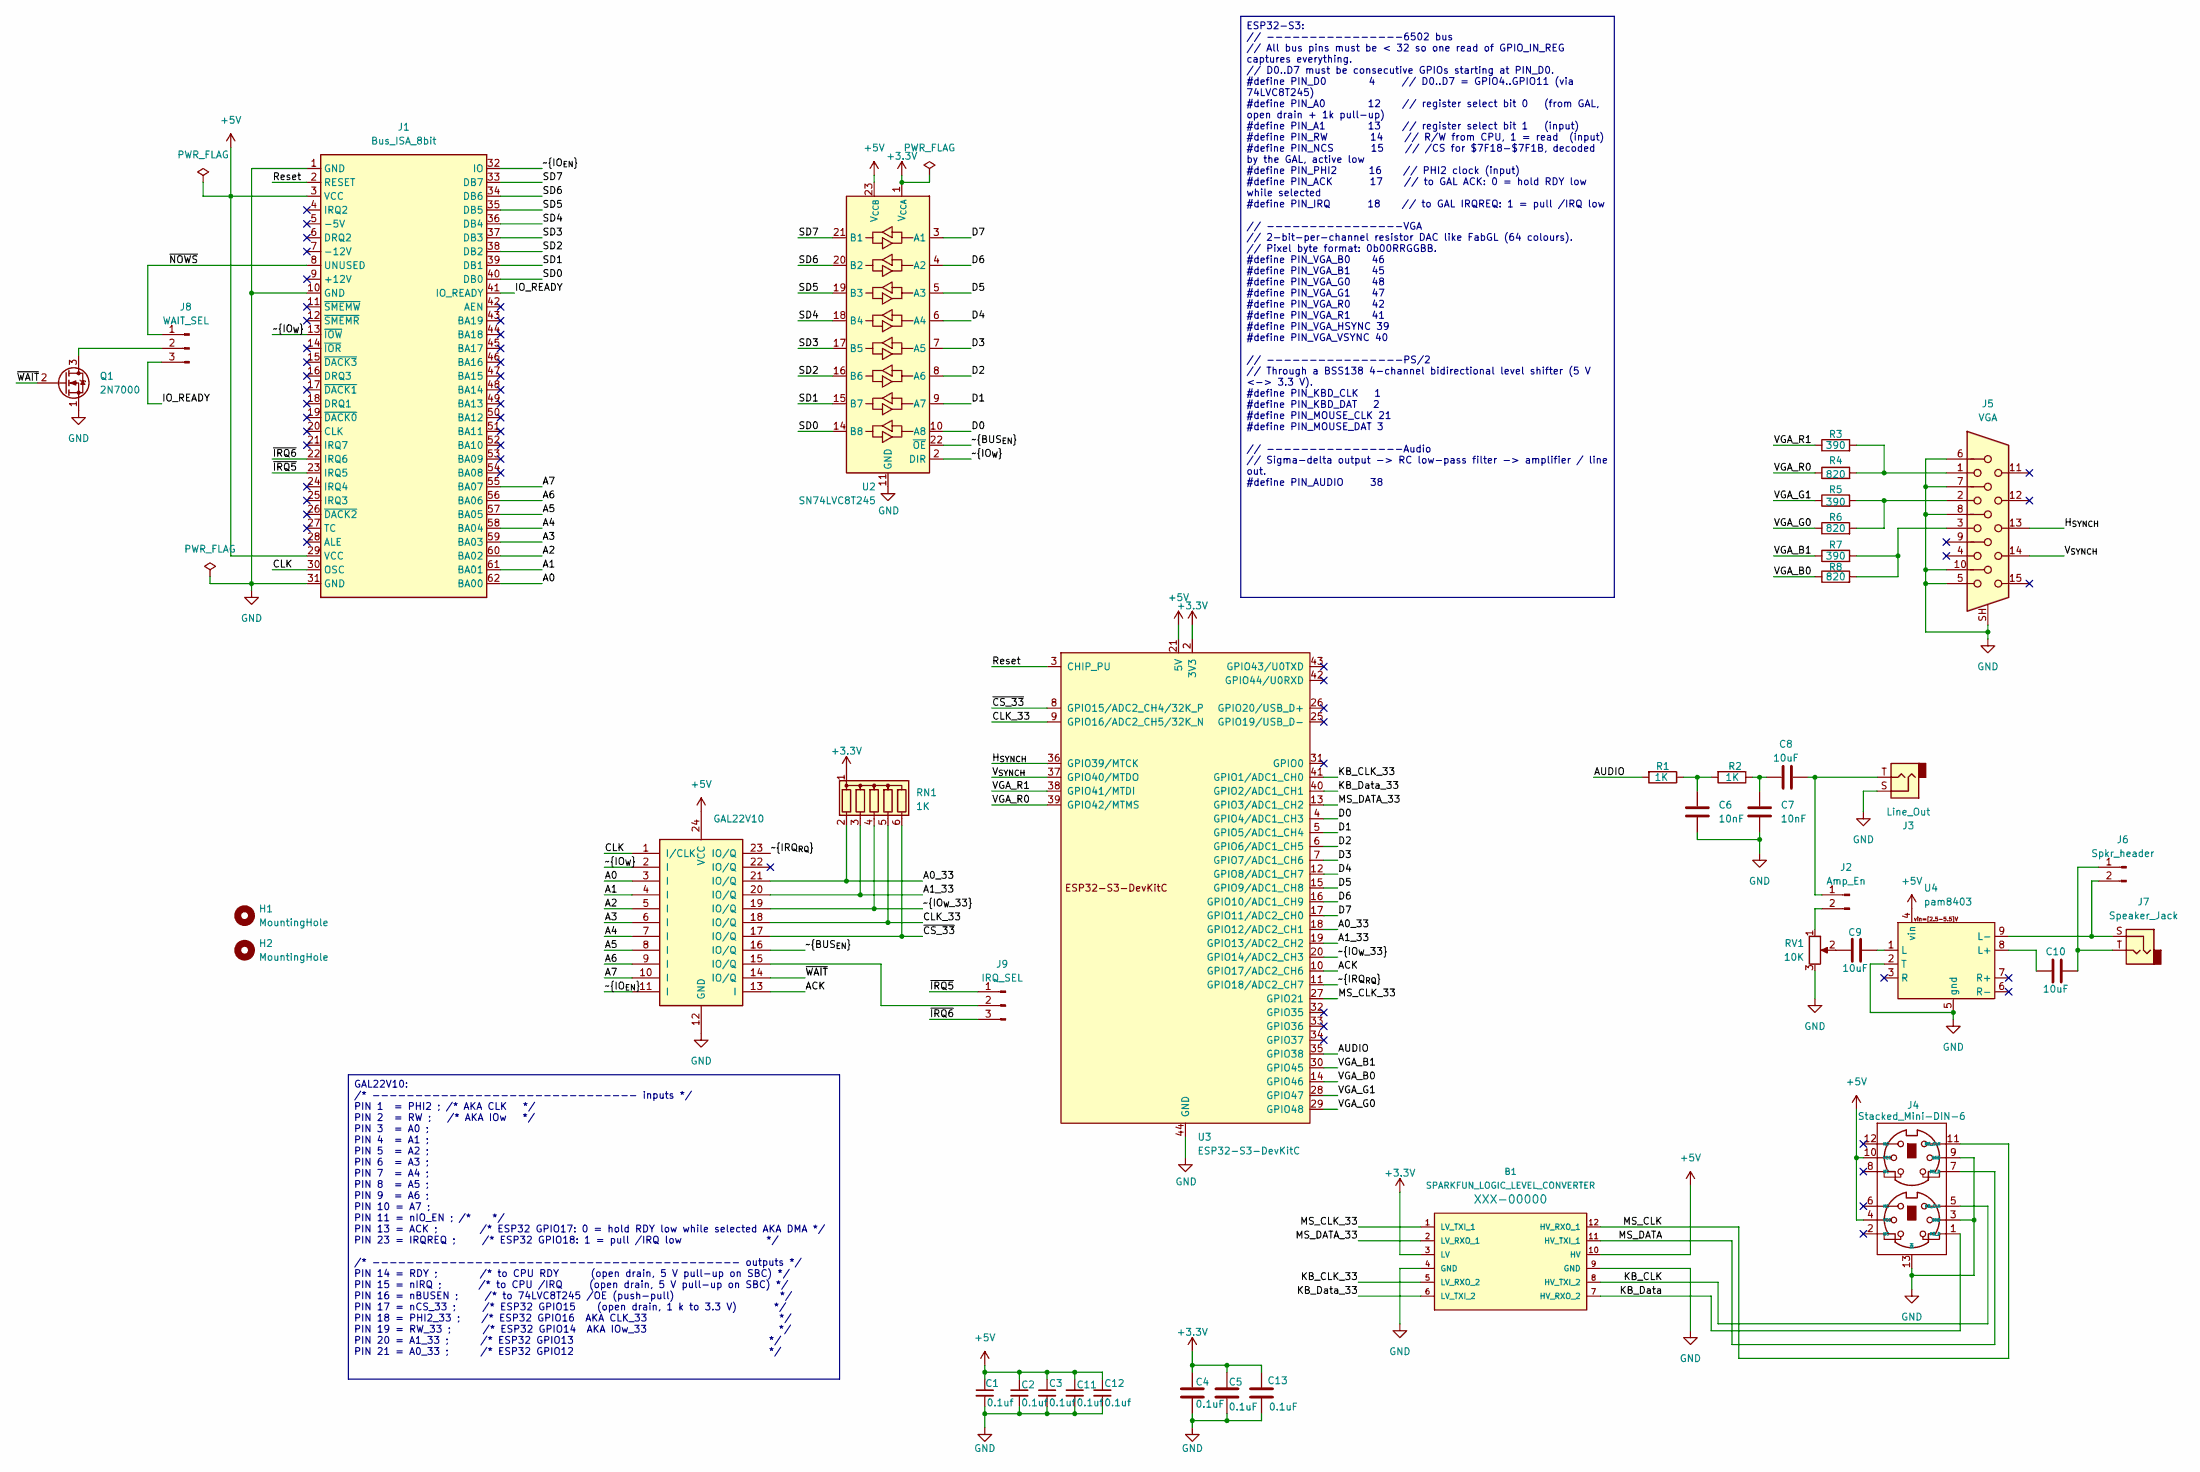
[picture p94: schematic ISA_ESP32_VGA.kicad_sch]

Parts:
B1: SPARKFUN_LOGIC_LEVEL_CONVERTER; 4_Chan_Logic_level_shifter_module
C1, C2, C3, C11, C12: 0.1uf; C_Disc_D4.7mm_W2.5mm_P5.00mm; Voltage 50V; Tolerance 5%
C4, C5, C13: 0.1uF; C_Disc_D4.7mm_W2.5mm_P5.00mm
C6, C7: 10nF; C_Disc_D4.7mm_W2.5mm_P5.00mm
C8, C9, C10: 10uF; C_Disc_D4.7mm_W2.5mm_P5.00mm
H1, H2: MountingHole; MountingHole_3.2mm_M3
J1: Bus_ISA_8bit; BUS_8-bit_ISA
J2: Amp_En; PinHeader_1x02_P2.54mm_Vertical
J3: Line_Out; Jack_3.5mm_PJ320E_Horizontal
J4: Stacked_Mini-DIN-6; Stacked_Mini-DIN_Female_6Pin_2rows
J5: VGA; DSUB-15-HD_Socket_Horizontal_P2.29x1.90mm_EdgePinOffset3.03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
J6: Spkr_header; PinHeader_1x02_P2.54mm_Vertical
J7: Speaker_Jack; Jack_3.5mm_PJ320E_Horizontal
J8: WAIT_SEL; PinHeader_1x03_P2.54mm_Vertical
J9: IRQ_SEL; PinHeader_1x03_P2.54mm_Vertical
Q1: 2N7000; TO-92_Inline_Wide
R1, R2: 1K; R_Axial_DIN0204_L3.6mm_D1.6mm_P5.08mm_Horizontal
R3, R5, R7: 390; R_Axial_DIN0204_L3.6mm_D1.6mm_P5.08mm_Horizontal
R4, R6, R8: 820; R_Axial_DIN0204_L3.6mm_D1.6mm_P5.08mm_Horizontal
RN1: 1K; R_Array_SIP6
RV1: 10K; Potentiometer_Alps_RK097_Dual_Horizontal
U1: GAL22V10; DIP-24_W7.62mm
U2: SN74LVC8T245; SOP-24_7.5x15.4mm_P1.27mm
U3: ESP32-S3-DevKitC; ESP32-S2-DevKitC-1
U4: pam8403

Connections:
+3.3V: B1.3 (LV), C4.1, C5.1, C13.1, RN1.1 (common), U2.1 (V_{CCA}), U3.1 (3V3), U3.2 (3V3)
+5V: B1.10 (HV), C1.1, C2.1, C3.1, C11.1, C12.1, J1.3 (VCC), J1.29 (VCC), J4.4 (VCC), J4.10 (VCC), U1.24 (VCC), U2.23 (V_{CCB}), U2.24 (V_{CCB}), U3.21 (5V), U4.4 (vin)
/A0: J1.62 (BA00), U1.3 (I)
/A0_33: RN1.2 (R1), U1.21 (IO/Q), U3.18 (GPIO12/ADC2_CH1)
/A1: J1.61 (BA01), U1.4 (I)
/A1_33: RN1.3 (R2), U1.20 (IO/Q), U3.19 (GPIO13/ADC2_CH2)
/A2: J1.60 (BA02), U1.5 (I)
/A3: J1.59 (BA03), U1.6 (I)
/A4: J1.58 (BA04), U1.7 (I)
/A5: J1.57 (BA05), U1.8 (I)
/A6: J1.56 (BA06), U1.9 (I)
/A7: J1.55 (BA07), U1.10 (I)
/ACK: U1.13 (I), U3.10 (GPIO17/ADC2_CH6)
/AUDIO: R1.2, U3.35 (GPIO38)
/CLK: J1.30 (OSC), U1.1 (I/CLK)
/CLK_33: RN1.5 (R4), U1.18 (IO/Q), U3.9 (GPIO16/ADC2_CH5/32K_N)
/D0: U2.10 (A8), U3.4 (GPIO4/ADC1_CH3)
/D1: U2.9 (A7), U3.5 (GPIO5/ADC1_CH4)
/D2: U2.8 (A6), U3.6 (GPIO6/ADC1_CH5)
/D3: U2.7 (A5), U3.7 (GPIO7/ADC1_CH6)
/D4: U2.6 (A4), U3.12 (GPIO8/ADC1_CH7)
/D5: U2.5 (A3), U3.15 (GPIO9/ADC1_CH8)
/D6: U2.4 (A2), U3.16 (GPIO10/ADC1_CH9)
/D7: U2.3 (A1), U3.17 (GPIO11/ADC2_CH0)
/H_{SYNCH}: J5.13, U3.36 (GPIO39/MTCK)
/IO_READY: J1.41 (IO_READY), J8.3
/KB_CLK: B1.8 (HV_TXI_2), J4.5 (KB_CLK)
/KB_CLK_33: B1.5 (LV_RXO_2), U3.41 (GPIO1/ADC1_CH0)
/KB_Data: B1.7 (HV_RXO_2), J4.1 (KB_D)
/KB_Data_33: B1.6 (LV_TXI_2), U3.40 (GPIO2/ADC1_CH1)
/MS_CLK: B1.12 (HV_RXO_1), J4.11 (MS_CLK)
/MS_CLK_33: B1.1 (LV_TXI_1), U3.27 (GPIO21)
/MS_DATA: B1.11 (HV_TXI_1), J4.7 (MS_D)
/MS_DATA_33: B1.2 (LV_RXO_1), U3.13 (GPIO3/ADC1_CH2)
/Reset: J1.2 (RESET), U3.3 (CHIP_PU)
/SD0: J1.40 (DB0), U2.14 (B8)
/SD1: J1.39 (DB1), U2.15 (B7)
/SD2: J1.38 (DB2), U2.16 (B6)
/SD3: J1.37 (DB3), U2.17 (B5)
/SD4: J1.36 (DB4), U2.18 (B4)
/SD5: J1.35 (DB5), U2.19 (B3)
/SD6: J1.34 (DB6), U2.20 (B2)
/SD7: J1.33 (DB7), U2.21 (B1)
/VGA_B0: R8.1, U3.14 (GPIO46)
/VGA_B1: R7.1, U3.30 (GPIO45)
/VGA_G0: R6.1, U3.29 (GPIO48)
/VGA_G1: R5.1, U3.28 (GPIO47)
/VGA_R0: R4.1, U3.39 (GPIO42/MTMS)
/VGA_R1: R3.1, U3.38 (GPIO41/MTDI)
/V_{SYNCH}: J5.14, U3.37 (GPIO40/MTDO)
/~BUS_{EN}: U1.16 (IO/Q), U2.22 (~OE)
/~CS_33: RN1.6 (R5), U1.17 (IO/Q), U3.8 (GPIO15/ADC2_CH4/32K_P)
/~IO_{EN}: J1.32 (IO), U1.11 (I)
/~IO_{W_33}: RN1.4 (R3), U1.19 (IO/Q), U3.20 (GPIO14/ADC2_CH3)
/~IO_{W}: J1.13 (~IOW), U1.2 (I), U2.2 (DIR)
/~IRQ5: J1.23 (IRQ5), J9.1
/~IRQ6: J1.22 (IRQ6), J9.3
/~IRQ_{RQ}: U1.23 (IO/Q), U3.11 (GPIO18/ADC2_CH7)
/~NOWS: J1.8 (UNUSED), J8.1
/~WAIT: Q1.2 (G), U1.14 (IO/Q)
GND: B1.4 (GND), B1.9 (GND), C1.2, C2.2, C3.2, C4.2, C5.2, C6.2, C7.2, C11.2, C12.2, C13.2, J1.1 (GND), J1.10 (GND), J1.31 (GND), J3.S, J4.3 (GND), J4.9 (GND), J4.13 (SH), J5.5, J5.6, J5.7, J5.8, J5.10, J5.SH, Q1.1 (S), RV1.3, U1.12 (GND), U2.11 (GND), U2.12 (GND), U2.13 (GND), U3.22 (GND), U3.23 (GND), U3.24 (GND), U3.44 (GND), U4.2 (T), U4.5 (gnd)
unnamed: C6.1, R1.1, R2.2
unnamed: C7.1, C8.1, R2.1
unnamed: C9.2, RV1.2
unnamed: C8.2, J2.1, J3.T
unnamed: J2.2, RV1.1
unnamed: J5.1, R3.2, R4.2
unnamed: J5.2, R5.2, R6.2
unnamed: J5.3, R7.2, R8.2
unnamed: C10.1, J6.1, J7.T
unnamed: J6.2, J7.S, U4.9 (L-)
unnamed: J8.2, Q1.3 (D)
unnamed: J9.2, U1.15 (IO/Q)
unnamed: C9.1, U4.1 (L)
unnamed: C10.2, U4.8 (L+)

Notes on the sheet:
ESP32-S3: // ----------------6502 bus // All bus pins must be < 32 so one read of GPIO_IN_REG captures everything. // D0..D7 must be consecutive GPIOs starting at PIN_D0. #define PIN_D0 4 // D0..D7 = GPIO4..GPIO11 (via 74LVC8T245) #define PIN_A0 12 // register select bit 0 (from GAL, open drain + 1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
GAL22V10: /* ------------------------------- inputs */ PIN 1 = PHI2 ; /* AKA CLK */ PIN 2 = RW ; /* AKA IOw */ PIN 3 = A0 ; PIN 4 = A1 ; PIN 5 = A2 ; PIN 6 = A3 ; PIN 7 = A4 ; PIN 8 = A5 ; PIN 9 = A6 ; PIN 10 = A7 ; PIN 11 = nIO_EN ; /* */ PIN 13 = ACK ; /* ESP32 GPIO17: 0 = hold RDY low while sele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

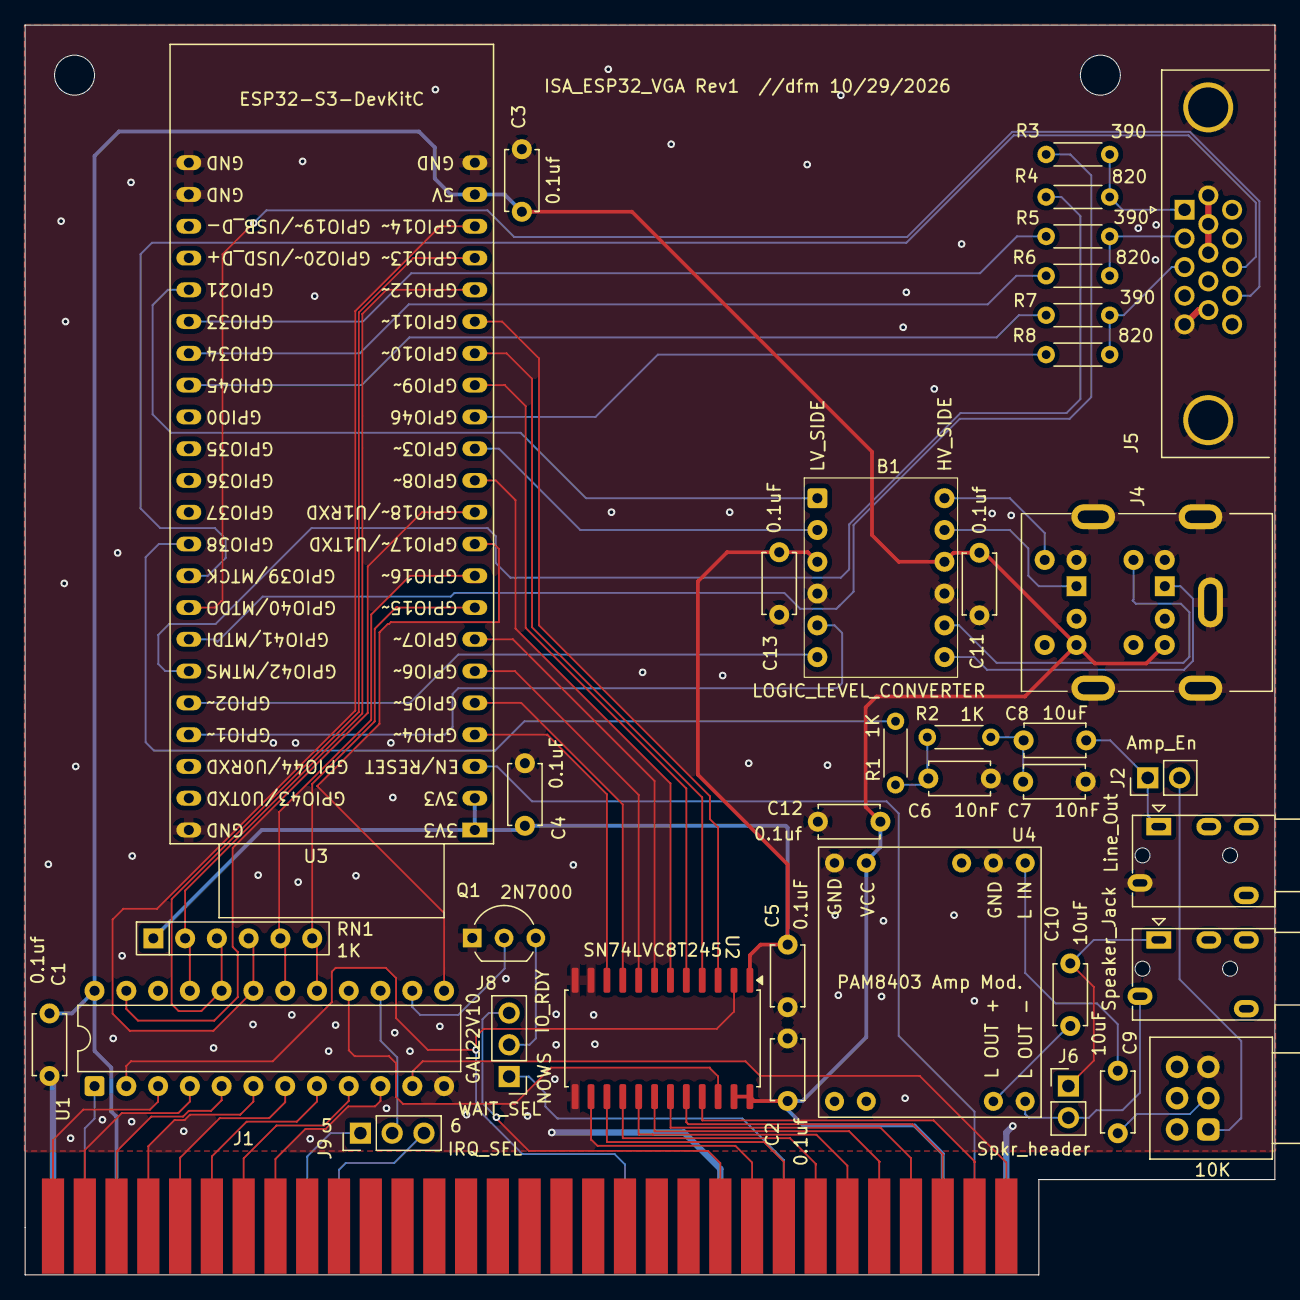
[picture p95: board ISA_ESP32_VGA.kicad_pcb from above]

Board: 2 copper layers, 99.9 x 99.9 mm, 40 parts (0 on the bottom side), 75 nets.
