dfmcwhir/Multi_Architecture_DIY_Computer/Add-On_Cards/ISA_6502_Serial_Rev3/ISA_6502_Serial_Rev3.kicad_pcb

## KiCad design Add-On_Cards/ISA_6502_Serial_Rev3/ISA_6502_Serial_Rev3.kicad_pcb (2026-11-05)

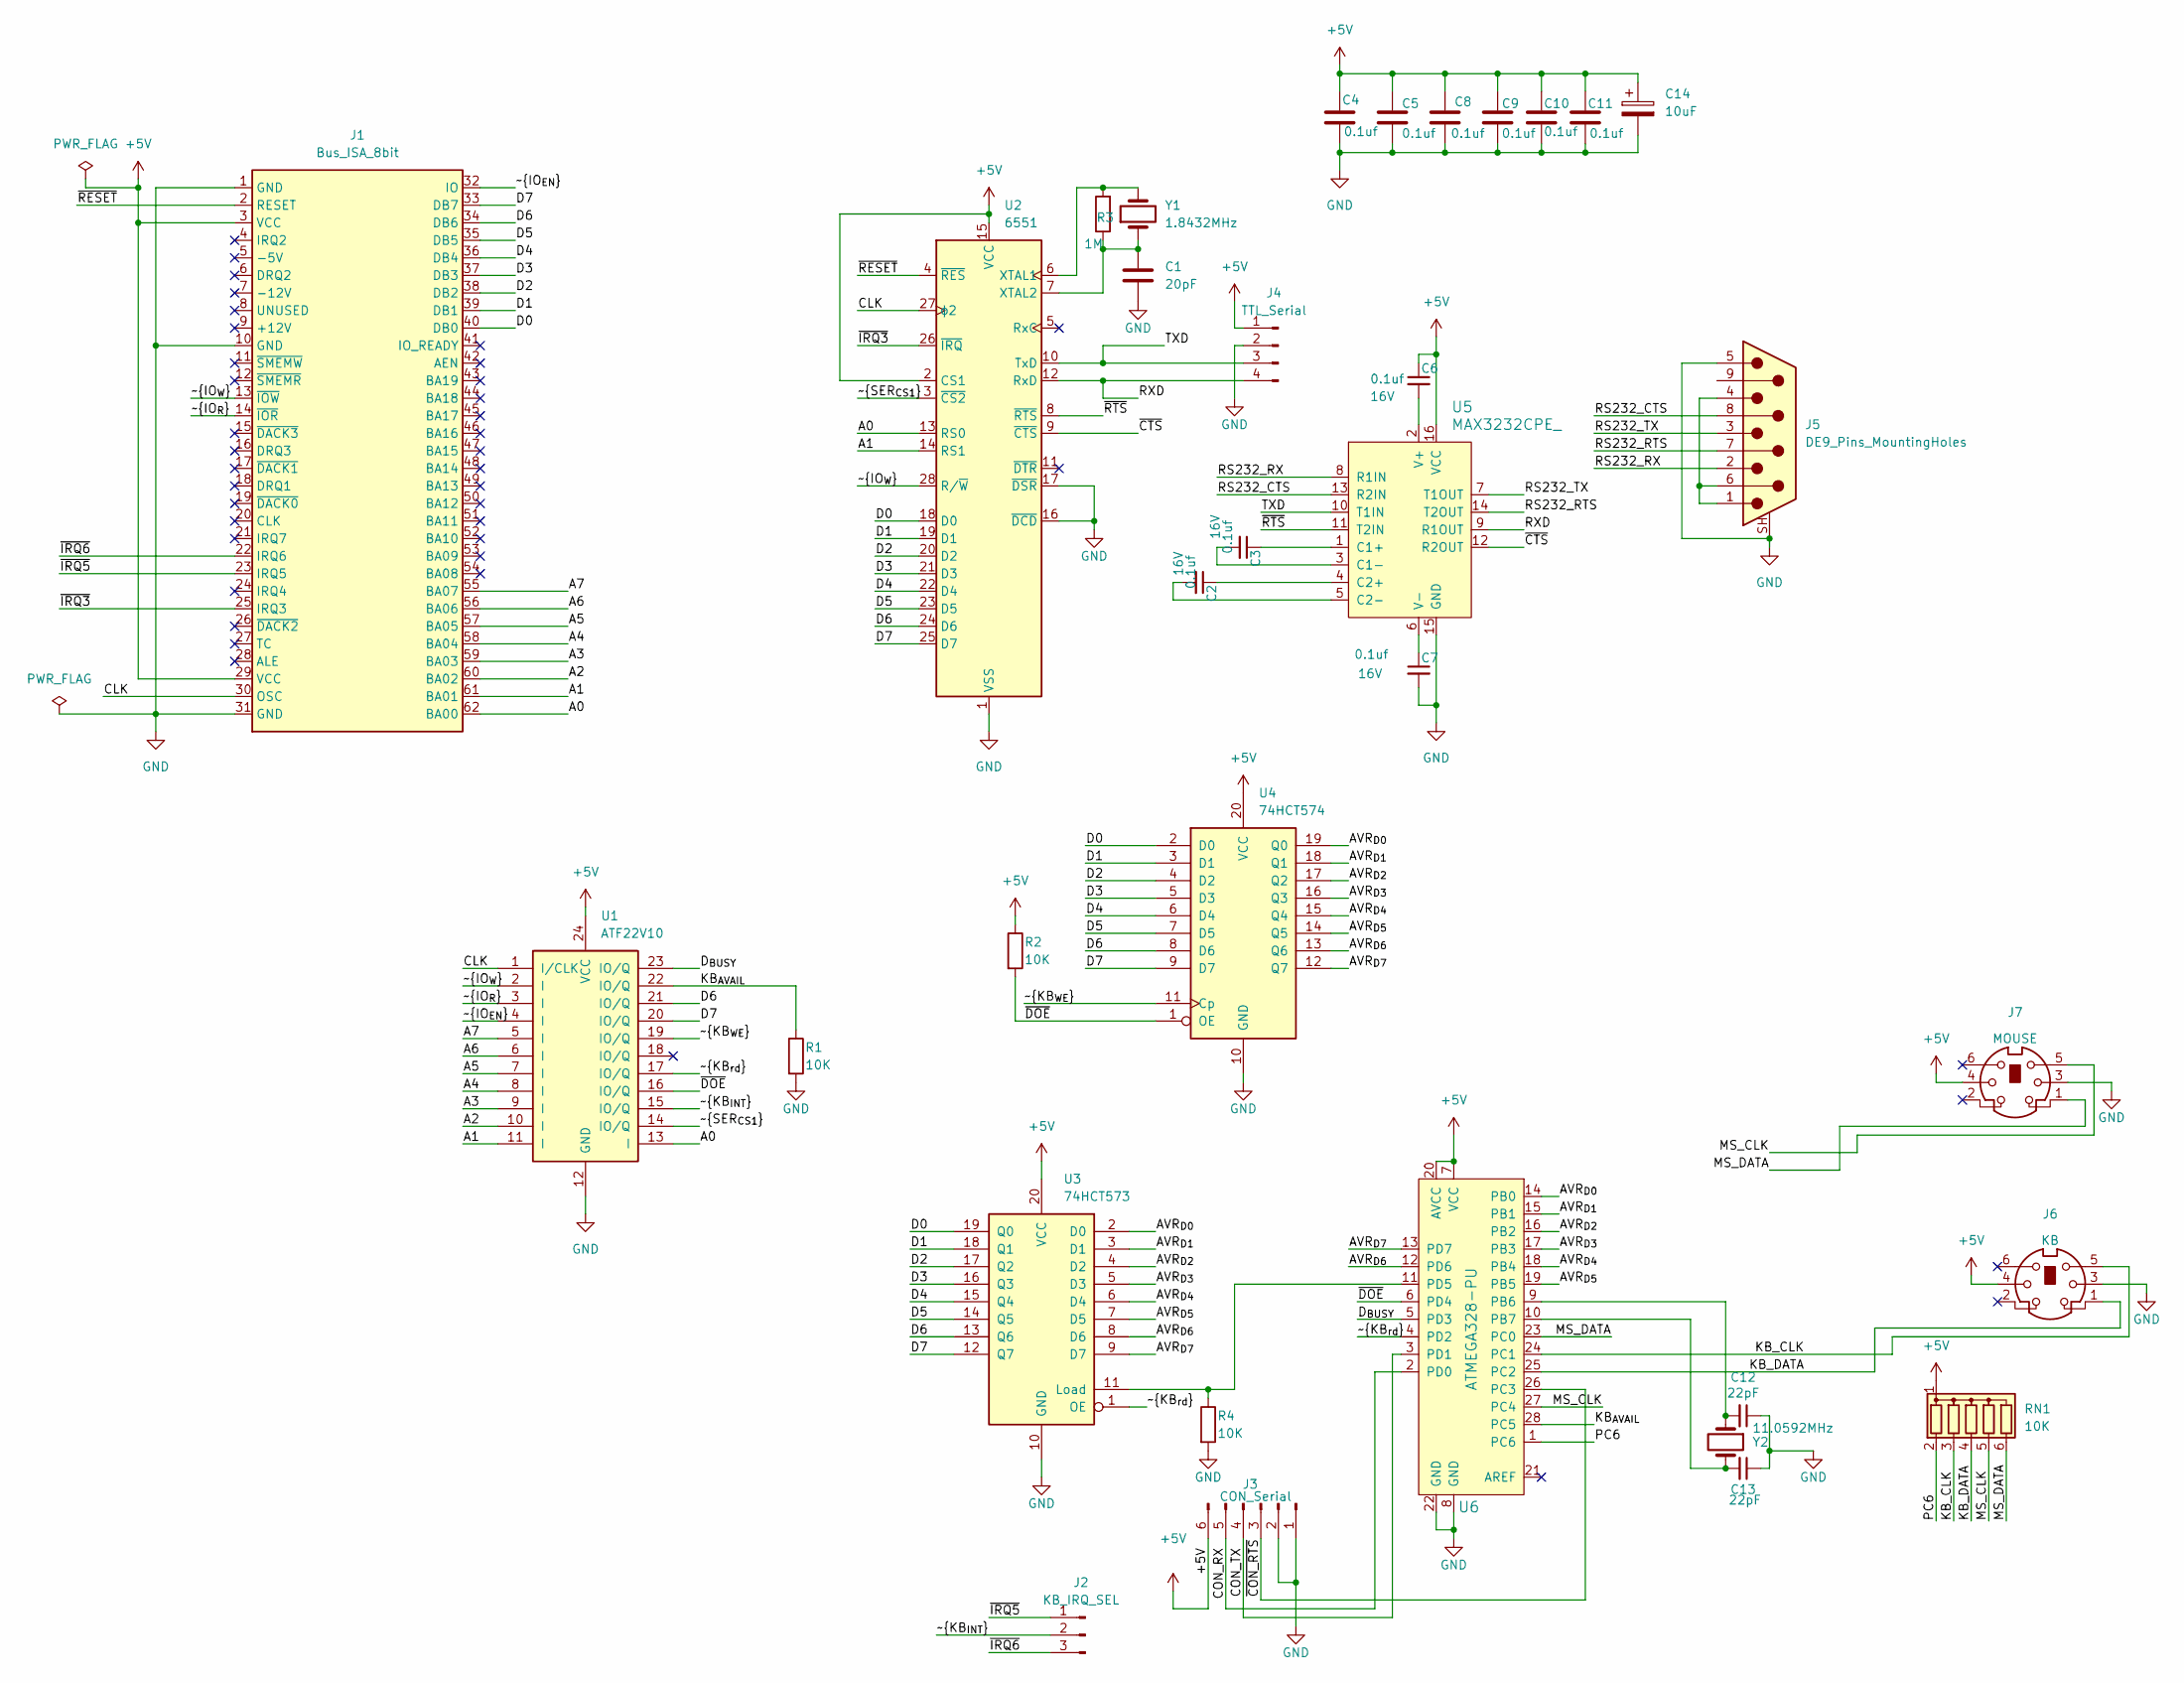
[picture p96: schematic ISA_6502_Serial_Rev3.kicad_sch]

Parts:
C1: 20pF; C_Disc_D4.7mm_W2.5mm_P5.00mm
C2, C3, C6, C7: 0.1uf; C_Disc_D4.7mm_W2.5mm_P5.00mm; Voltage 16V; Tolerance 100%
C4, C5, C8, C9, C10, C11: 0.1uf; C_Disc_D4.7mm_W2.5mm_P5.00mm
C12, C13: 22pF; C_Disc_D4.7mm_W2.5mm_P5.00mm; Voltage 50V; Tolerance 5%
C14: 10uF; CP_Radial_D5.0mm_P2.00mm
J1: Bus_ISA_8bit; BUS_8-bit_ISA_CARD
J2: KB_IRQ_SEL; PinHeader_1x03_P2.54mm_Vertical
J3: CON_Serial; PinHeader_1x06_P2.54mm_Vertical
J4: TTL_Serial; PinHeader_1x04_P2.54mm_Vertical
J5: DE9_Pins_MountingHoles; DSUB-9_Pins_Horizontal_P2.77x2.84mm_EdgePinOffset7.70mm_Hou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
J6: KB; Connector_Mini-DIN_Female_6Pin_2rows
J7: MOUSE; Connector_Mini-DIN_Female_6Pin_2rows
R1, R2, R4: 10K; R_Axial_DIN0207_L6.3mm_D2.5mm_P10.16mm_Horizontal
R3: 1M; R_Axial_DIN0207_L6.3mm_D2.5mm_P10.16mm_Horizontal
RN1: 10K; R_Array_SIP6
U1: ATF22V10; DIP-24_W7.62mm
U2: 6551; DIP-28_W15.24mm
U3: 74HCT573; DIP-20_W7.62mm
U4: 74HCT574; DIP-20_W7.62mm
U5: MAX3232CPE_; DIP-16_W7.62mm; MPN MAX3232CPE+; Digi-Key_PN MAX3232CPE+-ND
U6: ATMEGA328-PU; DIP-28_W7.62mm_Socket; MPN ATMEGA328-PU; Digi-Key_PN ATMEGA328-PU-ND
Y1: 1.8432MHz; Crystal_HC18-U_Vertical
Y2: 11.0592MHz; Crystal_HC18-U_Vertical

Connections:
+5V: C4.1, C5.1, C6.1, C8.1, C9.1, C10.1, C11.1, C14.1, J1.3 (VCC), J1.29 (VCC), J3.6, J4.1, J6.4, J7.4, R2.1, RN1.1 (common), U1.24 (VCC), U2.2 (CS1), U2.15 (VCC), U3.20 (VCC), U4.20 (VCC), U5.16 (VCC), U6.7 (VCC), U6.20 (AVCC)
/A0: J1.62 (BA00), U1.13 (I), U2.13 (RS0)
/A1: J1.61 (BA01), U1.11 (I), U2.14 (RS1)
/A2: J1.60 (BA02), U1.10 (I)
/A3: J1.59 (BA03), U1.9 (I)
/A4: J1.58 (BA04), U1.8 (I)
/A5: J1.57 (BA05), U1.7 (I)
/A6: J1.56 (BA06), U1.6 (I)
/A7: J1.55 (BA07), U1.5 (I)
/AVR_{D0}: U3.2 (D0), U4.19 (Q0), U6.14 (PB0)
/AVR_{D1}: U3.3 (D1), U4.18 (Q1), U6.15 (PB1)
/AVR_{D2}: U3.4 (D2), U4.17 (Q2), U6.16 (PB2)
/AVR_{D3}: U3.5 (D3), U4.16 (Q3), U6.17 (PB3)
/AVR_{D4}: U3.6 (D4), U4.15 (Q4), U6.18 (PB4)
/AVR_{D5}: U3.7 (D5), U4.14 (Q5), U6.19 (PB5)
/AVR_{D6}: U3.8 (D6), U4.13 (Q6), U6.12 (PD6)
/AVR_{D7}: U3.9 (D7), U4.12 (Q7), U6.13 (PD7)
/CLK: J1.30 (OSC), U1.1 (I/CLK), U2.27 (ϕ2)
/CON_RX: J3.5, U6.2 (PD0)
/CON_TX: J3.4, U6.3 (PD1)
/D0: J1.40 (DB0), U2.18 (D0), U3.19 (Q0), U4.2 (D0)
/D1: J1.39 (DB1), U2.19 (D1), U3.18 (Q1), U4.3 (D1)
/D2: J1.38 (DB2), U2.20 (D2), U3.17 (Q2), U4.4 (D2)
/D3: J1.37 (DB3), U2.21 (D3), U3.16 (Q3), U4.5 (D3)
/D4: J1.36 (DB4), U2.22 (D4), U3.15 (Q4), U4.6 (D4)
/D5: J1.35 (DB5), U2.23 (D5), U3.14 (Q5), U4.7 (D5)
/D6: J1.34 (DB6), U1.21 (IO/Q), U2.24 (D6), U3.13 (Q6), U4.8 (D6)
/D7: J1.33 (DB7), U1.20 (IO/Q), U2.25 (D7), U3.12 (Q7), U4.9 (D7)
/D_{BUSY}: U1.23 (IO/Q), U6.5 (PD3)
/KB_CLK: J6.5, RN1.3 (R2), U6.24 (PC1)
/KB_DATA: J6.1, RN1.4 (R3), U6.25 (PC2)
/KB_{AVAIL}: R1.1, U1.22 (IO/Q), U6.28 (PC5)
/MS_CLK: J7.5, RN1.5 (R4), U6.27 (PC4)
/MS_DATA: J7.1, RN1.6 (R5), U6.23 (PC0)
/PC6: RN1.2 (R1), U6.1 (PC6)
/RS232_CTS: J5.8, U5.13 (R2IN)
/RS232_RTS: J5.7, U5.14 (T2OUT)
/RS232_RX: J5.2, U5.8 (R1IN)
/RS232_TX: J5.3, U5.7 (T1OUT)
/RXD: J4.4, U2.12 (RxD), U5.9 (R1OUT)
/TXD: J4.3, U2.10 (TxD), U5.10 (T1IN)
/~CON_RTS: J3.3, U6.26 (PC3)
/~CTS: U2.9 (~CTS), U5.12 (R2OUT)
/~DOE: R2.2, U1.16 (IO/Q), U4.1 (OE), U6.6 (PD4)
/~IO_{EN}: J1.32 (IO), U1.4 (I)
/~IO_{R}: J1.14 (~IOR), U1.3 (I)
/~IO_{W}: J1.13 (~IOW), U1.2 (I), U2.28 (R/~W)
/~IRQ3: J1.25 (IRQ3), U2.26 (~IRQ)
/~IRQ5: J1.23 (IRQ5), J2.1
/~IRQ6: J1.22 (IRQ6), J2.3
/~KB_{INT}: J2.2, U1.15 (IO/Q)
/~KB_{WE}: U1.19 (IO/Q), U4.11 (Cp)
/~KB_{rd}: U1.17 (IO/Q), U3.1 (OE), U6.4 (PD2)
/~RESET: J1.2 (RESET), U2.4 (~RES)
/~RTS: U2.8 (~RTS), U5.11 (T2IN)
/~SER_{CS1}: U1.14 (IO/Q), U2.3 (~CS2)
GND: C1.2, C4.2, C5.2, C7.2, C8.2, C9.2, C10.2, C11.2, C12.1, C13.1, C14.2, J1.1 (GND), J1.10 (GND), J1.31 (GND), J3.1, J3.2, J4.2, J5.5, J5.SH (PAD), J6.3, J7.3, R1.2, R4.2, U1.12 (GND), U2.1 (VSS), U2.16 (~DCD), U2.17 (~DSR), U3.10 (GND), U4.10 (GND), U5.15 (GND), U6.8 (GND), U6.22 (GND)
unnamed: J5.1, J5.4, J5.6
unnamed: R3.2, U2.6 (XTAL1), Y1.2
unnamed: C1.1, R3.1, U2.7 (XTAL2), Y1.1
unnamed: R4.1, U3.11 (Load), U6.11 (PD5)
unnamed: C3.1, U5.1 (C1+)
unnamed: C3.2, U5.3 (C1-)
unnamed: C2.1, U5.4 (C2+)
unnamed: C2.2, U5.5 (C2-)
unnamed: C6.2, U5.2 (V+)
unnamed: C7.1, U5.6 (V-)
unnamed: C12.2, U6.9 (PB6), Y2.1
unnamed: C13.2, U6.10 (PB7), Y2.2

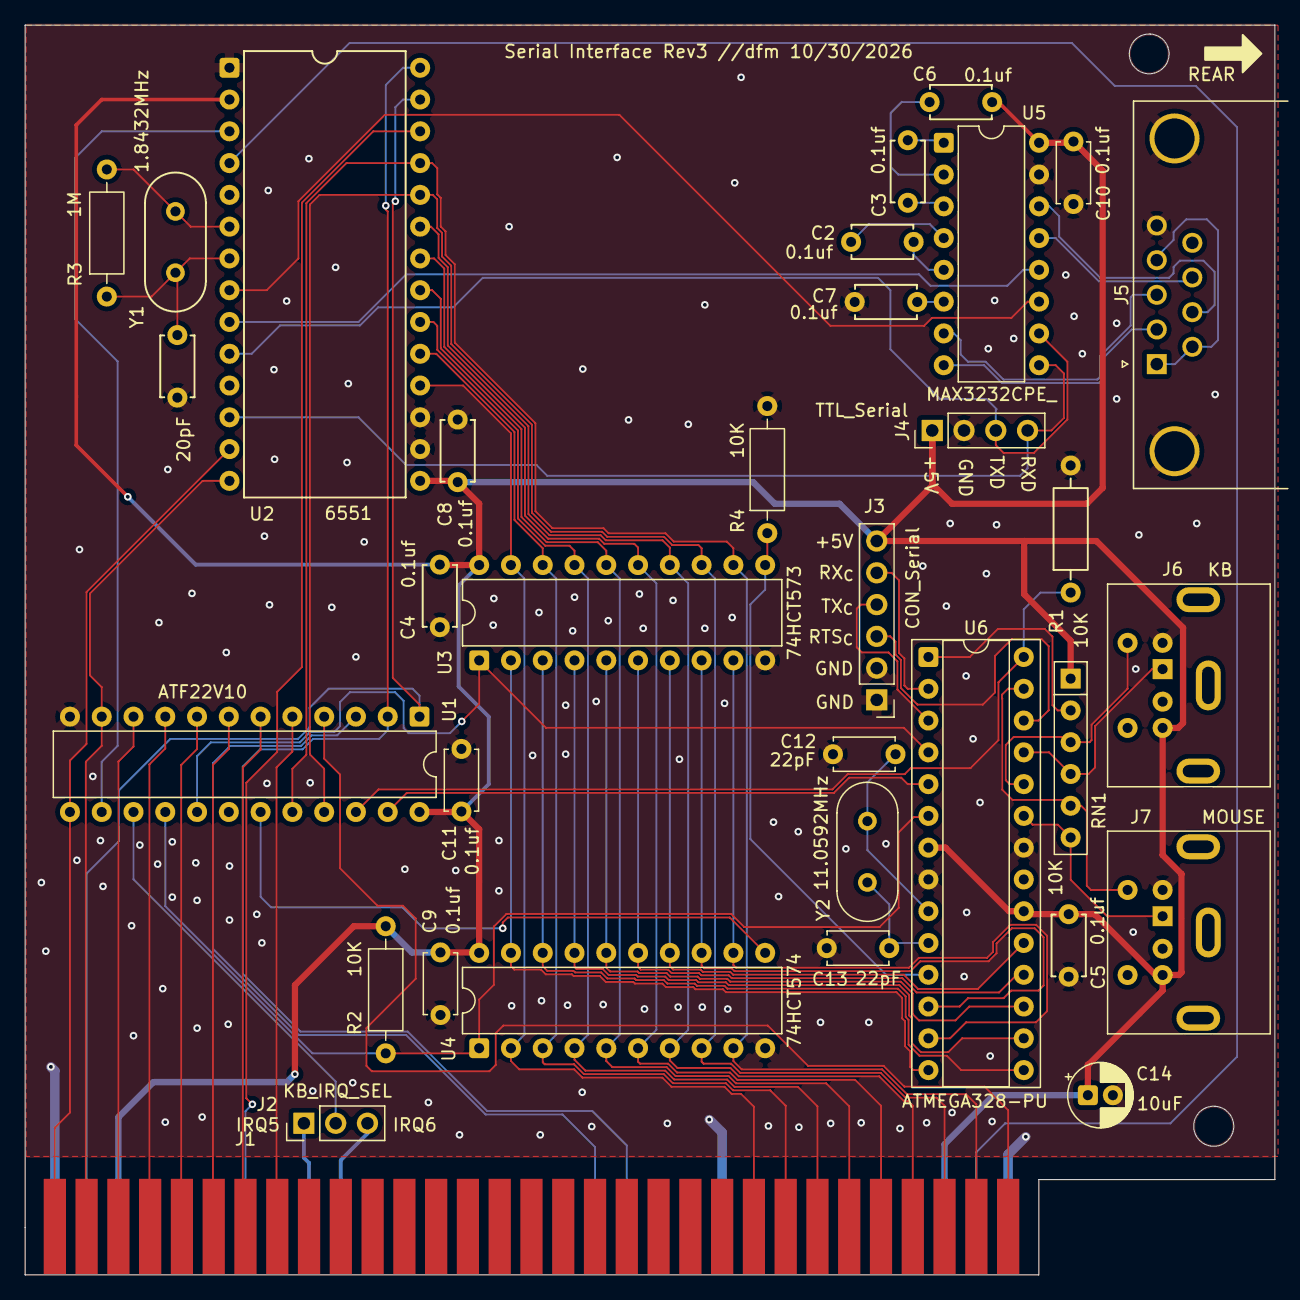
[picture p97: board ISA_6502_Serial_Rev3.kicad_pcb from above]

Board: 2 copper layers, 99.9 x 99.9 mm, 34 parts (0 on the bottom side), 69 nets.
