dfmcwhir/Multi_Architecture_DIY_Computer/Add-On_Cards/ISA_6502_Advanced_IO/ISA_6502_Advanced_IO.kicad_pcb

## KiCad design Add-On_Cards/ISA_6502_Advanced_IO/ISA_6502_Advanced_IO.kicad_pcb (2026-11-05)

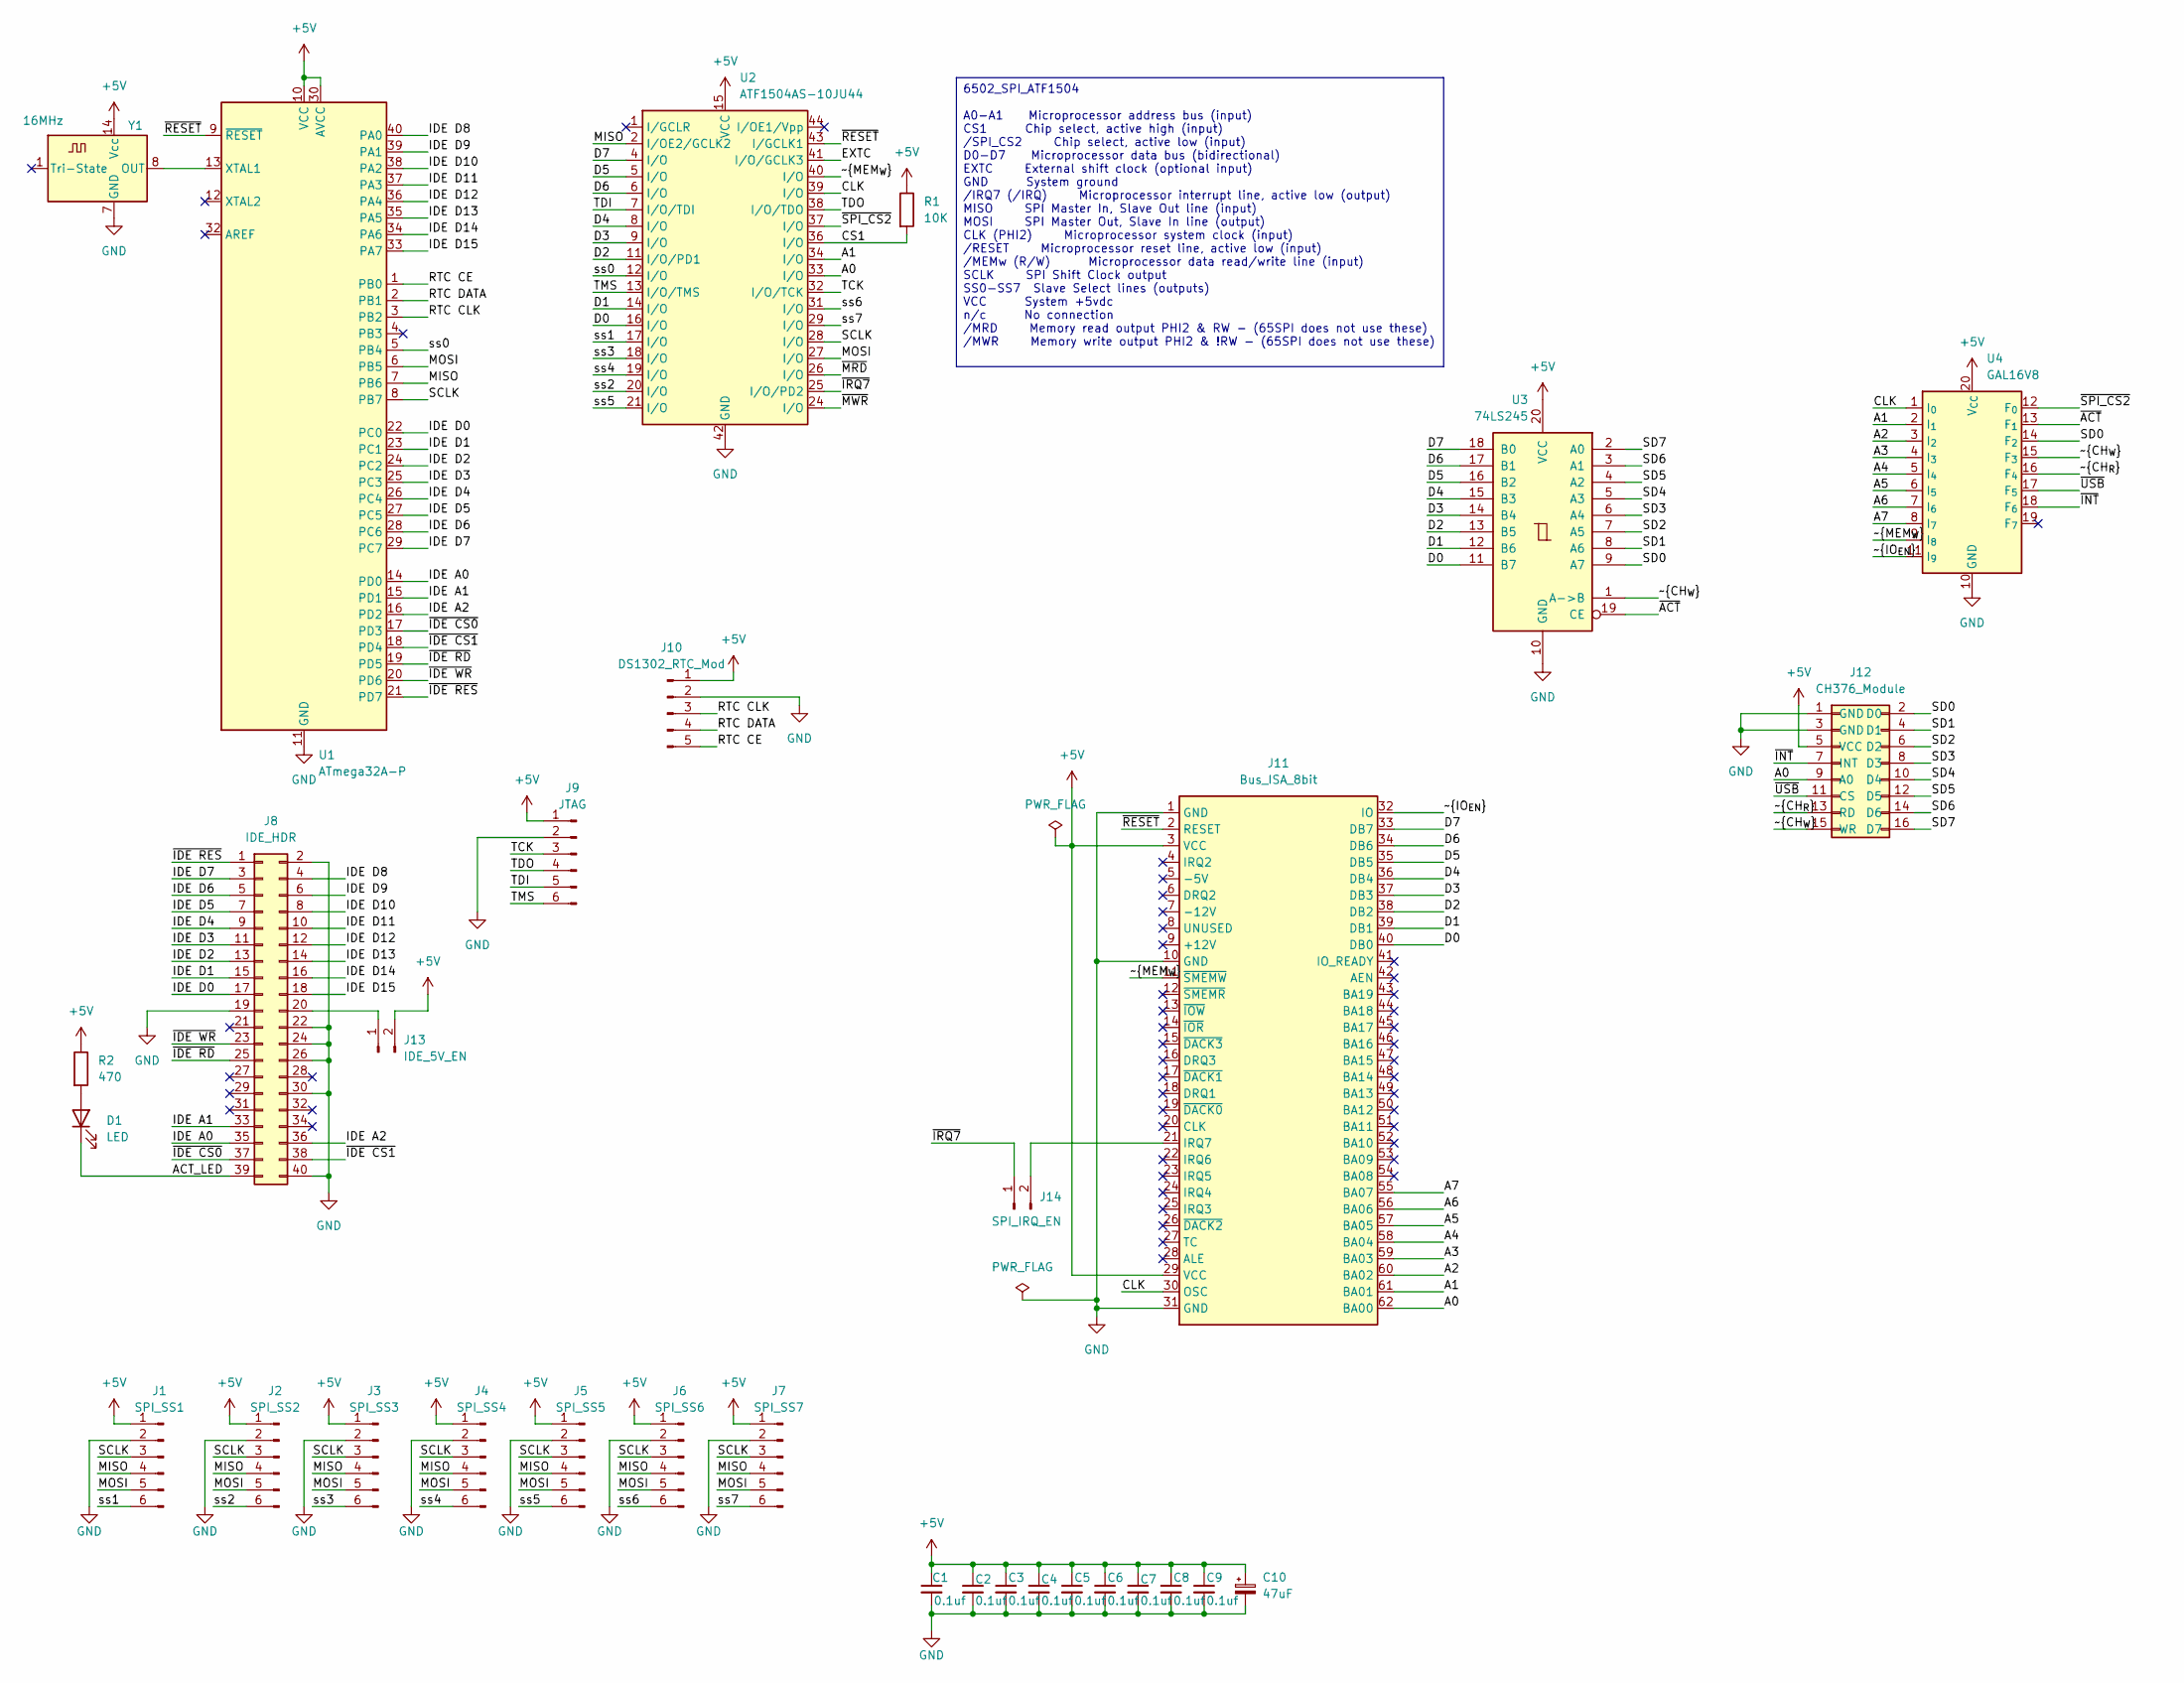
[picture p98: schematic ISA_6502_Advanced_IO.kicad_sch]

Parts:
C1, C2, C3, C4, C5, C6, C7, C8, C9: 0.1uf; C_Disc_D4.7mm_W2.5mm_P5.00mm; Voltage 50V; Tolerance 5%
C10: 47uF; CP_Radial_D5.0mm_P2.00mm
D1: LED; LED_D3.0mm
J1: SPI_SS1; PinHeader_1x06_P2.54mm_Vertical
J2: SPI_SS2; PinHeader_1x06_P2.54mm_Vertical
J3: SPI_SS3; PinHeader_1x06_P2.54mm_Vertical
J4: SPI_SS4; PinHeader_1x06_P2.54mm_Vertical
J5: SPI_SS5; PinHeader_1x06_P2.54mm_Vertical
J6: SPI_SS6; PinHeader_1x06_P2.54mm_Vertical
J7: SPI_SS7; PinHeader_1x06_P2.54mm_Vertical
J8: IDE_HDR; PinHeader_2x20_P2.54mm_Vertical
J9: JTAG; PinHeader_1x06_P2.54mm_Vertical
J10: DS1302_RTC_Mod; DS1302_RTC _module
J11: Bus_ISA_8bit; BUS_8-bit_ISA
J12: CH376_Module
J13: IDE_5V_EN; PinHeader_1x02_P2.54mm_Vertical
J14: SPI_IRQ_EN; PinHeader_1x02_P2.54mm_Vertical
R1: 10K; R_Axial_DIN0207_L6.3mm_D2.5mm_P10.16mm_Horizontal
R2: 470; R_Axial_DIN0207_L6.3mm_D2.5mm_P10.16mm_Horizontal
U1: ATmega32A-P; DIP-40_W15.24mm
U2: ATF1504AS-10JU44; PLCC-44_THT-Socket
U3: 74LS245; DIP-20_W7.62mm
U4: GAL16V8; DIP-20_W7.62mm
Y1: 16MHz; Oscillator_DIP-14

Connections:
+5V: C1.1, C2.1, C3.1, C4.1, C5.1, C6.1, C7.1, C8.1, C9.1, C10.1, J1.1, J2.1, J3.1, J4.1, J5.1, J6.1, J7.1, J9.1, J10.1, J11.3 (VCC), J11.29 (VCC), J12.5 (VCC), J13.2, R1.1, R2.1, U1.10 (VCC), U1.30 (AVCC), U2.3 (VCC), U2.15 (VCC), U2.23 (VCC), U2.35 (VCC), U3.20 (VCC), U4.20 (V_{CC}), Y1.14 (Vcc)
/A0: J11.62 (BA00), J12.9 (A0), U2.33 (I/O)
/A1: J11.61 (BA01), U2.34 (I/O), U4.2 (I_{1})
/A2: J11.60 (BA02), U4.3 (I_{2})
/A3: J11.59 (BA03), U4.4 (I_{3})
/A4: J11.58 (BA04), U4.5 (I_{4})
/A5: J11.57 (BA05), U4.6 (I_{5})
/A6: J11.56 (BA06), U4.7 (I_{6})
/A7: J11.55 (BA07), U4.8 (I_{7})
/ACT_LED: D1.1 (K), J8.39
/CLK: J11.30 (OSC), U2.39 (I/O), U4.1 (I_{0})
/CS1: R1.2, U2.36 (I/O)
/D0: J11.40 (DB0), U2.16 (I/O), U3.11 (B7)
/D1: J11.39 (DB1), U2.14 (I/O), U3.12 (B6)
/D2: J11.38 (DB2), U2.11 (I/O/PD1), U3.13 (B5)
/D3: J11.37 (DB3), U2.9 (I/O), U3.14 (B4)
/D4: J11.36 (DB4), U2.8 (I/O), U3.15 (B3)
/D5: J11.35 (DB5), U2.5 (I/O), U3.16 (B2)
/D6: J11.34 (DB6), U2.6 (I/O), U3.17 (B1)
/D7: J11.33 (DB7), U2.4 (I/O), U3.18 (B0)
/EXTC: U2.41 (I/O/GCLK3)
/IDE A0: J8.35, U1.14 (PD0)
/IDE A1: J8.33, U1.15 (PD1)
/IDE A2: J8.36, U1.16 (PD2)
/IDE D0: J8.17, U1.22 (PC0)
/IDE D1: J8.15, U1.23 (PC1)
/IDE D2: J8.13, U1.24 (PC2)
/IDE D3: J8.11, U1.25 (PC3)
/IDE D4: J8.9, U1.26 (PC4)
/IDE D5: J8.7, U1.27 (PC5)
/IDE D6: J8.5, U1.28 (PC6)
/IDE D7: J8.3, U1.29 (PC7)
/IDE D8: J8.4, U1.40 (PA0)
/IDE D9: J8.6, U1.39 (PA1)
/IDE D10: J8.8, U1.38 (PA2)
/IDE D11: J8.10, U1.37 (PA3)
/IDE D12: J8.12, U1.36 (PA4)
/IDE D13: J8.14, U1.35 (PA5)
/IDE D14: J8.16, U1.34 (PA6)
/IDE D15: J8.18, U1.33 (PA7)
/MISO: J1.4, J2.4, J3.4, J4.4, J5.4, J6.4, J7.4, U1.7 (PB6), U2.2 (I/OE2/GCLK2)
/MOSI: J1.5, J2.5, J3.5, J4.5, J5.5, J6.5, J7.5, U1.6 (PB5), U2.27 (I/O)
/RTC CE: J10.5, U1.1 (PB0)
/RTC CLK: J10.3, U1.3 (PB2)
/RTC DATA: J10.4, U1.2 (PB1)
/SCLK: J1.3, J2.3, J3.3, J4.3, J5.3, J6.3, J7.3, U1.8 (PB7), U2.28 (I/O)
/SD0: J12.2 (D0), U3.9 (A7), U4.14 (F_{2})
/SD1: J12.4 (D1), U3.8 (A6)
/SD2: J12.6 (D2), U3.7 (A5)
/SD3: J12.8 (D3), U3.6 (A4)
/SD4: J12.10 (D4), U3.5 (A3)
/SD5: J12.12 (D5), U3.4 (A2)
/SD6: J12.14 (D6), U3.3 (A1)
/SD7: J12.16 (D7), U3.2 (A0)
/TCK: J9.3, U2.32 (I/O/TCK)
/TDI: J9.5, U2.7 (I/O/TDI)
/TDO: J9.4, U2.38 (I/O/TDO)
/TMS: J9.6, U2.13 (I/O/TMS)
/ss0: U1.5 (PB4), U2.12 (I/O)
/ss1: J1.6, U2.17 (I/O)
/ss2: J2.6, U2.20 (I/O)
/ss3: J3.6, U2.18 (I/O)
/ss4: J4.6, U2.19 (I/O)
/ss5: J5.6, U2.21 (I/O)
/ss6: J6.6, U2.31 (I/O)
/ss7: J7.6, U2.29 (I/O)
/~ACT: U3.19 (CE), U4.13 (F_{1})
/~CH_{R}: J12.13 (RD), U4.16 (F_{4})
/~CH_{W}: J12.15 (WR), U3.1 (A->B), U4.15 (F_{3})
/~IDE CS0: J8.37, U1.17 (PD3)
/~IDE CS1: J8.38, U1.18 (PD4)
/~IDE RD: J8.25, U1.19 (PD5)
/~IDE RES: J8.1, U1.21 (PD7)
/~IDE WR: J8.23, U1.20 (PD6)
/~INT: J12.7 (INT), U4.18 (F_{6})
/~IO_{EN}: J11.32 (IO), U4.11 (I_{9})
/~IRQ7: J14.1, U2.25 (I/O/PD2)
/~MEM_{W}: J11.11 (~SMEMW), U2.40 (I/O), U4.9 (I_{8})
/~MRD: U2.26 (I/O)
/~MWR: U2.24 (I/O)
/~RESET: J11.2 (RESET), U1.9 (~RESET), U2.43 (I/GCLK1)
/~SPI_CS2: U2.37 (I/O), U4.12 (F_{0})
/~USB: J12.11 (CS), U4.17 (F_{5})
GND: C1.2, C2.2, C3.2, C4.2, C5.2, C6.2, C7.2, C8.2, C9.2, C10.2, J1.2, J2.2, J3.2, J4.2, J5.2, J6.2, J7.2, J8.2, J8.19, J8.22, J8.24, J8.26, J8.30, J8.40, J9.2, J10.2, J11.1 (GND), J11.10 (GND), J11.31 (GND), J12.1 (GND), J12.3 (GND), U1.11 (GND), U1.31 (GND), U2.10 (GND), U2.22 (GND), U2.30 (GND), U2.42 (GND), U3.10 (GND), U4.10 (GND), Y1.7 (GND)
unnamed: D1.2 (A), R2.2
unnamed: J11.21 (IRQ7), J14.2
unnamed: J8.20, J13.1
unnamed: U1.13 (XTAL1), Y1.8 (OUT)

Notes on the sheet:
6502_SPI_ATF1504 A0-A1 Microprocessor address bus (input) CS1 Chip select, active high (input) /SPI_CS2 Chip select, active low (input) D0-D7 Microprocessor data bus (bidirectional) EXTC External shift clock (optional input) GND System ground /IRQ7 (/IRQ) Microprocessor interrupt line, active low (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

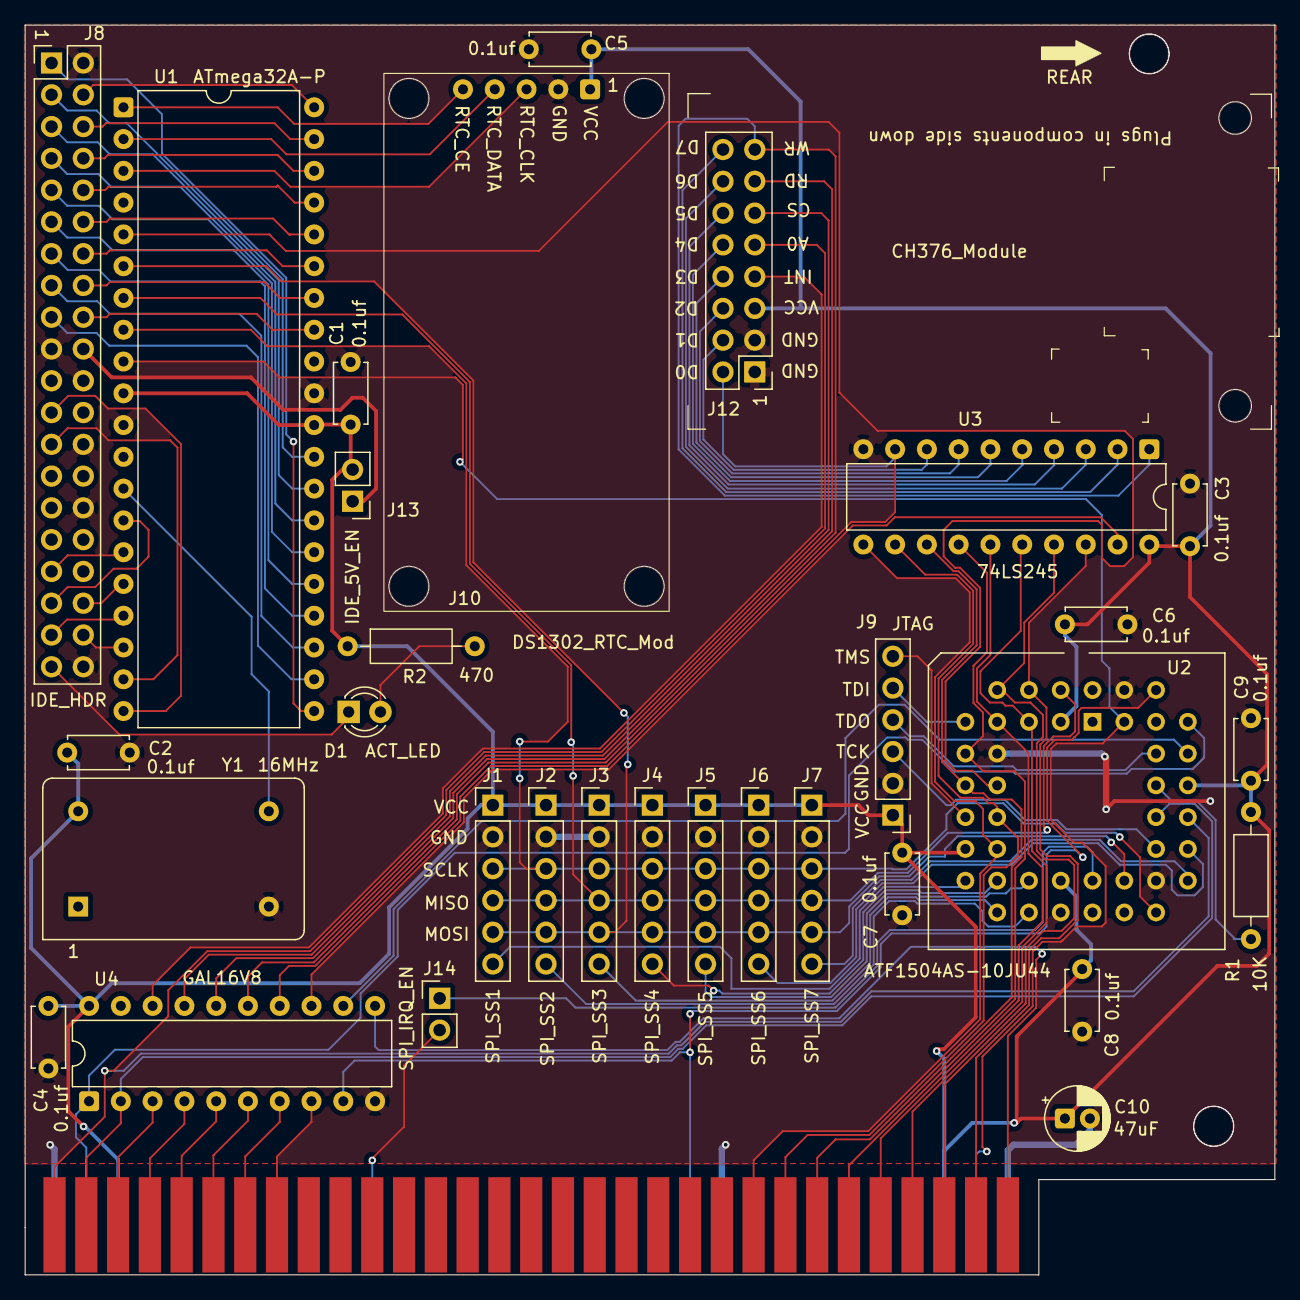
[picture p99: board ISA_6502_Advanced_IO.kicad_pcb from above]

Board: 2 copper layers, 99.9 x 99.9 mm, 32 parts (0 on the bottom side), 85 nets.
