dfmcwhir/Multi_Architecture_DIY_Computer/Add-On_Cards/ISA_6502_Memory/ISA_6502_Memory.kicad_pcb

## KiCad design Add-On_Cards/ISA_6502_Memory/ISA_6502_Memory.kicad_pcb (2026-11-05)

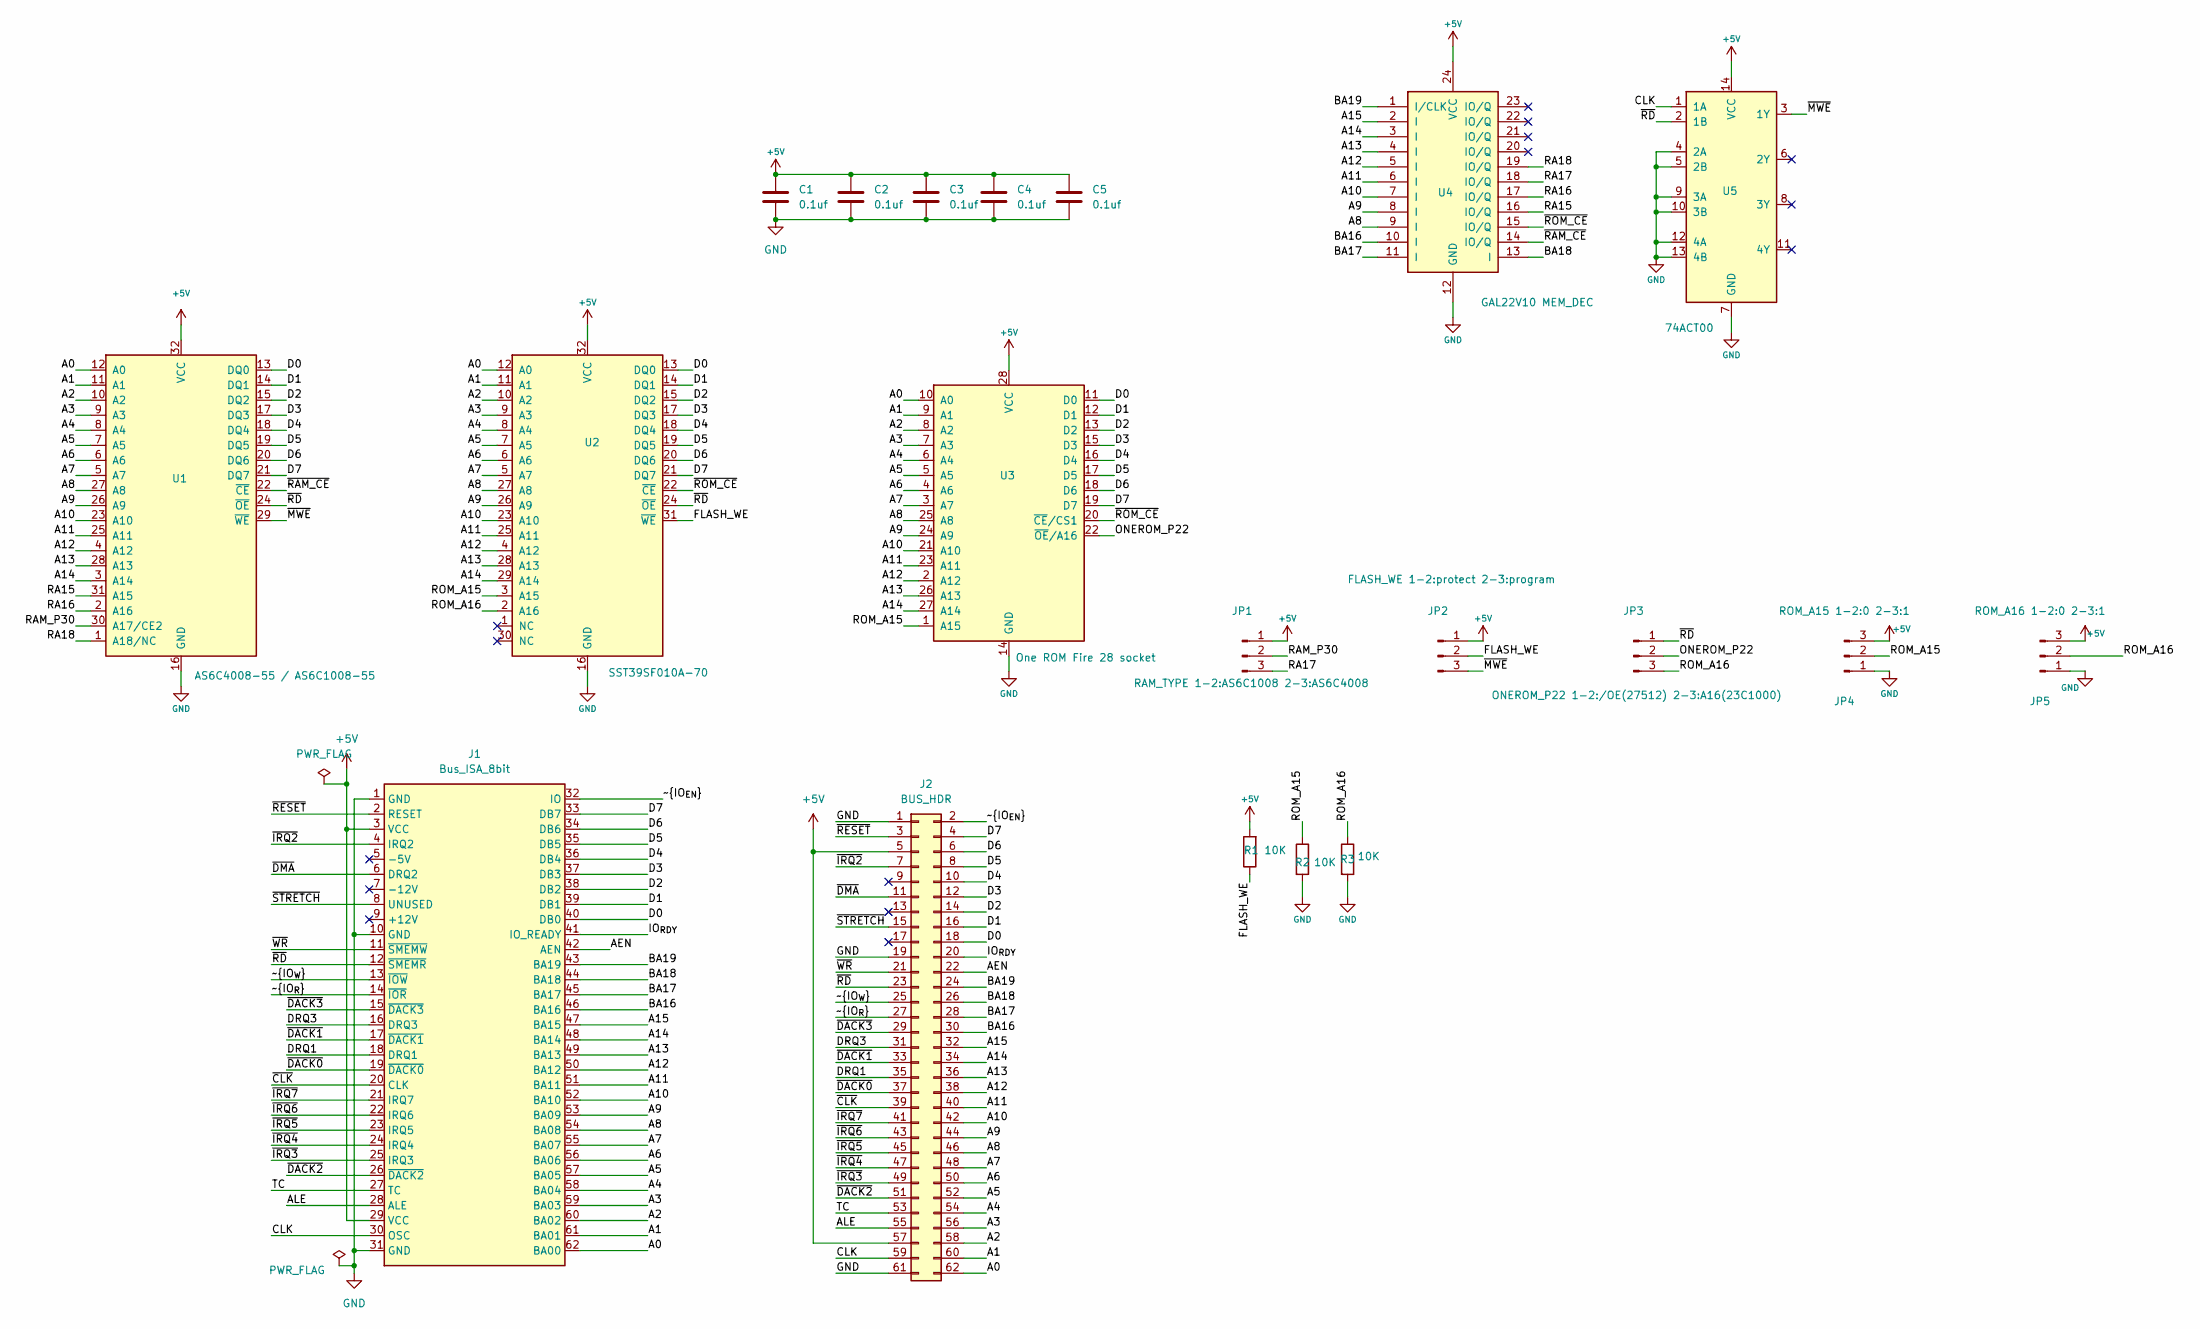
[picture p100: schematic ISA_6502_Memory.kicad_sch]

Parts:
C1, C2, C3, C4, C5: 0.1uf; C_Disc_D4.7mm_W2.5mm_P5.00mm
J1: Bus_ISA_8bit; BUS_8-bit_ISA
J2: BUS_HDR; PinHeader_2x31_P2.54mm_Vertical
JP1: RAM_TYPE 1-2:AS6C1008 2-3:AS6C4008; PinHeader_1x03_P2.54mm_Vertical
JP2: FLASH_WE 1-2:protect 2-3:program; PinHeader_1x03_P2.54mm_Vertical
JP3: ONEROM_P22 1-2:/OE(27512) 2-3:A16(23C1000); PinHeader_1x03_P2.54mm_Vertical
JP4: ROM_A15 1-2:0 2-3:1; PinHeader_1x03_P2.54mm_Vertical
JP5: ROM_A16 1-2:0 2-3:1; PinHeader_1x03_P2.54mm_Vertical
R1, R2, R3: 10K; R_Axial_DIN0207_L6.3mm_D2.5mm_P10.16mm_Horizontal
U1: AS6C4008-55 / AS6C1008-55; DIP-32_W15.24mm_Socket
U2: SST39SF010A-70; DIP-32_W15.24mm_Socket
U3: One ROM Fire 28 socket; DIP-28_W15.24mm_Socket
U4: GAL22V10 MEM_DEC; DIP-24_W7.62mm
U5: 74ACT00; DIP-14_W7.62mm

Connections:
+5V: C1.1, C2.1, C3.1, C4.1, C5.1, J1.3 (VCC), J1.29 (VCC), J2.5, J2.57, JP1.1, JP2.1, JP4.3, JP5.3, R1.2, U1.32 (VCC), U2.32 (VCC), U3.28 (VCC), U4.24 (VCC), U5.14 (VCC)
/A0: J1.62 (BA00), J2.62, U1.12 (A0), U2.12 (A0), U3.10 (A0)
/A1: J1.61 (BA01), J2.60, U1.11 (A1), U2.11 (A1), U3.9 (A1)
/A2: J1.60 (BA02), J2.58, U1.10 (A2), U2.10 (A2), U3.8 (A2)
/A3: J1.59 (BA03), J2.56, U1.9 (A3), U2.9 (A3), U3.7 (A3)
/A4: J1.58 (BA04), J2.54, U1.8 (A4), U2.8 (A4), U3.6 (A4)
/A5: J1.57 (BA05), J2.52, U1.7 (A5), U2.7 (A5), U3.5 (A5)
/A6: J1.56 (BA06), J2.50, U1.6 (A6), U2.6 (A6), U3.4 (A6)
/A7: J1.55 (BA07), J2.48, U1.5 (A7), U2.5 (A7), U3.3 (A7)
/A8: J1.54 (BA08), J2.46, U1.27 (A8), U2.27 (A8), U3.25 (A8), U4.9 (I)
/A9: J1.53 (BA09), J2.44, U1.26 (A9), U2.26 (A9), U3.24 (A9), U4.8 (I)
/A10: J1.52 (BA10), J2.42, U1.23 (A10), U2.23 (A10), U3.21 (A10), U4.7 (I)
/A11: J1.51 (BA11), J2.40, U1.25 (A11), U2.25 (A11), U3.23 (A11), U4.6 (I)
/A12: J1.50 (BA12), J2.38, U1.4 (A12), U2.4 (A12), U3.2 (A12), U4.5 (I)
/A13: J1.49 (BA13), J2.36, U1.28 (A13), U2.28 (A13), U3.26 (A13), U4.4 (I)
/A14: J1.48 (BA14), J2.34, U1.3 (A14), U2.29 (A14), U3.27 (A14), U4.3 (I)
/A15: J1.47 (BA15), J2.32, U4.2 (I)
/AEN: J1.42 (AEN), J2.22
/ALE: J1.28 (ALE), J2.55
/BA16: J1.46 (BA16), J2.30, U4.10 (I)
/BA17: J1.45 (BA17), J2.28, U4.11 (I)
/BA18: J1.44 (BA18), J2.26, U4.13 (I)
/BA19: J1.43 (BA19), J2.24, U4.1 (I/CLK)
/CLK: J1.30 (OSC), J2.59, U5.1 (1A)
/D0: J1.40 (DB0), J2.18, U1.13 (DQ0), U2.13 (DQ0), U3.11 (D0)
/D1: J1.39 (DB1), J2.16, U1.14 (DQ1), U2.14 (DQ1), U3.12 (D1)
/D2: J1.38 (DB2), J2.14, U1.15 (DQ2), U2.15 (DQ2), U3.13 (D2)
/D3: J1.37 (DB3), J2.12, U1.17 (DQ3), U2.17 (DQ3), U3.15 (D3)
/D4: J1.36 (DB4), J2.10, U1.18 (DQ4), U2.18 (DQ4), U3.16 (D4)
/D5: J1.35 (DB5), J2.8, U1.19 (DQ5), U2.19 (DQ5), U3.17 (D5)
/D6: J1.34 (DB6), J2.6, U1.20 (DQ6), U2.20 (DQ6), U3.18 (D6)
/D7: J1.33 (DB7), J2.4, U1.21 (DQ7), U2.21 (DQ7), U3.19 (D7)
/DRQ1: J1.18 (DRQ1), J2.35
/DRQ3: J1.16 (DRQ3), J2.31
/FLASH_WE: JP2.2, R1.1, U2.31 (~WE)
/IO_{RDY}: J1.41 (IO_READY), J2.20
/ONEROM_P22: JP3.2, U3.22 (~OE/A16)
/RA15: U1.31 (A15), U4.16 (IO/Q)
/RA16: U1.2 (A16), U4.17 (IO/Q)
/RA17: JP1.3, U4.18 (IO/Q)
/RA18: U1.1 (A18/NC), U4.19 (IO/Q)
/RAM_P30: JP1.2, U1.30 (A17/CE2)
/ROM_A15: JP4.2, R2.1, U2.3 (A15), U3.1 (A15)
/ROM_A16: JP3.3, JP5.2, R3.1, U2.2 (A16)
/TC: J1.27 (TC), J2.53
/~CLK: J1.20 (CLK), J2.39
/~DACK0: J1.19 (~DACK0), J2.37
/~DACK1: J1.17 (~DACK1), J2.33
/~DACK2: J1.26 (~DACK2), J2.51
/~DACK3: J1.15 (~DACK3), J2.29
/~DMA: J1.6 (DRQ2), J2.11
/~IO_{EN}: J1.32 (IO), J2.2
/~IO_{R}: J1.14 (~IOR), J2.27
/~IO_{W}: J1.13 (~IOW), J2.25
/~IRQ2: J1.4 (IRQ2), J2.7
/~IRQ3: J1.25 (IRQ3), J2.49
/~IRQ4: J1.24 (IRQ4), J2.47
/~IRQ5: J1.23 (IRQ5), J2.45
/~IRQ6: J1.22 (IRQ6), J2.43
/~IRQ7: J1.21 (IRQ7), J2.41
/~MWE: JP2.3, U1.29 (~WE), U5.3 (1Y)
/~RAM_CE: U1.22 (~CE), U4.14 (IO/Q)
/~RD: J1.12 (~SMEMR), J2.23, JP3.1, U1.24 (~OE), U2.24 (~OE), U5.2 (1B)
/~RESET: J1.2 (RESET), J2.3
/~ROM_CE: U2.22 (~CE), U3.20 (~CE/CS1), U4.15 (IO/Q)
/~STRETCH: J1.8 (UNUSED), J2.15
/~WR: J1.11 (~SMEMW), J2.21
GND: C1.2, C2.2, C3.2, C4.2, C5.2, J1.1 (GND), J1.10 (GND), J1.31 (GND), J2.1, J2.19, J2.61, JP4.1, JP5.1, R2.2, R3.2, U1.16 (GND), U2.16 (GND), U3.14 (GND), U4.12 (GND), U5.4 (2A), U5.5 (2B), U5.7 (GND), U5.9 (3A), U5.10 (3B), U5.12 (4A), U5.13 (4B)
