dfmcwhir/Multi_Architecture_DIY_Computer/Add-On_Cards/ISA_6502_Memory/ISA_6502_Memory.kicad_pcb

## KiCad design Add-On_Cards/ISA_6502_Memory/ISA_6502_Memory.kicad_pcb (continued)

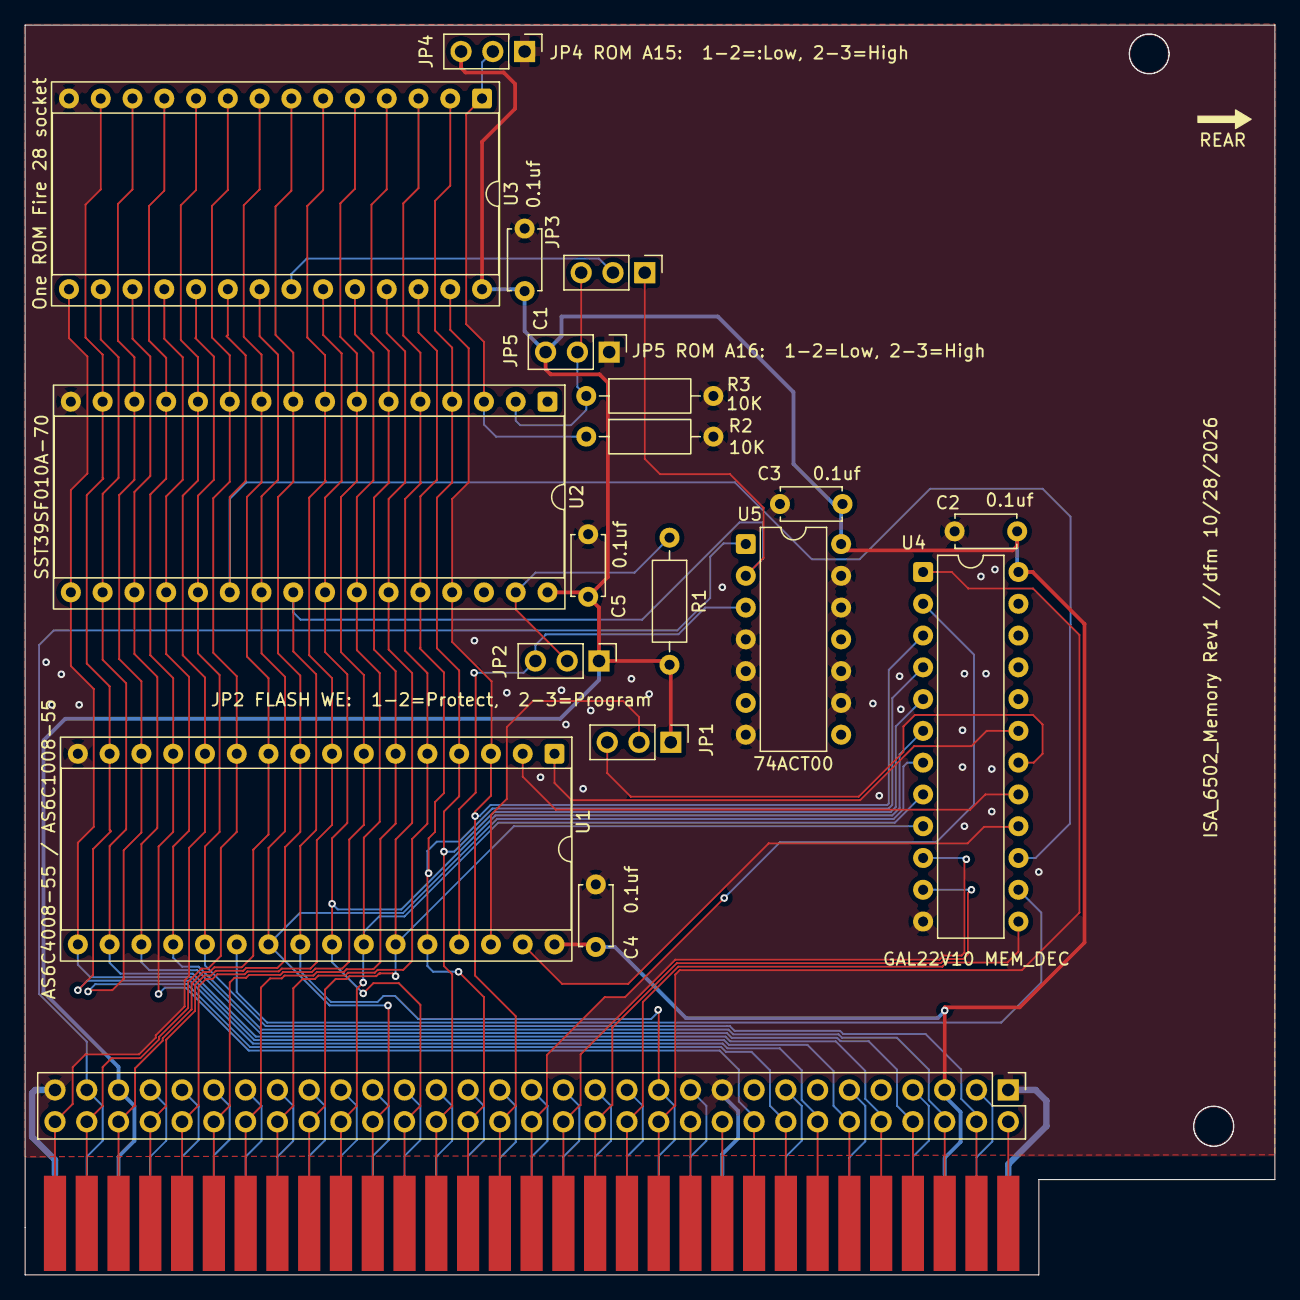
[picture p101: board ISA_6502_Memory.kicad_pcb from above]

Board: 2 copper layers, 99.9 x 99.9 mm, 20 parts (0 on the bottom side), 68 nets.
