dfmcwhir/Multi_Architecture_DIY_Computer/Add-On_Cards/CH376_USB_CARD/CH375_USB_ISA_Card_W_DOC.kicad_pcb

## KiCad design Add-On_Cards/CH376_USB_CARD/CH375_USB_ISA_Card_W_DOC.kicad_pcb (2026-11-05)

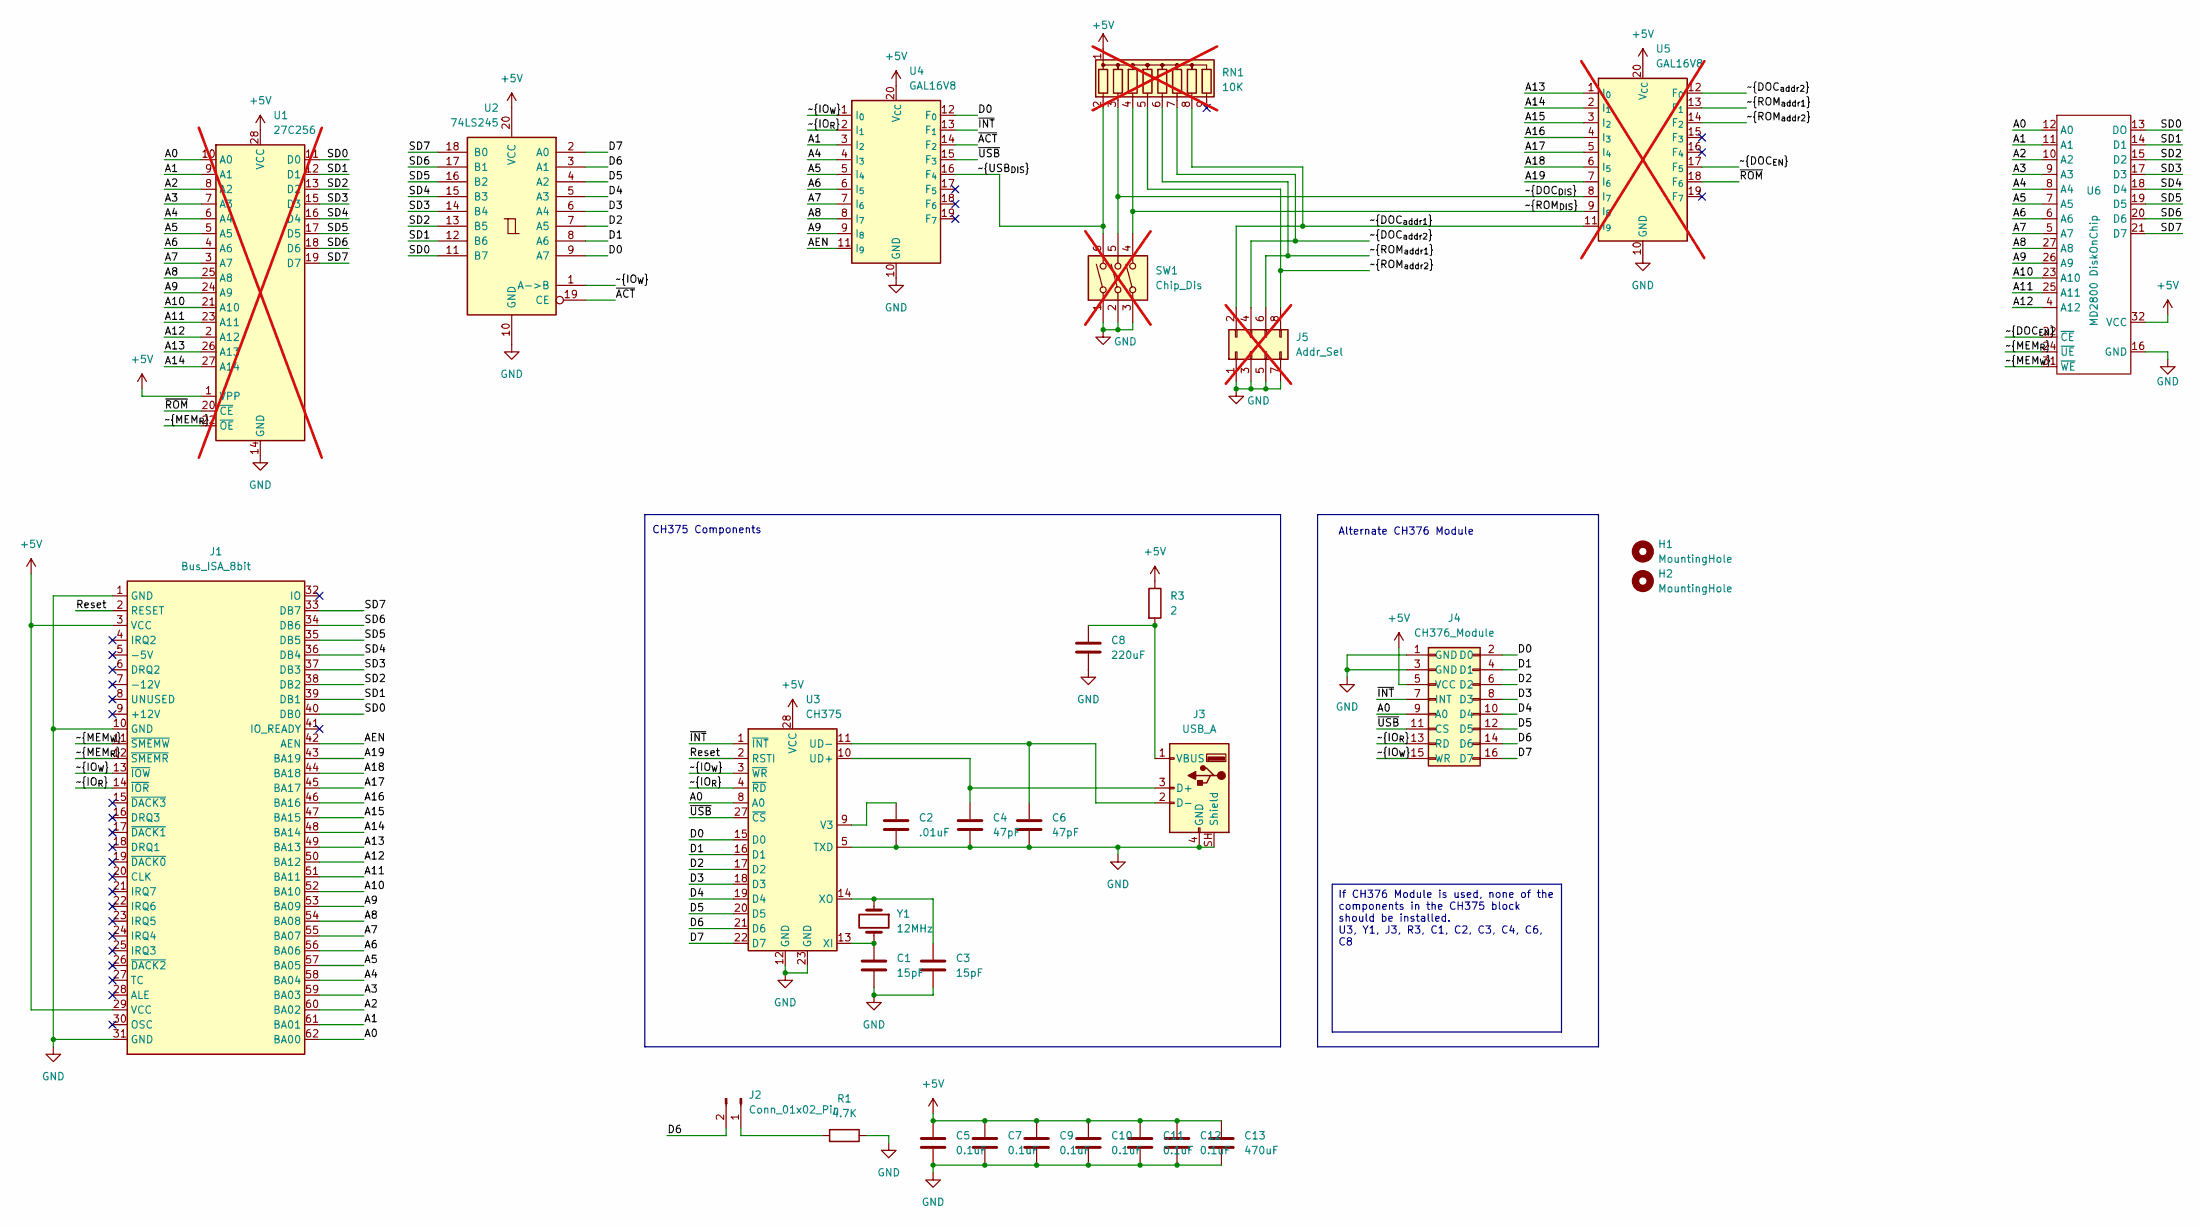
[picture p102: schematic CH375_USB_ISA_Card_W_DOC.kicad_sch]

Parts:
C1, C3: 15pF; C_Disc_D4.7mm_W2.5mm_P5.00mm
C2: .01uF; C_Disc_D4.7mm_W2.5mm_P5.00mm
C4, C6: 47pF; C_Disc_D4.7mm_W2.5mm_P5.00mm
C5, C7, C9, C10, C11, C12: 0.1uF; C_Disc_D4.7mm_W2.5mm_P5.00mm
C8: 220uF; CP_Radial_D6.3mm_P2.50mm
C13: 470uF; CP_Radial_D6.3mm_P2.50mm
H1, H2: MountingHole; MountingHole_3.2mm_M3
J1: Bus_ISA_8bit; BUS_8-bit_ISA
J2: Conn_01x02_Pin; PinHeader_1x02_P2.54mm_Vertical
J3: USB_A; USB_A_Connfly_DS1095
J4: CH376_Module
J5: Addr_Sel; PinHeader_2x04_P2.54mm_Vertical; not fitted
R1: 4.7K; R_Axial_DIN0207_L6.3mm_D2.5mm_P10.16mm_Horizontal
R3: 2; R_Axial_DIN0207_L6.3mm_D2.5mm_P10.16mm_Horizontal
RN1: 10K; R_Array_SIP9; not fitted
SW1: Chip_Dis; DIP-6_W7.62mm; not fitted
U1: 27C256; DIP-28_W15.24mm; not fitted
U2: 74LS245; DIP-20_W7.62mm
U3: CH375; SOP-28_8.4x18.16mm_P1.27mm
U4: GAL16V8; DIP-20_W7.62mm
U5: GAL16V8; DIP-20_W7.62mm; not fitted
U6: MD2800 DiskOnChip; DIP-32_W15.24mm
Y1: 12MHz; Crystal_HC18-U_Vertical

Connections:
+5V: C5.1, C7.1, C9.1, C10.1, C11.1, C12.1, C13.1, J1.3 (VCC), J1.29 (VCC), J4.5 (VCC), R3.1, RN1.1 (common), U1.1 (VPP), U1.28 (VCC), U2.20 (VCC), U3.28 (VCC), U4.20 (V_{CC}), U5.20 (V_{CC}), U6.32 (VCC)
/A0: J1.62 (BA00), J4.9 (A0), U1.10 (A0), U3.8 (A0), U6.12 (A0)
/A1: J1.61 (BA01), U1.9 (A1), U4.3 (I_{2}), U6.11 (A1)
/A2: J1.60 (BA02), U1.8 (A2), U6.10 (A2)
/A3: J1.59 (BA03), U1.7 (A3), U6.9 (A3)
/A4: J1.58 (BA04), U1.6 (A4), U4.4 (I_{3}), U6.8 (A4)
/A5: J1.57 (BA05), U1.5 (A5), U4.5 (I_{4}), U6.7 (A5)
/A6: J1.56 (BA06), U1.4 (A6), U4.6 (I_{5}), U6.6 (A6)
/A7: J1.55 (BA07), U1.3 (A7), U4.7 (I_{6}), U6.5 (A7)
/A8: J1.54 (BA08), U1.25 (A8), U4.8 (I_{7}), U6.27 (A8)
/A9: J1.53 (BA09), U1.24 (A9), U4.9 (I_{8}), U6.26 (A9)
/A10: J1.52 (BA10), U1.21 (A10), U6.23 (A10)
/A11: J1.51 (BA11), U1.23 (A11), U6.25 (A11)
/A12: J1.50 (BA12), U1.2 (A12), U6.4 (A12)
/A13: J1.49 (BA13), U1.26 (A13), U5.1 (I_{0})
/A14: J1.48 (BA14), U1.27 (A14), U5.2 (I_{1})
/A15: J1.47 (BA15), U5.3 (I_{2})
/A16: J1.46 (BA16), U5.4 (I_{3})
/A17: J1.45 (BA17), U5.5 (I_{4})
/A18: J1.44 (BA18), U5.6 (I_{5})
/A19: J1.43 (BA19), U5.7 (I_{6})
/AEN: J1.42 (AEN), U4.11 (I_{9})
/D0: J4.2 (D0), U2.9 (A7), U3.15 (D0), U4.12 (F_{0})
/D1: J4.4 (D1), U2.8 (A6), U3.16 (D1)
/D2: J4.6 (D2), U2.7 (A5), U3.17 (D2)
/D3: J4.8 (D3), U2.6 (A4), U3.18 (D3)
/D4: J4.10 (D4), U2.5 (A3), U3.19 (D4)
/D5: J4.12 (D5), U2.4 (A2), U3.20 (D5)
/D6: J2.2, J4.14 (D6), U2.3 (A1), U3.21 (D6)
/D7: J4.16 (D7), U2.2 (A0), U3.22 (D7)
/Reset: J1.2 (RESET), U3.2 (RSTI)
/SD0: J1.40 (DB0), U1.11 (D0), U2.11 (B7), U6.13 (DO)
/SD1: J1.39 (DB1), U1.12 (D1), U2.12 (B6), U6.14 (D1)
/SD2: J1.38 (DB2), U1.13 (D2), U2.13 (B5), U6.15 (D2)
/SD3: J1.37 (DB3), U1.15 (D3), U2.14 (B4), U6.17 (D3)
/SD4: J1.36 (DB4), U1.16 (D4), U2.15 (B3), U6.18 (D4)
/SD5: J1.35 (DB5), U1.17 (D5), U2.16 (B2), U6.19 (D5)
/SD6: J1.34 (DB6), U1.18 (D6), U2.17 (B1), U6.20 (D6)
/SD7: J1.33 (DB7), U1.19 (D7), U2.18 (B0), U6.21 (D7)
/~ACT: U2.19 (CE), U4.14 (F_{2})
/~DOC_{DIS}: RN1.3 (R2), SW1.5, U5.8 (I_{7})
/~DOC_{EN}: U5.17 (F_{5}), U6.22 (~CE)
/~DOC_{addr1}: J5.2, RN1.8 (R7), U5.11 (I_{9})
/~DOC_{addr2}: J5.4, RN1.7 (R6), U5.12 (F_{0})
/~INT: J4.7 (INT), U3.1 (~INT), U4.13 (F_{1})
/~IO_{R}: J1.14 (~IOR), J4.13 (RD), U3.4 (~RD), U4.2 (I_{1})
/~IO_{W}: J1.13 (~IOW), J4.15 (WR), U2.1 (A->B), U3.3 (~WR), U4.1 (I_{0})
/~MEM_{R}: J1.12 (~SMEMR), U1.22 (~OE), U6.24 (~UE)
/~MEM_{W}: J1.11 (~SMEMW), U6.31 (~WE)
/~ROM_{DIS}: RN1.4 (R3), SW1.4, U5.9 (I_{8})
/~ROM_{addr1}: J5.6, RN1.6 (R5), U5.13 (F_{1})
/~ROM_{addr2}: J5.8, RN1.5 (R4), U5.14 (F_{2})
/~ROM: U1.20 (~CE), U5.18 (F_{6})
/~USB_{DIS}: RN1.2 (R1), SW1.6, U4.16 (F_{4})
/~USB: J4.11 (CS), U3.27 (~CS), U4.15 (F_{3})
GND: C1.2, C2.2, C3.2, C4.2, C5.2, C6.2, C7.2, C8.2, C9.2, C10.2, C11.2, C12.2, C13.2, J1.1 (GND), J1.10 (GND), J1.31 (GND), J3.4 (GND), J3.SH (Shield), J4.1 (GND), J4.3 (GND), J5.1, J5.3, J5.5, J5.7, R1.1, SW1.1, SW1.2, SW1.3, U1.14 (GND), U2.10 (GND), U3.5 (TXD), U3.12 (GND), U3.23 (GND), U4.10 (GND), U5.10 (GND), U6.16 (GND)
unnamed: J2.1, R1.2
unnamed: C4.1, J3.3 (D+), U3.10 (UD+)
unnamed: C6.1, J3.2 (D-), U3.11 (UD-)
unnamed: C8.1, J3.1 (VBUS), R3.2
unnamed: C2.1, U3.9 (V3)
unnamed: C1.1, U3.13 (XI), Y1.2
unnamed: C3.1, U3.14 (XO), Y1.1

Notes on the sheet:
CH375 Components
Alternate CH376 Module
If CH376 Module is used, none of the components in the CH375 block should be installed. U3, Y1, J3, R3, C1, C2, C3, C4, C6, C8

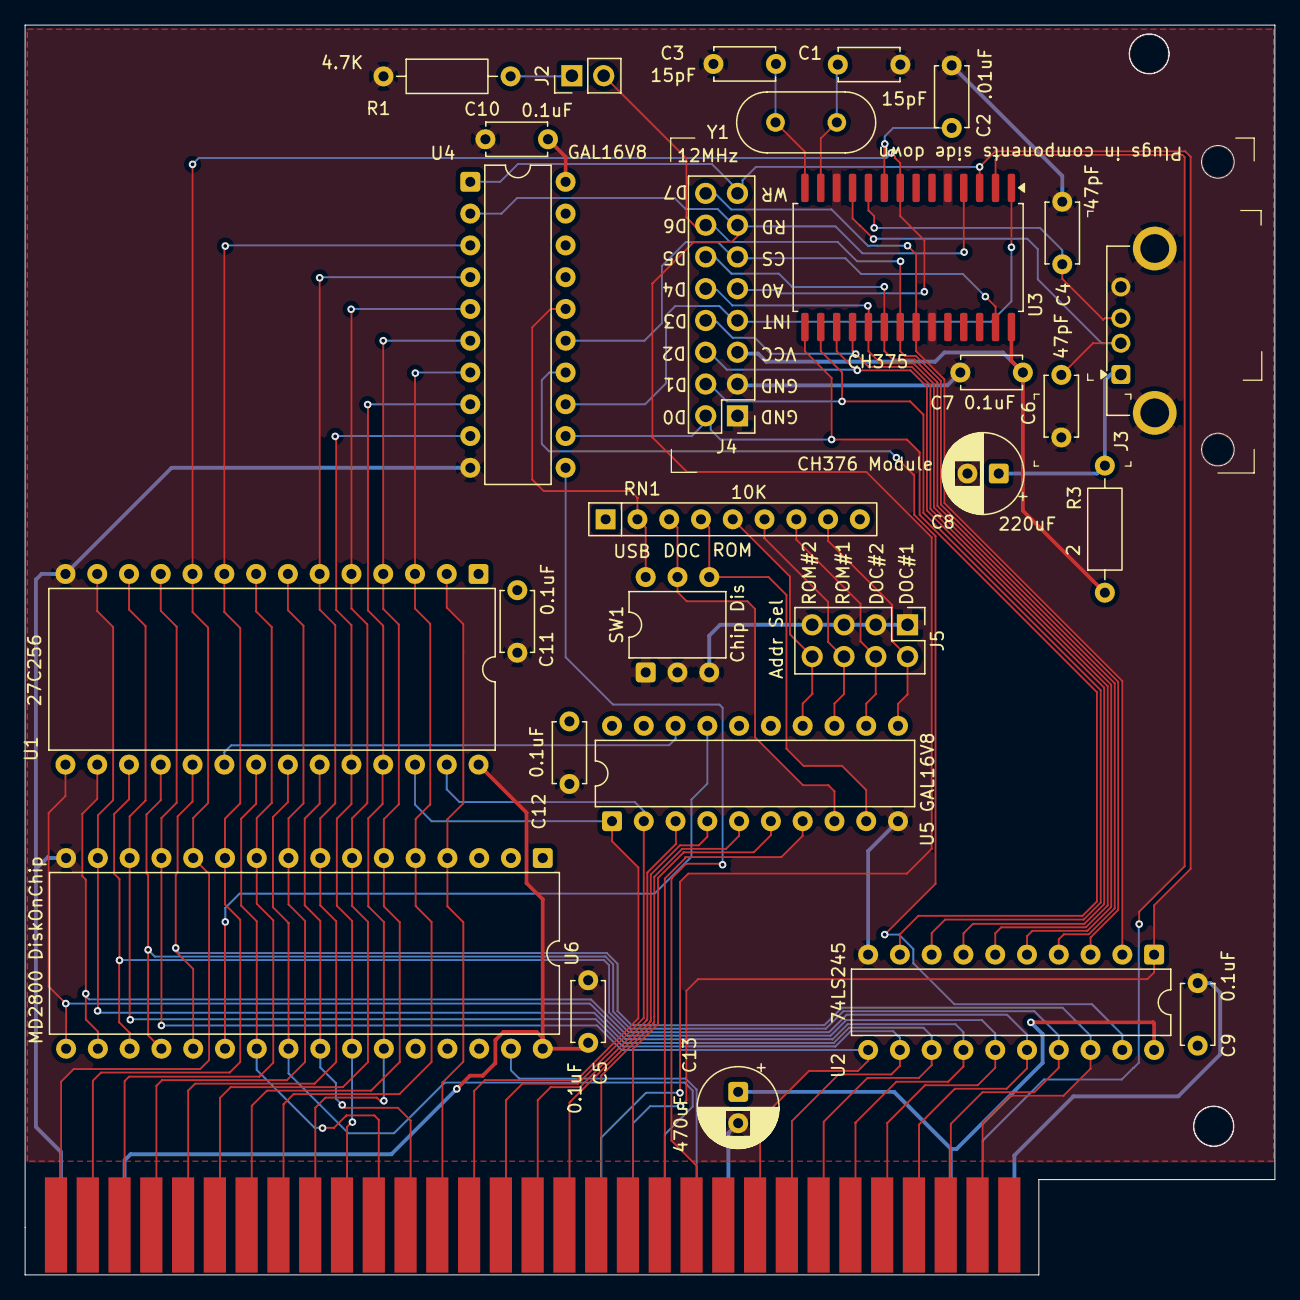
[picture p103: board CH375_USB_ISA_Card_W_DOC.kicad_pcb from above]

Board: 2 copper layers, 99.9 x 99.9 mm, 29 parts (0 on the bottom side), 63 nets.
