dfmcwhir/Multi_Architecture_DIY_Computer/ISA_6502/ISA_6502_CPU/ISA_6502_CPU.kicad_pcb

## KiCad design ISA_6502/ISA_6502_CPU/ISA_6502_CPU.kicad_pcb (2026-11-05, an earlier design)

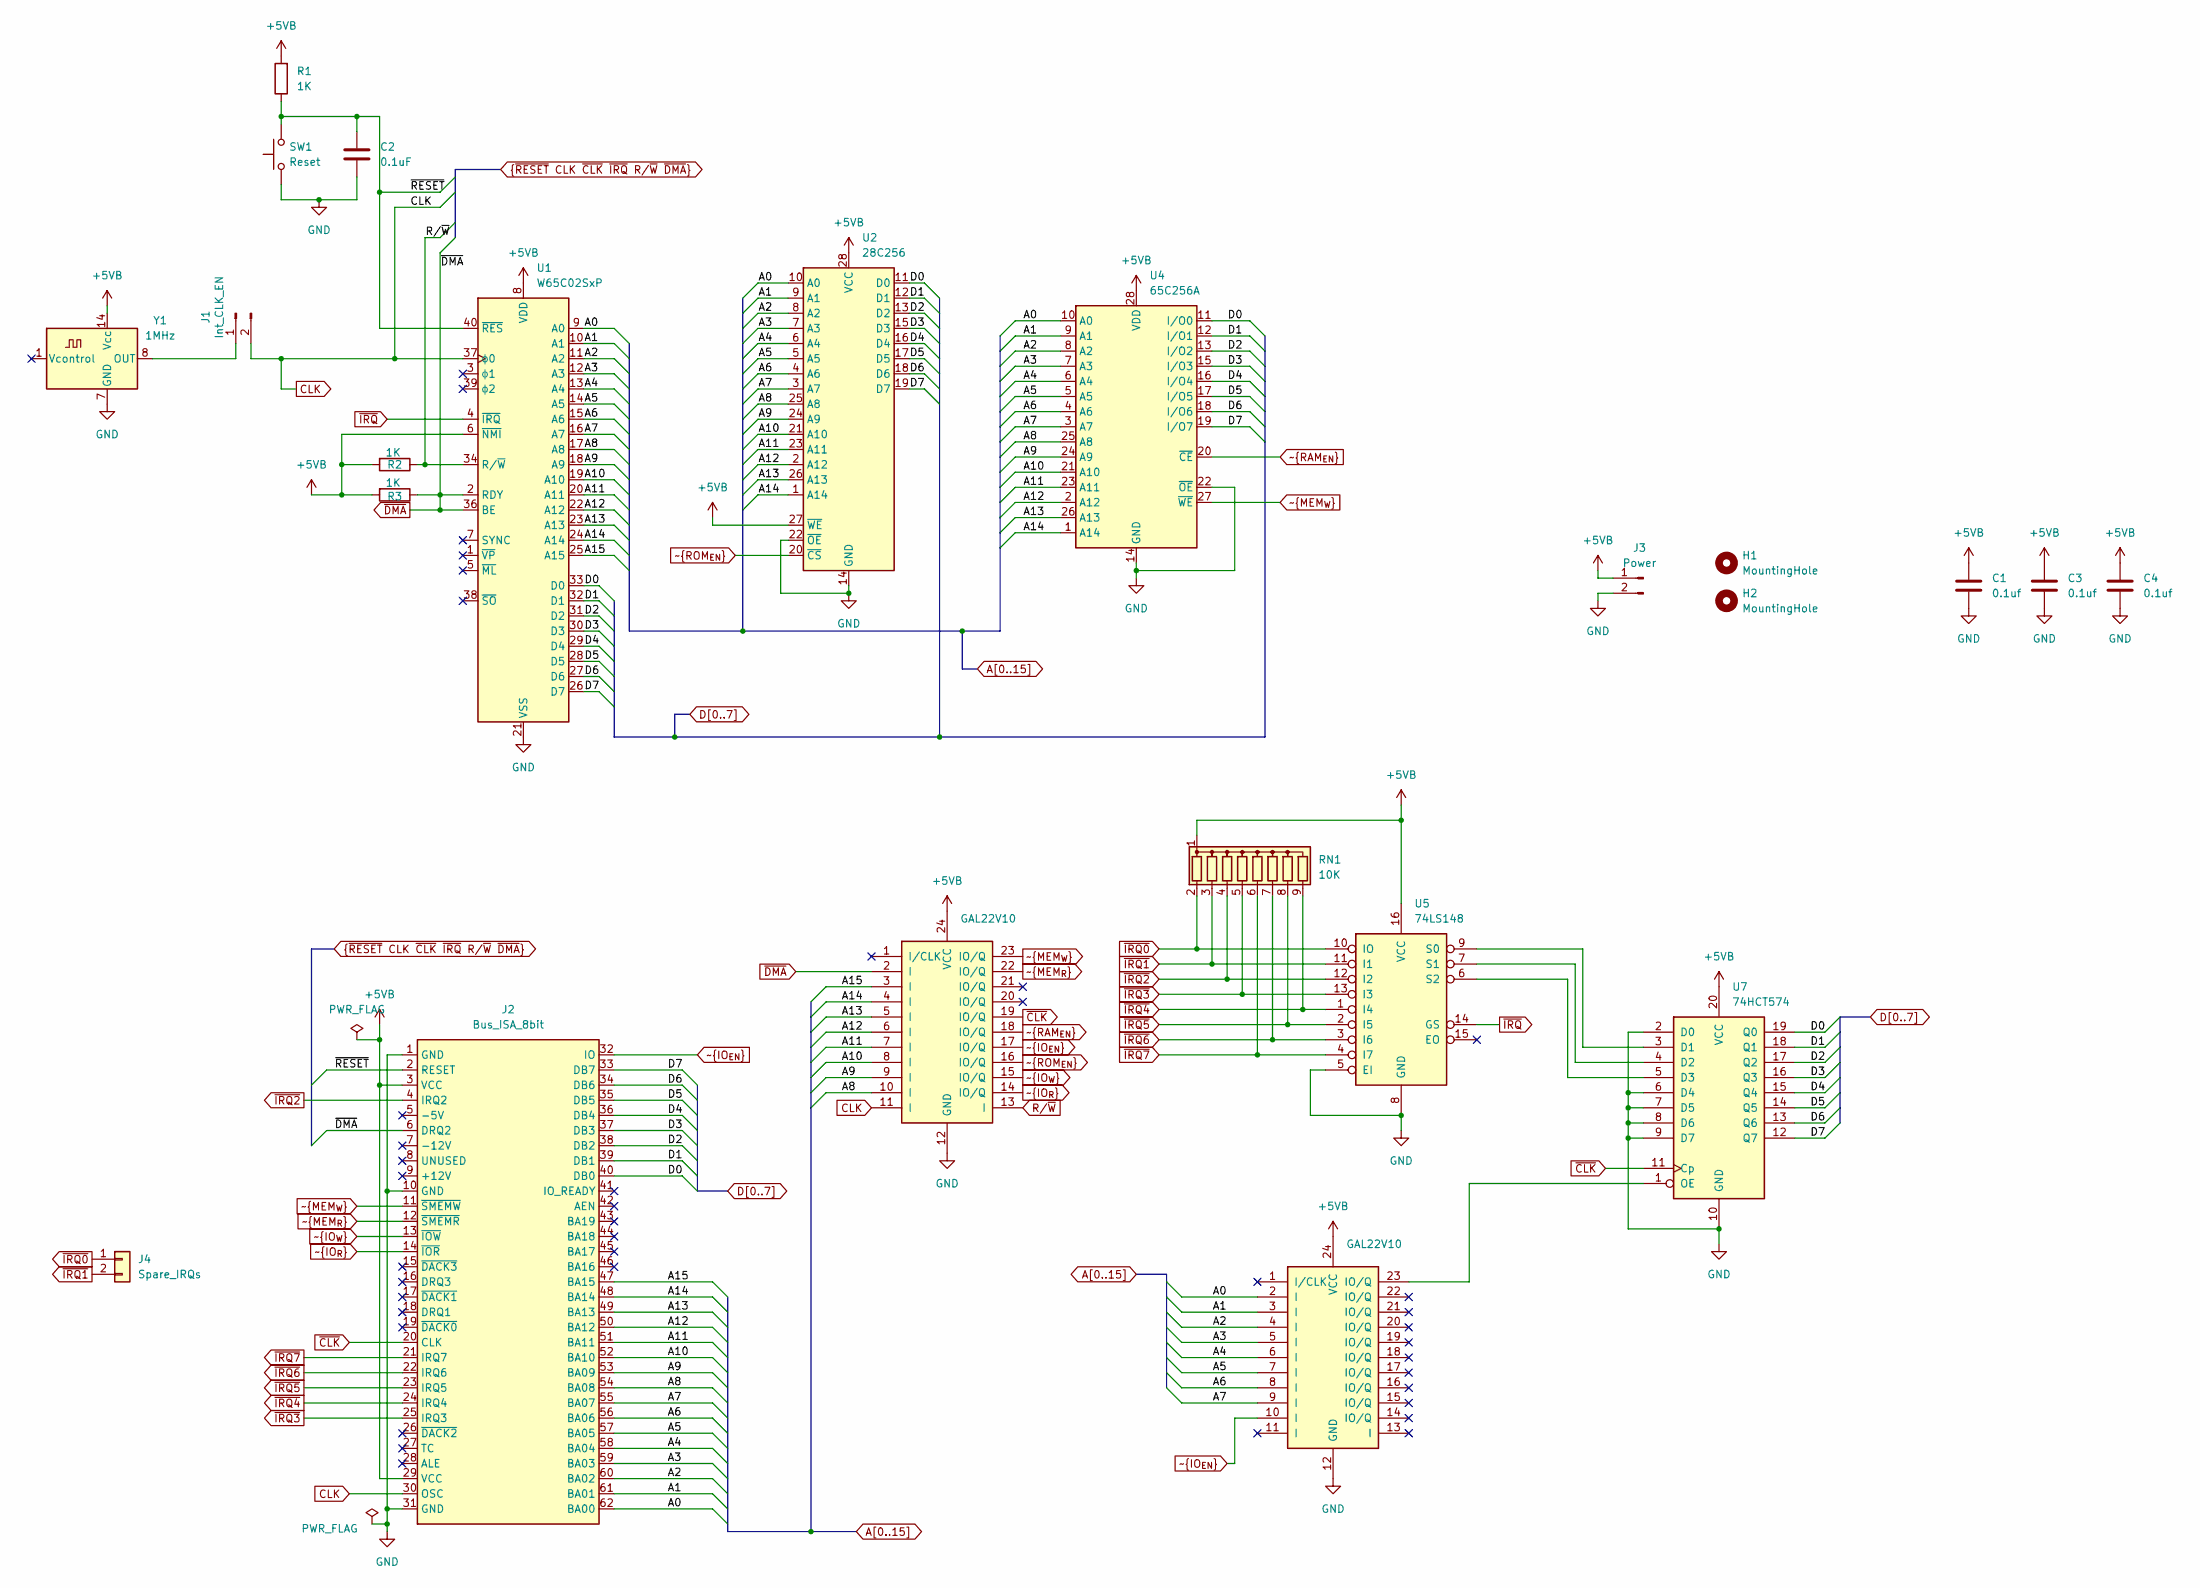
[picture p104: schematic ISA_6502_CPU.kicad_sch]

Parts:
C1, C3, C4: 0.1uf; C_Disc_D4.7mm_W2.5mm_P5.00mm
C2: 0.1uF; C_Disc_D4.7mm_W2.5mm_P5.00mm
H1, H2: MountingHole; MountingHole_3.2mm_M3
J1: Int_CLK_EN; PinHeader_1x02_P2.54mm_Vertical
J2: Bus_ISA_8bit; BUS_8-bit_ISA
J3: Power; PinHeader_1x02_P2.54mm_Vertical
J4: Spare_IRQs; PinHeader_1x02_P2.54mm_Vertical
R1, R2, R3: 1K; R_Axial_DIN0207_L6.3mm_D2.5mm_P10.16mm_Horizontal
RN1: 10K; R_Array_SIP9
SW1: Reset; SW_PUSH_6mm
U1: W65C02SxP; DIP-40_W15.24mm
U2: 28C256; DIP-28_W15.24mm
U3, U6: GAL22V10; DIP-24_W7.62mm
U4: 65C256A; DIP-28_W15.24mm
U5: 74LS148; DIP-16_W7.62mm
U7: 74HCT574; DIP-20_W7.62mm
Y1: 1MHz; Oscillator_DIP-14

Connections:
+5VB: C1.1, C3.1, C4.1, J2.3 (VCC), J2.29 (VCC), J3.1, R1.2, R2.2, R3.2, RN1.1 (common), U1.6 (~NMI), U1.8 (VDD), U2.27 (~WE), U2.28 (VCC), U3.24 (VCC), U4.28 (VDD), U5.16 (VCC), U6.24 (VCC), U7.20 (VCC), Y1.14 (Vcc)
A0: J2.62 (BA00), U1.9 (A0), U2.10 (A0), U4.10 (A0), U6.2 (I)
A1: J2.61 (BA01), U1.10 (A1), U2.9 (A1), U4.9 (A1), U6.3 (I)
A2: J2.60 (BA02), U1.11 (A2), U2.8 (A2), U4.8 (A2), U6.4 (I)
A3: J2.59 (BA03), U1.12 (A3), U2.7 (A3), U4.7 (A3), U6.5 (I)
A4: J2.58 (BA04), U1.13 (A4), U2.6 (A4), U4.6 (A4), U6.6 (I)
A5: J2.57 (BA05), U1.14 (A5), U2.5 (A5), U4.5 (A5), U6.7 (I)
A6: J2.56 (BA06), U1.15 (A6), U2.4 (A6), U4.4 (A6), U6.8 (I)
A7: J2.55 (BA07), U1.16 (A7), U2.3 (A7), U4.3 (A7), U6.9 (I)
A8: J2.54 (BA08), U1.17 (A8), U2.25 (A8), U3.10 (I), U4.25 (A8)
A9: J2.53 (BA09), U1.18 (A9), U2.24 (A9), U3.9 (I), U4.24 (A9)
A10: J2.52 (BA10), U1.19 (A10), U2.21 (A10), U3.8 (I), U4.21 (A10)
A11: J2.51 (BA11), U1.20 (A11), U2.23 (A11), U3.7 (I), U4.23 (A11)
A12: J2.50 (BA12), U1.22 (A12), U2.2 (A12), U3.6 (I), U4.2 (A12)
A13: J2.49 (BA13), U1.23 (A13), U2.26 (A13), U3.5 (I), U4.26 (A13)
A14: J2.48 (BA14), U1.24 (A14), U2.1 (A14), U3.4 (I), U4.1 (A14)
A15: J2.47 (BA15), U1.25 (A15), U3.3 (I)
CLK: J1.2, J2.30 (OSC), U1.37 (ϕ0), U3.11 (I)
D0: J2.40 (DB0), U1.33 (D0), U2.11 (D0), U4.11 (I/O0), U7.19 (Q0)
D1: J2.39 (DB1), U1.32 (D1), U2.12 (D1), U4.12 (I/O1), U7.18 (Q1)
D2: J2.38 (DB2), U1.31 (D2), U2.13 (D2), U4.13 (I/O2), U7.17 (Q2)
D3: J2.37 (DB3), U1.30 (D3), U2.15 (D3), U4.15 (I/O3), U7.16 (Q3)
D4: J2.36 (DB4), U1.29 (D4), U2.16 (D4), U4.16 (I/O4), U7.15 (Q4)
D5: J2.35 (DB5), U1.28 (D5), U2.17 (D5), U4.17 (I/O5), U7.14 (Q5)
D6: J2.34 (DB6), U1.27 (D6), U2.18 (D6), U4.18 (I/O6), U7.13 (Q6)
D7: J2.33 (DB7), U1.26 (D7), U2.19 (D7), U4.19 (I/O7), U7.12 (Q7)
GND: C1.2, C2.2, C3.2, C4.2, J2.1 (GND), J2.10 (GND), J2.31 (GND), J3.2, SW1.1, U1.21 (VSS), U2.14 (GND), U2.22 (~OE), U3.12 (GND), U4.14 (GND), U4.22 (~OE), U5.5 (EI), U5.8 (GND), U6.12 (GND), U7.2 (D0), U7.6 (D4), U7.7 (D5), U7.8 (D6), U7.9 (D7), U7.10 (GND), Y1.7 (GND)
unnamed: J1.1, Y1.8 (OUT)
unnamed: U5.9 (S0), U7.3 (D1)
unnamed: U5.7 (S1), U7.4 (D2)
unnamed: U5.6 (S2), U7.5 (D3)
unnamed: U6.23 (IO/Q), U7.1 (OE)
R/~W: R2.1, U1.34 (R/~W), U3.13 (I)
~CLK: J2.20 (CLK), U3.19 (IO/Q), U7.11 (Cp)
~DMA: J2.6 (DRQ2), R3.1, U1.2 (RDY), U1.36 (BE), U3.2 (I)
~IO_{EN}: J2.32 (IO), U3.17 (IO/Q), U6.10 (I)
~IO_{R}: J2.14 (~IOR), U3.14 (IO/Q)
~IO_{W}: J2.13 (~IOW), U3.15 (IO/Q)
~IRQ0: J4.1, RN1.2 (R1), U5.10 (IO)
~IRQ1: J4.2, RN1.3 (R2), U5.11 (I1)
~IRQ2: J2.4 (IRQ2), RN1.4 (R3), U5.12 (I2)
~IRQ3: J2.25 (IRQ3), RN1.5 (R4), U5.13 (I3)
~IRQ4: J2.24 (IRQ4), RN1.9 (R8), U5.1 (I4)
~IRQ5: J2.23 (IRQ5), RN1.8 (R7), U5.2 (I5)
~IRQ6: J2.22 (IRQ6), RN1.7 (R6), U5.3 (I6)
~IRQ7: J2.21 (IRQ7), RN1.6 (R5), U5.4 (I7)
~IRQ: U1.4 (~IRQ), U5.14 (GS)
~MEM_{R}: J2.12 (~SMEMR), U3.22 (IO/Q)
~MEM_{W}: J2.11 (~SMEMW), U3.23 (IO/Q), U4.27 (~WE)
~RAM_{EN}: U3.18 (IO/Q), U4.20 (~CE)
~RESET: C2.1, J2.2 (RESET), R1.1, SW1.2, U1.40 (~RES)
~ROM_{EN}: U2.20 (~CS), U3.16 (IO/Q)

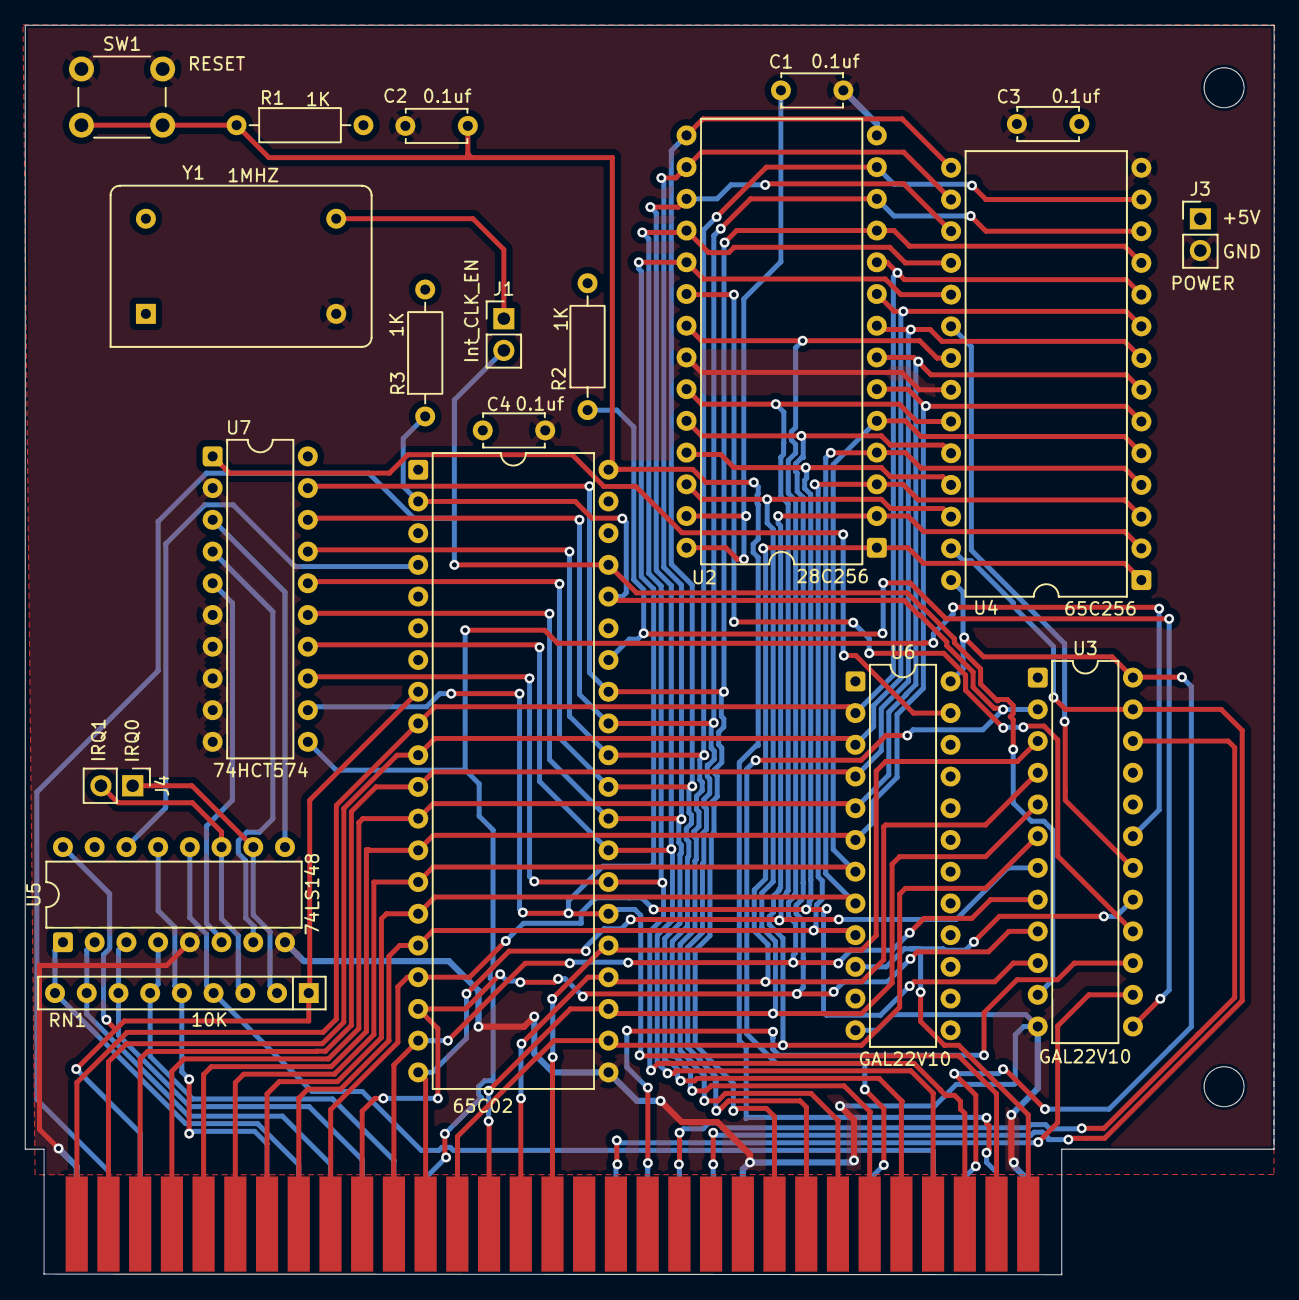
[picture p105: board ISA_6502_CPU.kicad_pcb from above]

Board: 2 copper layers, 100.0 x 100.1 mm, 23 parts (0 on the bottom side), 52 nets.
