dfmcwhir/Multi_Architecture_DIY_Computer/ISA_8085/ISA_8085.kicad_pcb

## KiCad design ISA_8085/ISA_8085.kicad_pcb (2026-11-04)

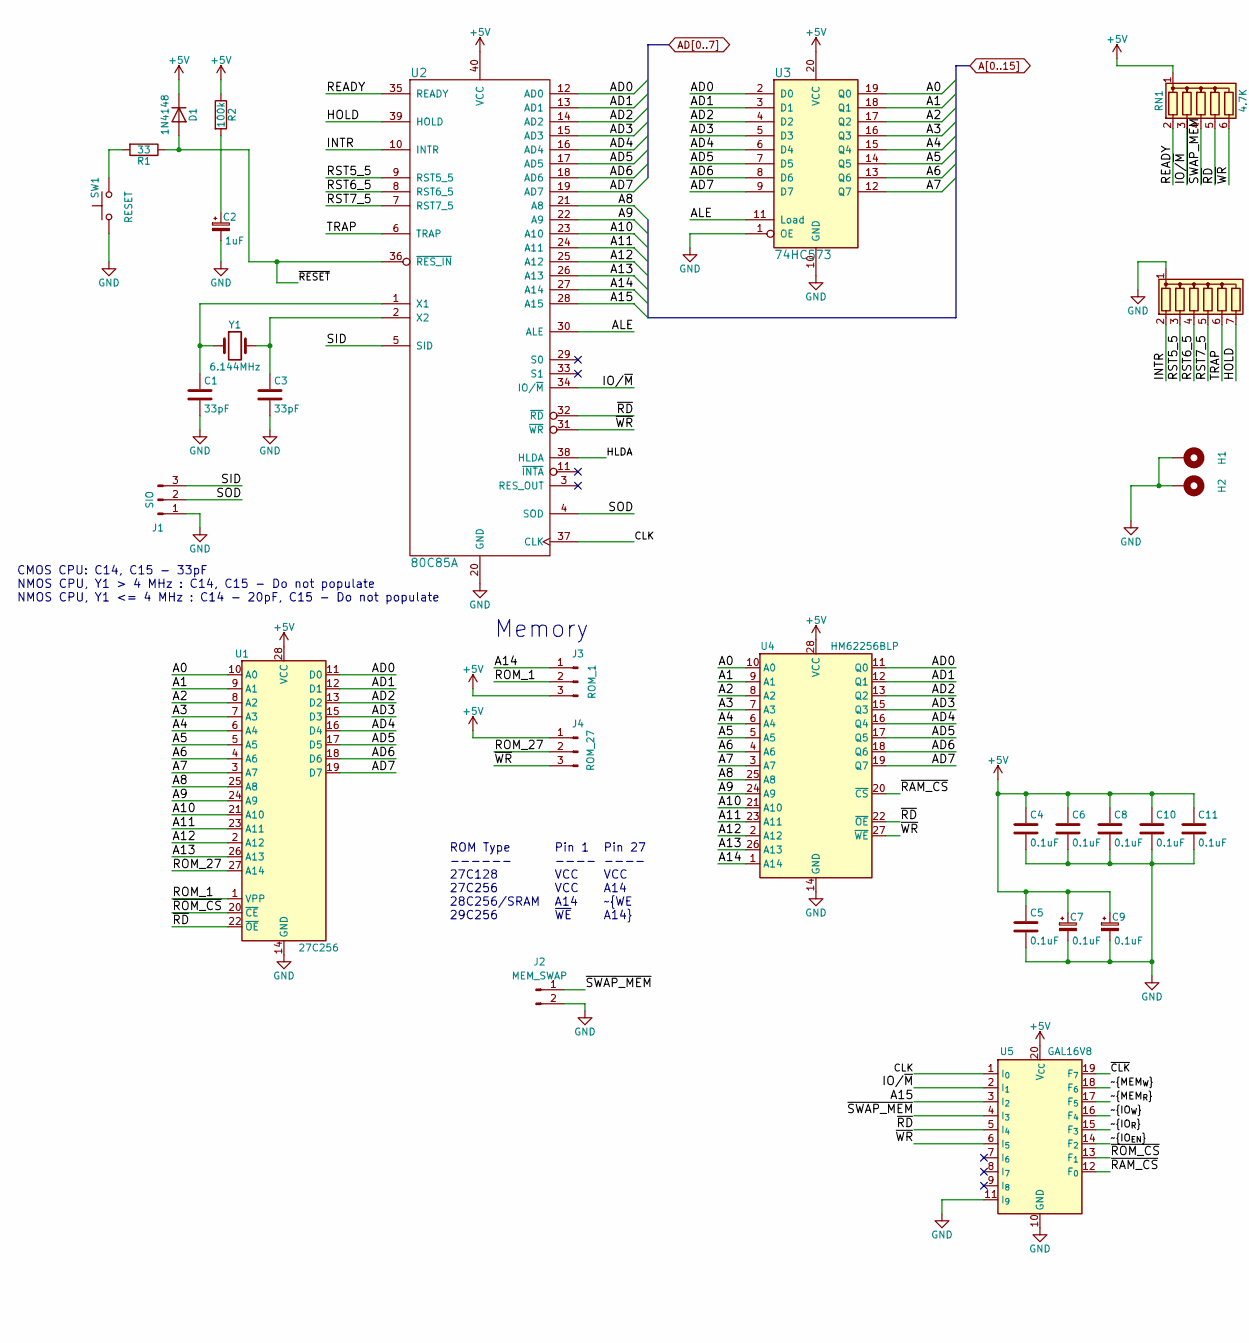
[picture p106: schematic ISA_8085.kicad_sch, part in row 1, column 1]

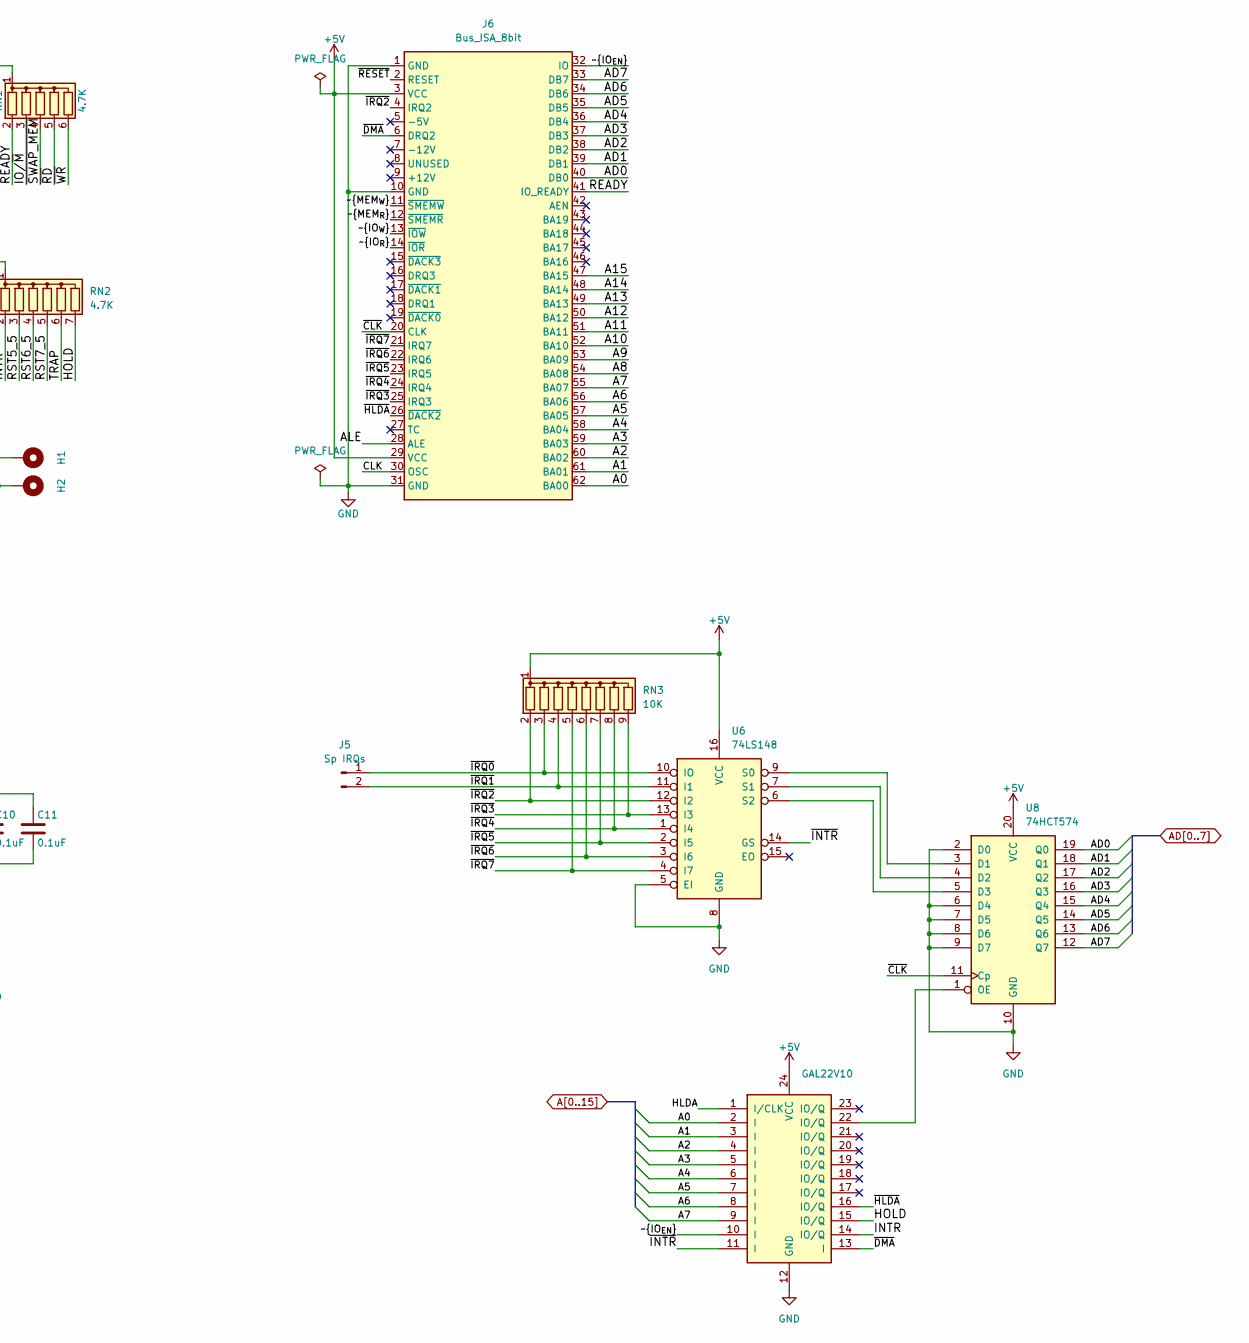
[picture p107: schematic ISA_8085.kicad_sch, part in row 1, column 2]

Parts:
C1, C3: 33pF; C_Disc_D4.7mm_W2.5mm_P5.00mm
C2: 1uF; C_Disc_D4.7mm_W2.5mm_P5.00mm
C4, C5, C6, C7, C8, C9, C10, C11: 0.1uF; C_Disc_D4.7mm_W2.5mm_P5.00mm
D1: 1N4148; D_DO-15_P10.16mm_Horizontal
H1, H2: CONN_1; MountingHole_3.2mm_M3_ISO7380_Pad
J1: SIO; PinHeader_1x03_P2.54mm_Vertical
J2: MEM_SWAP; PinHeader_1x02_P2.54mm_Vertical
J3: ROM_1; PinHeader_1x03_P2.54mm_Vertical
J4: ROM_27; PinHeader_1x03_P2.54mm_Vertical
J5: Sp IRQs; PinHeader_1x02_P2.54mm_Vertical
J6: Bus_ISA_8bit; BUS_8-bit_ISA
R1: 33; R_Axial_DIN0207_L6.3mm_D2.5mm_P10.16mm_Horizontal
R2: 100k; R_Axial_DIN0207_L6.3mm_D2.5mm_P10.16mm_Horizontal
RN1: 4.7K; R_Array_SIP6
RN2: 4.7K; R_Array_SIP7
RN3: 10K; R_Array_SIP9
SW1: RESET; SW_PUSH_6mm
U1: 27C256; DIP-28_W15.24mm
U2: 80C85A; DIP-40_W15.24mm
U3: 74HC573; DIP-20_W7.62mm
U4: HM62256BLP; DIP-28_W15.24mm
U5: GAL16V8; DIP-20_W7.62mm
U6: 74LS148; DIP-16_W7.62mm
U7: GAL22V10; DIP-24_W7.62mm
U8: 74HCT574; DIP-20_W7.62mm
Y1: 6.144MHz; Crystal_HC18-U_Vertical

Connections:
+5V: C4.1, C5.1, C6.1, C7.1, C8.1, C9.1, C10.1, C11.1, D1.1 (K), J3.3, J4.1, J6.3 (VCC), J6.29 (VCC), R2.1, RN1.1 (common), RN3.1 (common), U1.28 (VCC), U2.40 (VCC), U3.20 (VCC), U4.28 (VCC), U5.20 (V_{CC}), U6.16 (VCC), U7.24 (VCC), U8.20 (VCC)
/ALE: J6.28 (ALE), U2.30 (ALE), U3.11 (Load)
/CLK: J6.30 (OSC), U2.37 (CLK), U5.1 (I_{0})
/HLDA: U2.38 (HLDA), U7.1 (I/CLK)
/HOLD: RN2.7 (R6), U2.39 (HOLD), U7.15 (IO/Q)
/INTR: RN2.2 (R1), U2.10 (INTR), U7.14 (IO/Q)
/IO/~M: RN1.3 (R2), U2.34 (IO/~M), U5.2 (I_{1})
/READY: J6.41 (IO_READY), RN1.2 (R1), U2.35 (READY)
/ROM_1: J3.2, U1.1 (VPP)
/ROM_27: J4.2, U1.27 (A14)
/RST5_5: RN2.3 (R2), U2.9 (RST5_5)
/RST6_5: RN2.4 (R3), U2.8 (RST6_5)
/RST7_5: RN2.5 (R4), U2.7 (RST7_5)
/SID: J1.3, U2.5 (SID)
/SOD: J1.2, U2.4 (SOD)
/TRAP: RN2.6 (R5), U2.6 (TRAP)
/~CLK: J6.20 (CLK), U5.19 (F_{7}), U8.11 (Cp)
/~DMA: J6.6 (DRQ2), U7.13 (I)
/~HLDA: J6.26 (~DACK2), U7.16 (IO/Q)
/~INTR: U6.14 (GS), U7.11 (I)
/~IO_{EN}: J6.32 (IO), U5.14 (F_{2}), U7.10 (I)
/~IO_{R}: J6.14 (~IOR), U5.15 (F_{3})
/~IO_{W}: J6.13 (~IOW), U5.16 (F_{4})
/~IRQ0: J5.1, RN3.3 (R2), U6.10 (IO)
/~IRQ1: J5.2, RN3.4 (R3), U6.11 (I1)
/~IRQ2: J6.4 (IRQ2), RN3.2 (R1), U6.12 (I2)
/~IRQ3: J6.25 (IRQ3), RN3.9 (R8), U6.13 (I3)
/~IRQ4: J6.24 (IRQ4), RN3.8 (R7), U6.1 (I4)
/~IRQ5: J6.23 (IRQ5), RN3.7 (R6), U6.2 (I5)
/~IRQ6: J6.22 (IRQ6), RN3.6 (R5), U6.3 (I6)
/~IRQ7: J6.21 (IRQ7), RN3.5 (R4), U6.4 (I7)
/~MEM_{R}: J6.12 (~SMEMR), U5.17 (F_{5})
/~MEM_{W}: J6.11 (~SMEMW), U5.18 (F_{6})
/~RAM_CS: U4.20 (~CS), U5.12 (F_{0})
/~RD: RN1.5 (R4), U1.22 (~OE), U2.32 (~RD), U4.22 (~OE), U5.5 (I_{4})
/~RESET: D1.2 (A), J6.2 (RESET), R1.1, U2.36 (~RES_IN)
/~ROM_CS: U1.20 (~CE), U5.13 (F_{1})
/~SWAP_MEM: J2.1, RN1.4 (R3), U5.4 (I_{3})
/~WR: J4.3, RN1.6 (R5), U2.31 (~WR), U4.27 (~WE), U5.6 (I_{5})
A0: J6.62 (BA00), U1.10 (A0), U3.19 (Q0), U4.10 (A0), U7.2 (I)
A1: J6.61 (BA01), U1.9 (A1), U3.18 (Q1), U4.9 (A1), U7.3 (I)
A2: J6.60 (BA02), U1.8 (A2), U3.17 (Q2), U4.8 (A2), U7.4 (I)
A3: J6.59 (BA03), U1.7 (A3), U3.16 (Q3), U4.7 (A3), U7.5 (I)
A4: J6.58 (BA04), U1.6 (A4), U3.15 (Q4), U4.6 (A4), U7.6 (I)
A5: J6.57 (BA05), U1.5 (A5), U3.14 (Q5), U4.5 (A5), U7.7 (I)
A6: J6.56 (BA06), U1.4 (A6), U3.13 (Q6), U4.4 (A6), U7.8 (I)
A7: J6.55 (BA07), U1.3 (A7), U3.12 (Q7), U4.3 (A7), U7.9 (I)
A8: J6.54 (BA08), U1.25 (A8), U2.21 (A8), U4.25 (A8)
A9: J6.53 (BA09), U1.24 (A9), U2.22 (A9), U4.24 (A9)
A10: J6.52 (BA10), U1.21 (A10), U2.23 (A10), U4.21 (A10)
A11: J6.51 (BA11), U1.23 (A11), U2.24 (A11), U4.23 (A11)
A12: J6.50 (BA12), U1.2 (A12), U2.25 (A12), U4.2 (A12)
A13: J6.49 (BA13), U1.26 (A13), U2.26 (A13), U4.26 (A13)
A14: J3.1, J6.48 (BA14), U2.27 (A14), U4.1 (A14)
A15: J6.47 (BA15), U2.28 (A15), U5.3 (I_{2})
AD0: J6.40 (DB0), U1.11 (D0), U2.12 (AD0), U3.2 (D0), U4.11 (Q0), U8.19 (Q0)
AD1: J6.39 (DB1), U1.12 (D1), U2.13 (AD1), U3.3 (D1), U4.12 (Q1), U8.18 (Q1)
AD2: J6.38 (DB2), U1.13 (D2), U2.14 (AD2), U3.4 (D2), U4.13 (Q2), U8.17 (Q2)
AD3: J6.37 (DB3), U1.15 (D3), U2.15 (AD3), U3.5 (D3), U4.15 (Q3), U8.16 (Q3)
AD4: J6.36 (DB4), U1.16 (D4), U2.16 (AD4), U3.6 (D4), U4.16 (Q4), U8.15 (Q4)
AD5: J6.35 (DB5), U1.17 (D5), U2.17 (AD5), U3.7 (D5), U4.17 (Q5), U8.14 (Q5)
AD6: J6.34 (DB6), U1.18 (D6), U2.18 (AD6), U3.8 (D6), U4.18 (Q6), U8.13 (Q6)
AD7: J6.33 (DB7), U1.19 (D7), U2.19 (AD7), U3.9 (D7), U4.19 (Q7), U8.12 (Q7)
GND: C1.2, C2.2, C3.2, C4.2, C5.2, C6.2, C7.2, C8.2, C9.2, C10.2, C11.2, H1.1 (1_1), H2.1 (1_1), J1.1, J2.2, J6.1 (GND), J6.10 (GND), J6.31 (GND), RN2.1 (common), SW1.1, U1.14 (GND), U2.20 (GND), U3.1 (OE), U3.10 (GND), U4.14 (GND), U5.10 (GND), U5.11 (I_{9}), U6.5 (EI), U6.8 (GND), U7.12 (GND), U8.2 (D0), U8.6 (D4), U8.7 (D5), U8.8 (D6), U8.9 (D7), U8.10 (GND)
unnamed: C2.1, R2.2
unnamed: R1.2, SW1.2
unnamed: C1.1, U2.1 (X1), Y1.1
unnamed: C3.1, U2.2 (X2), Y1.2
unnamed: U6.9 (S0), U8.3 (D1)
unnamed: U6.7 (S1), U8.4 (D2)
unnamed: U6.6 (S2), U8.5 (D3)
unnamed: U7.22 (IO/Q), U8.1 (OE)

Notes on the sheet:
Memory
Pin 1 ---- VCC VCC A14 ~{WE}
CMOS CPU: C14, C15 - 33pF NMOS CPU, Y1 > 4 MHz : C14, C15 - Do not populate NMOS CPU, Y1 <= 4 MHz : C14 - 20pF, C15 - Do not populate
ROM Type ------ 27C128 27C256 28C256/SRAM 29C256
Pin 27 ---- VCC A14 ~{WE A14}
