dfmcwhir/Multi_Architecture_DIY_Computer/ISA_8085/ISA_8085.kicad_pcb

## KiCad design ISA_8085/ISA_8085.kicad_pcb (continued)

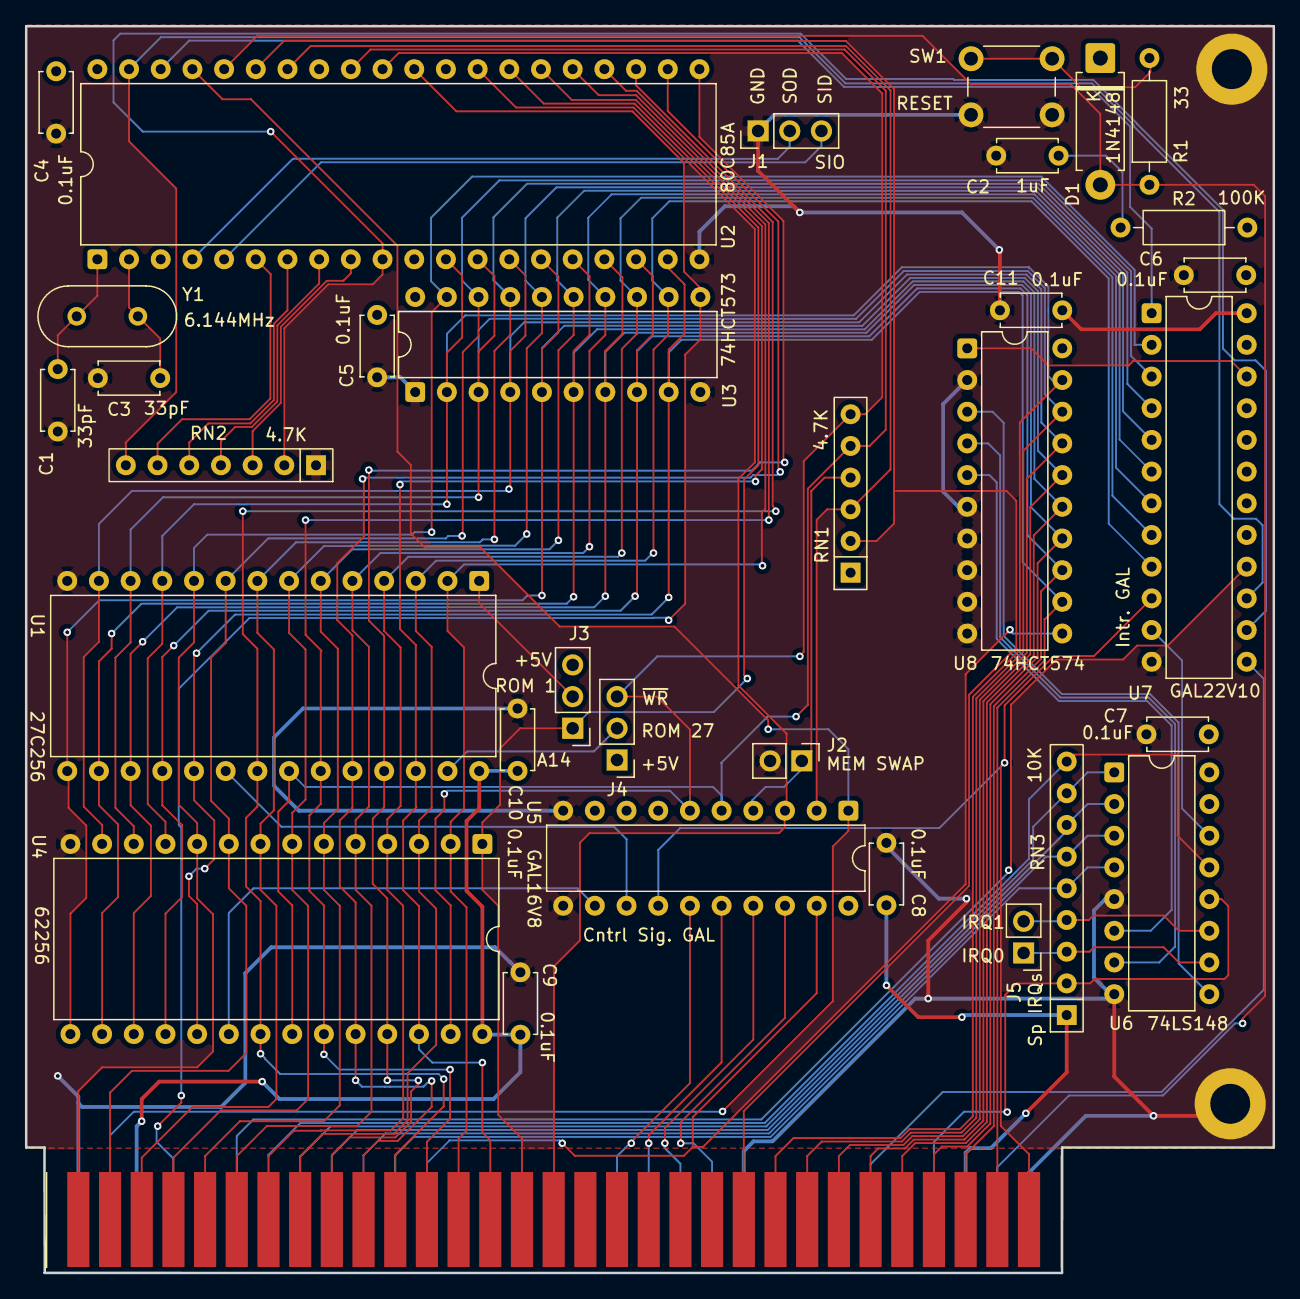
[picture p108: board ISA_8085.kicad_pcb from above]

Board: 2 copper layers, 100.0 x 99.9 mm, 35 parts (0 on the bottom side), 72 nets.
