dfmcwhir/Multi_Architecture_DIY_Computer/(commit log)

2026-11-04 Clarify B8 pin description in README
    Updated description for B8 pin in the table.
2026-11-04 Add temporary file tmp.tmp to Interrupt_DEC directory
2026-11-04 Add README with assembly commands for boot_bios
    Add assembly instructions for boot_bios
2026-11-05 Update README with tinybasic port details
    Added description of tinybasic port and assembly commands.
2026-11-05 Update README with clearer /DMA signal explanation
    Clarified the explanation regarding the /DMA signal and its implications for future speed increases. Adjusted wording for better clarity and corrected minor grammatical issues.
2026-11-05 Update README with current memory map and I/O details
    Added current memory map and details for I/O addresses.
2026-11-05 Add README for AY-3-8910 sound card
    This README introduces the AY-3-8910 sound card based on the FABGL ESP32 library, detailing its features, resources, and potential applications.
2026-11-06 Enhance README.md with detailed software documentation
    Expanded the README.md to include detailed instructions for EhBasic, boot menu options, file commands, memory map, verification, tools for tokenizing BASIC, I2C and LCD keywords, monitor commands, NES gamepad integration, and fixed entry points for custom programs.
